yamamo2shun1/PICrouter/Eagle_Files/pdf/PICrouter_brd_all.pdf

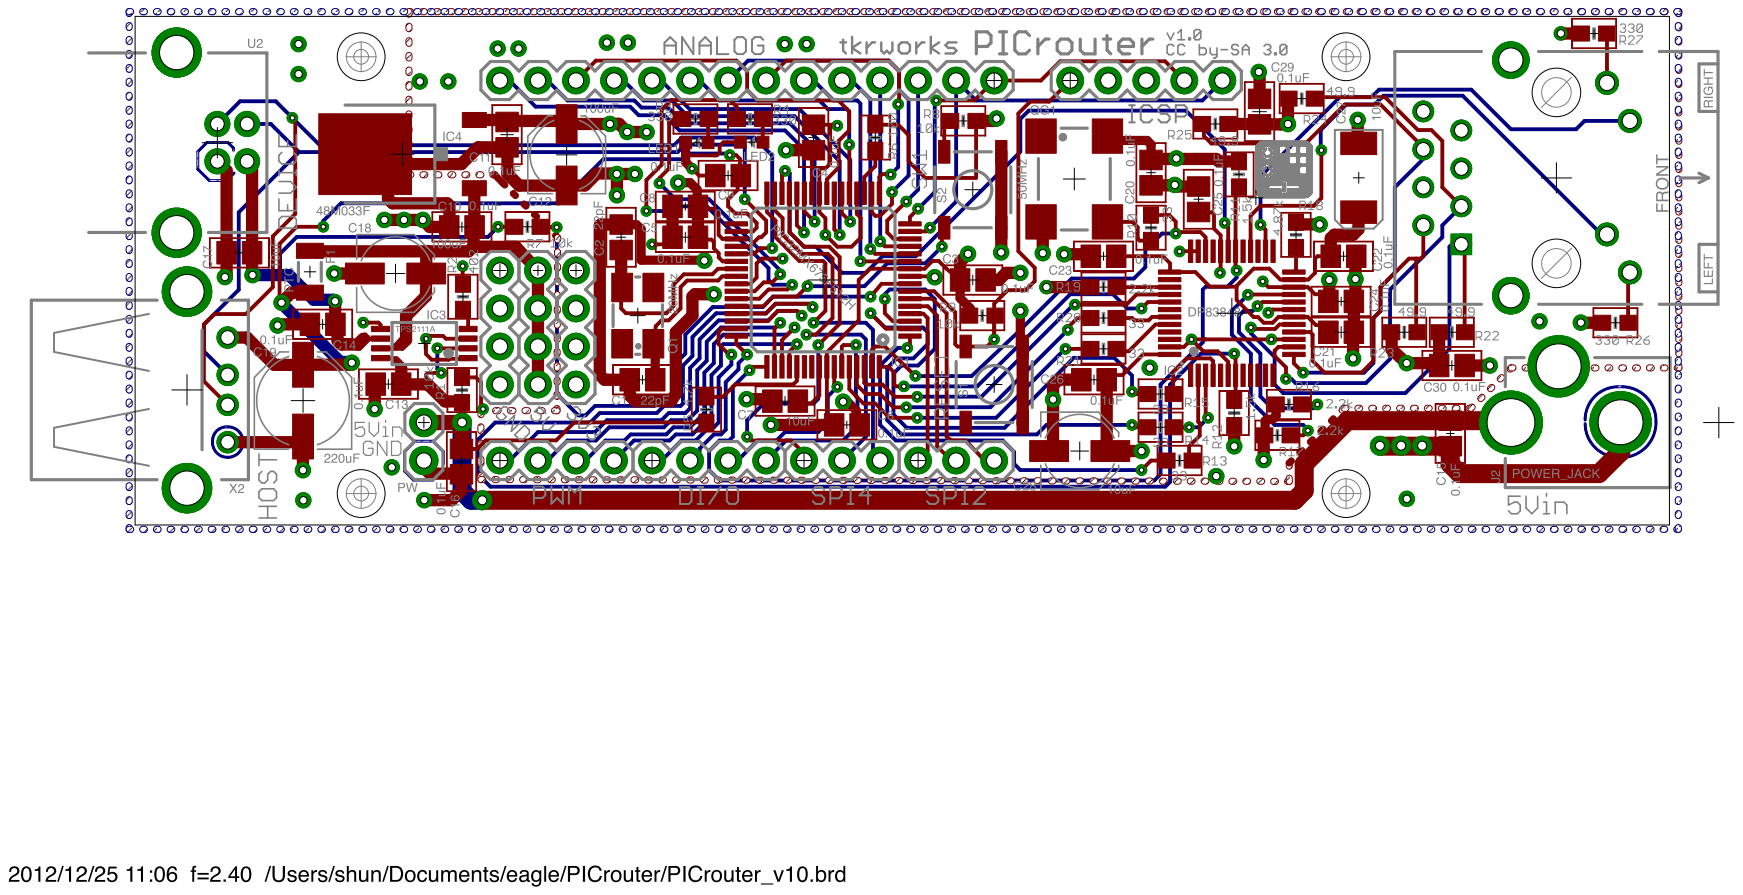
[picture p1: page 1]
