yamamo2shun1/PICrouter/Eagle_Files/pdf/PICrouter_brd_bottom.pdf

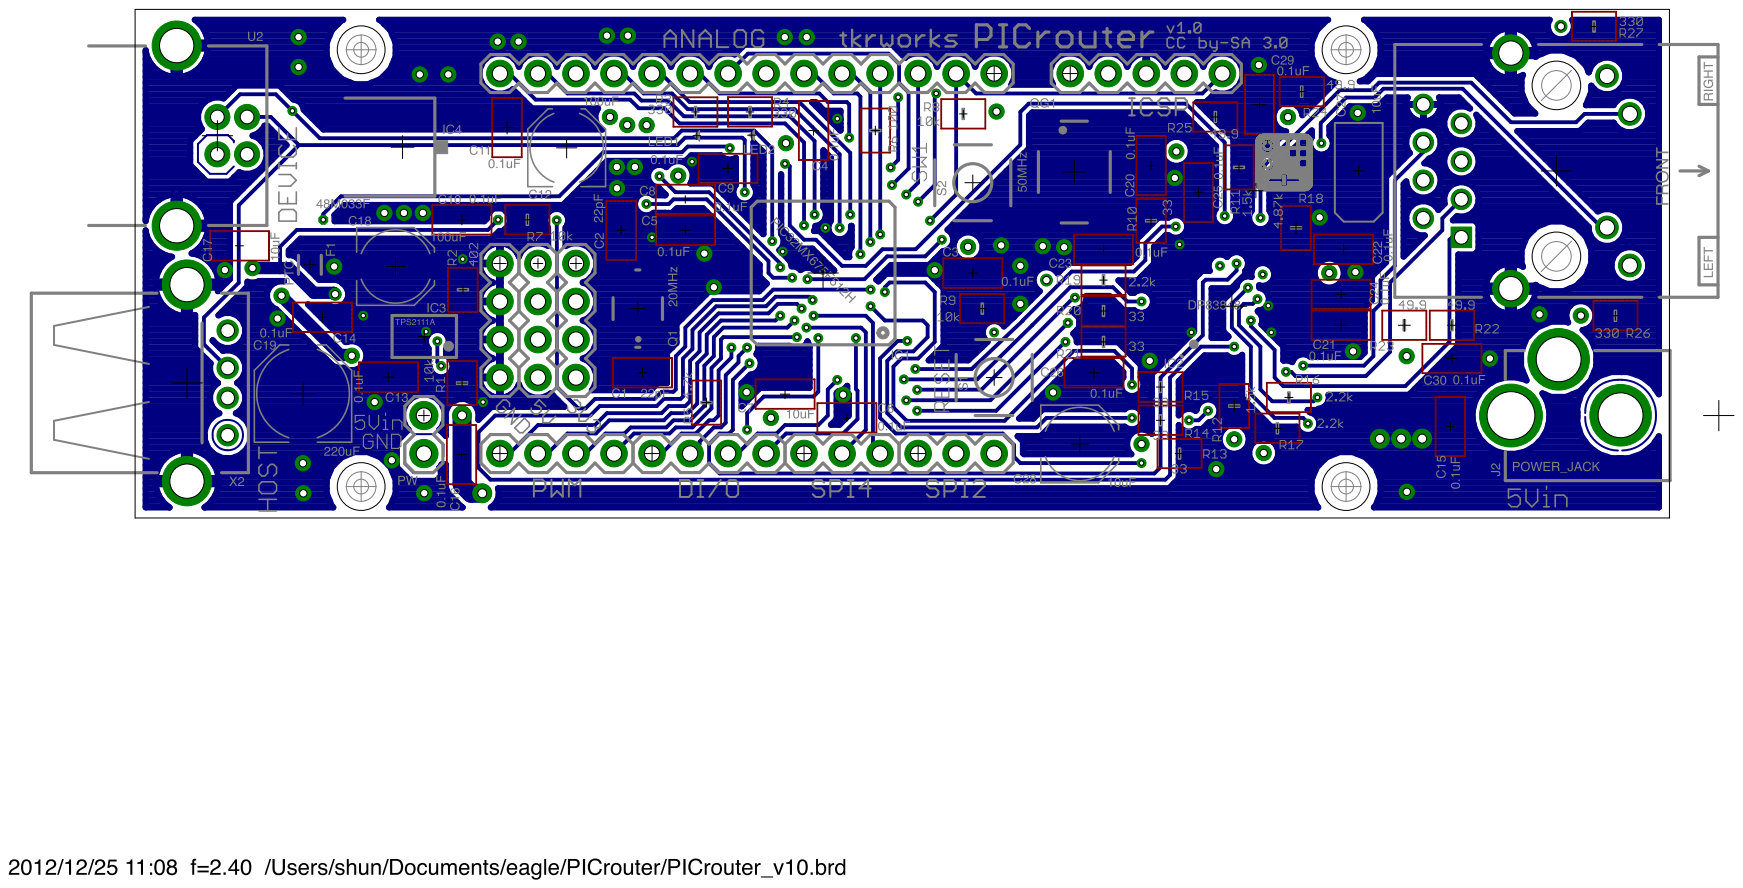
[picture p2: page 1]
