yamamo2shun1/PICrouter/Eagle_Files/pdf/PICrouter_brd_layer2.pdf

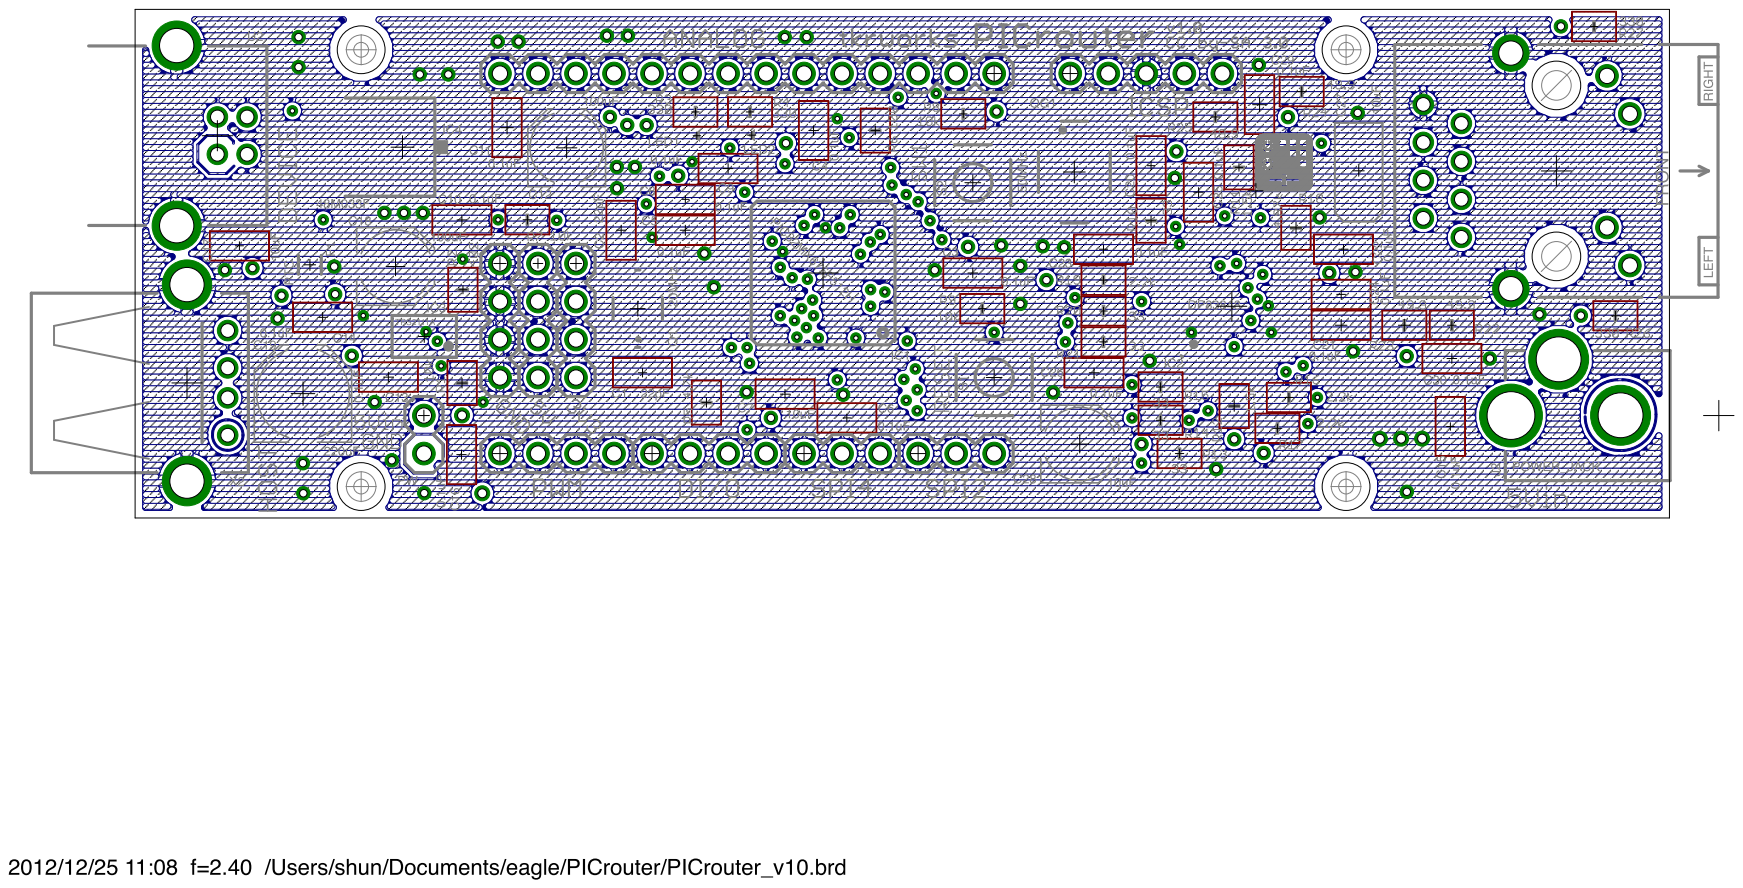
[picture p3: page 1]
