yamamo2shun1/PICrouter/Eagle_Files/pdf/PICrouter_brd_layer3.pdf

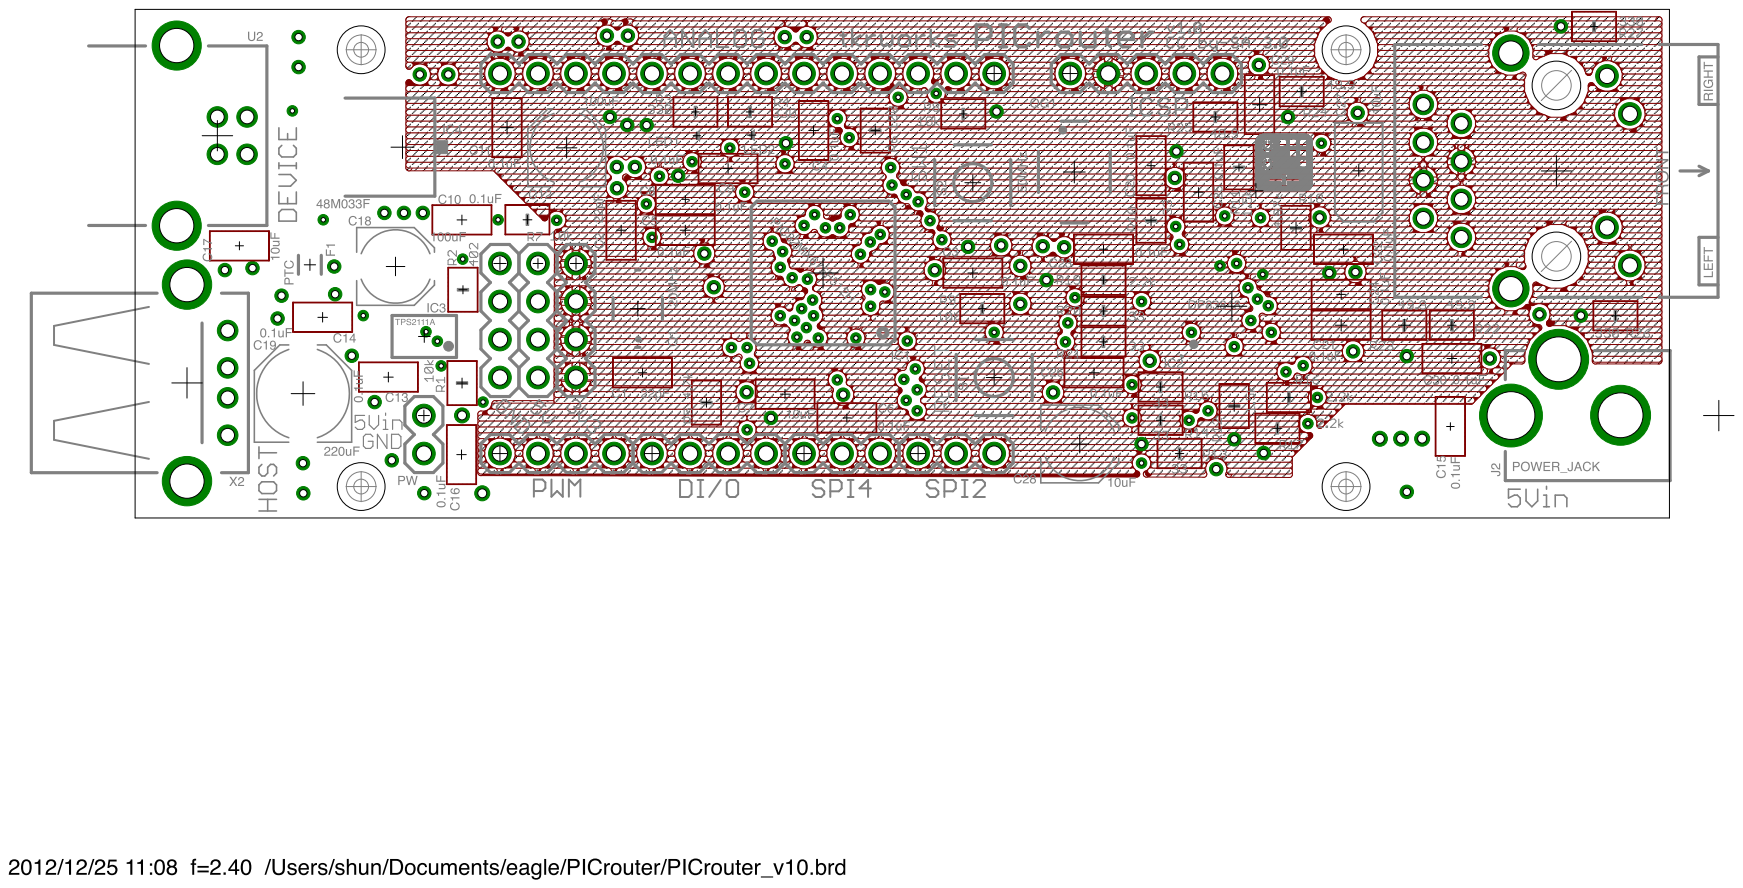
[picture p4: page 1]
