yamamo2shun1/PICrouter/Eagle_Files/pdf/PICrouter_brd_top.pdf

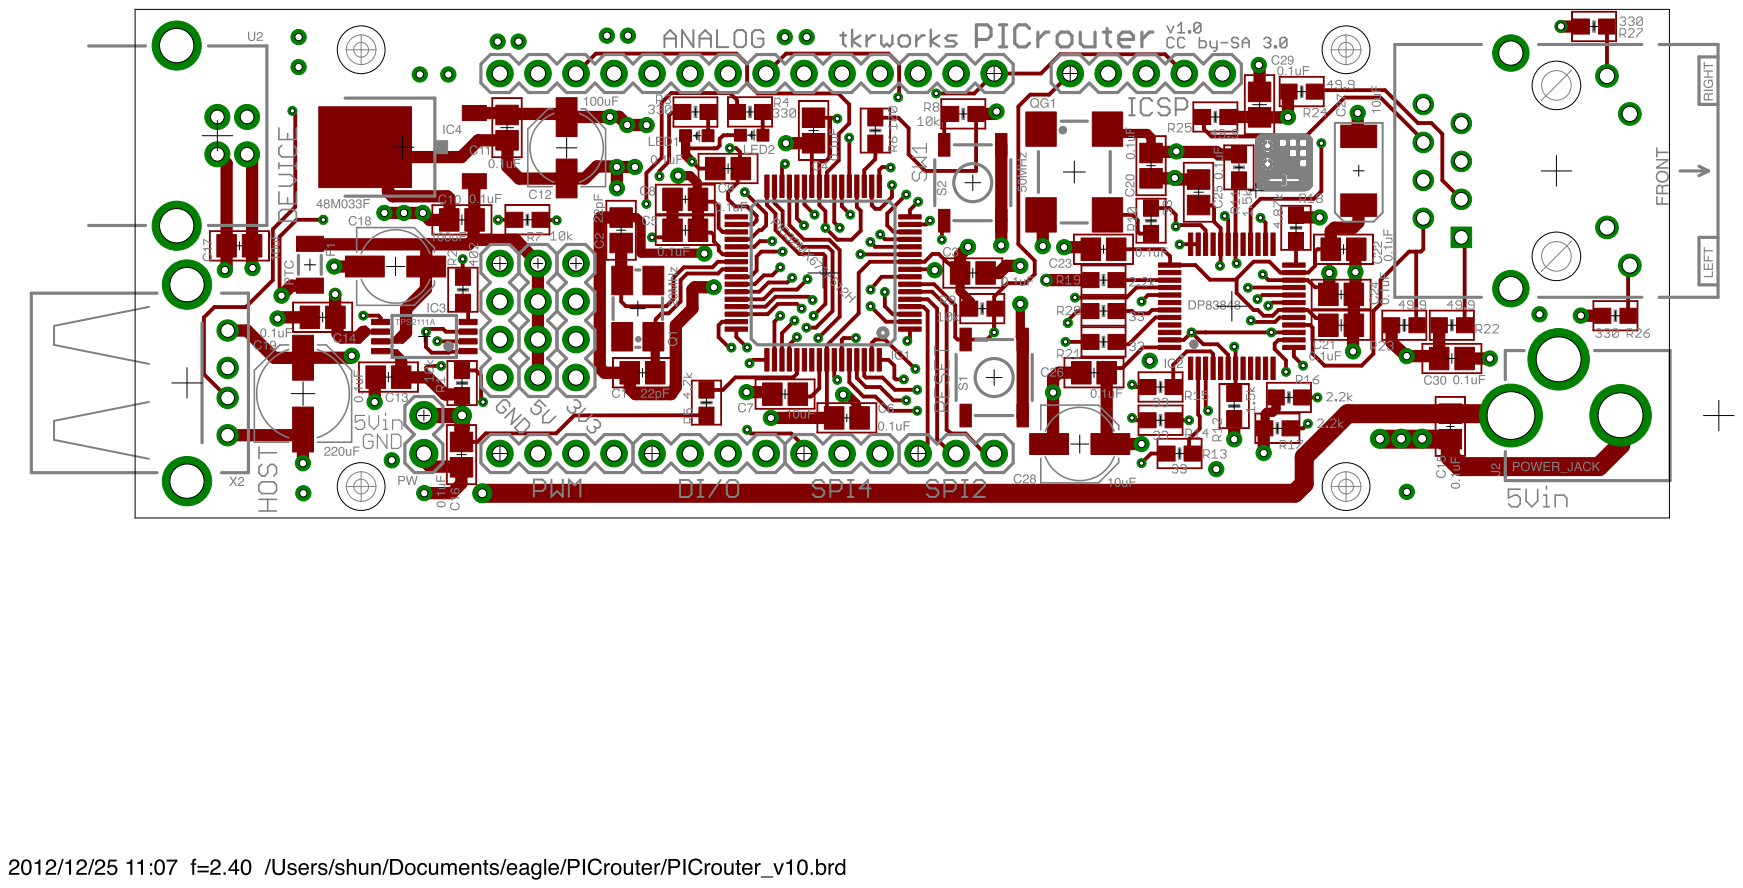
[picture p5: page 1]
