yamamo2shun1/PICrouter/Eagle_Files/pdf/PICrouter_sch_s0.pdf

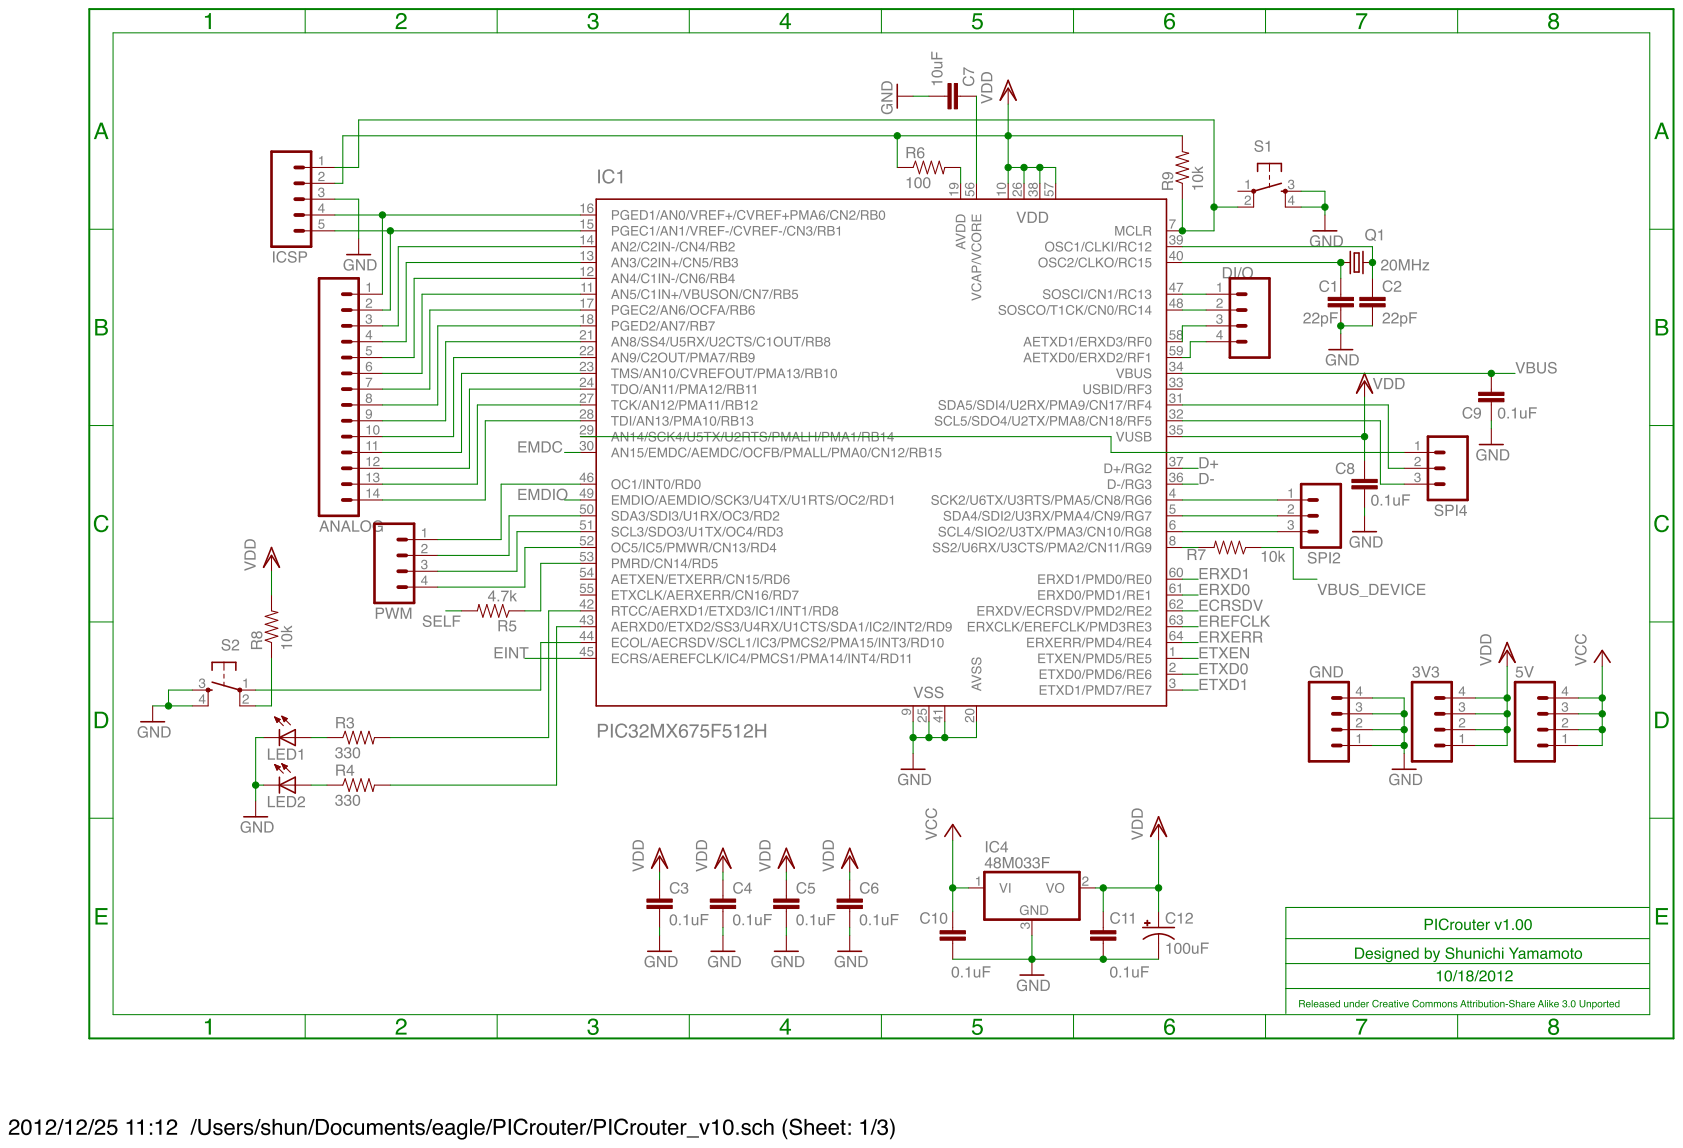
[picture p6: page 1]
