yamamo2shun1/PICrouter/Eagle_Files/pdf/PICrouter_sch_s1.pdf

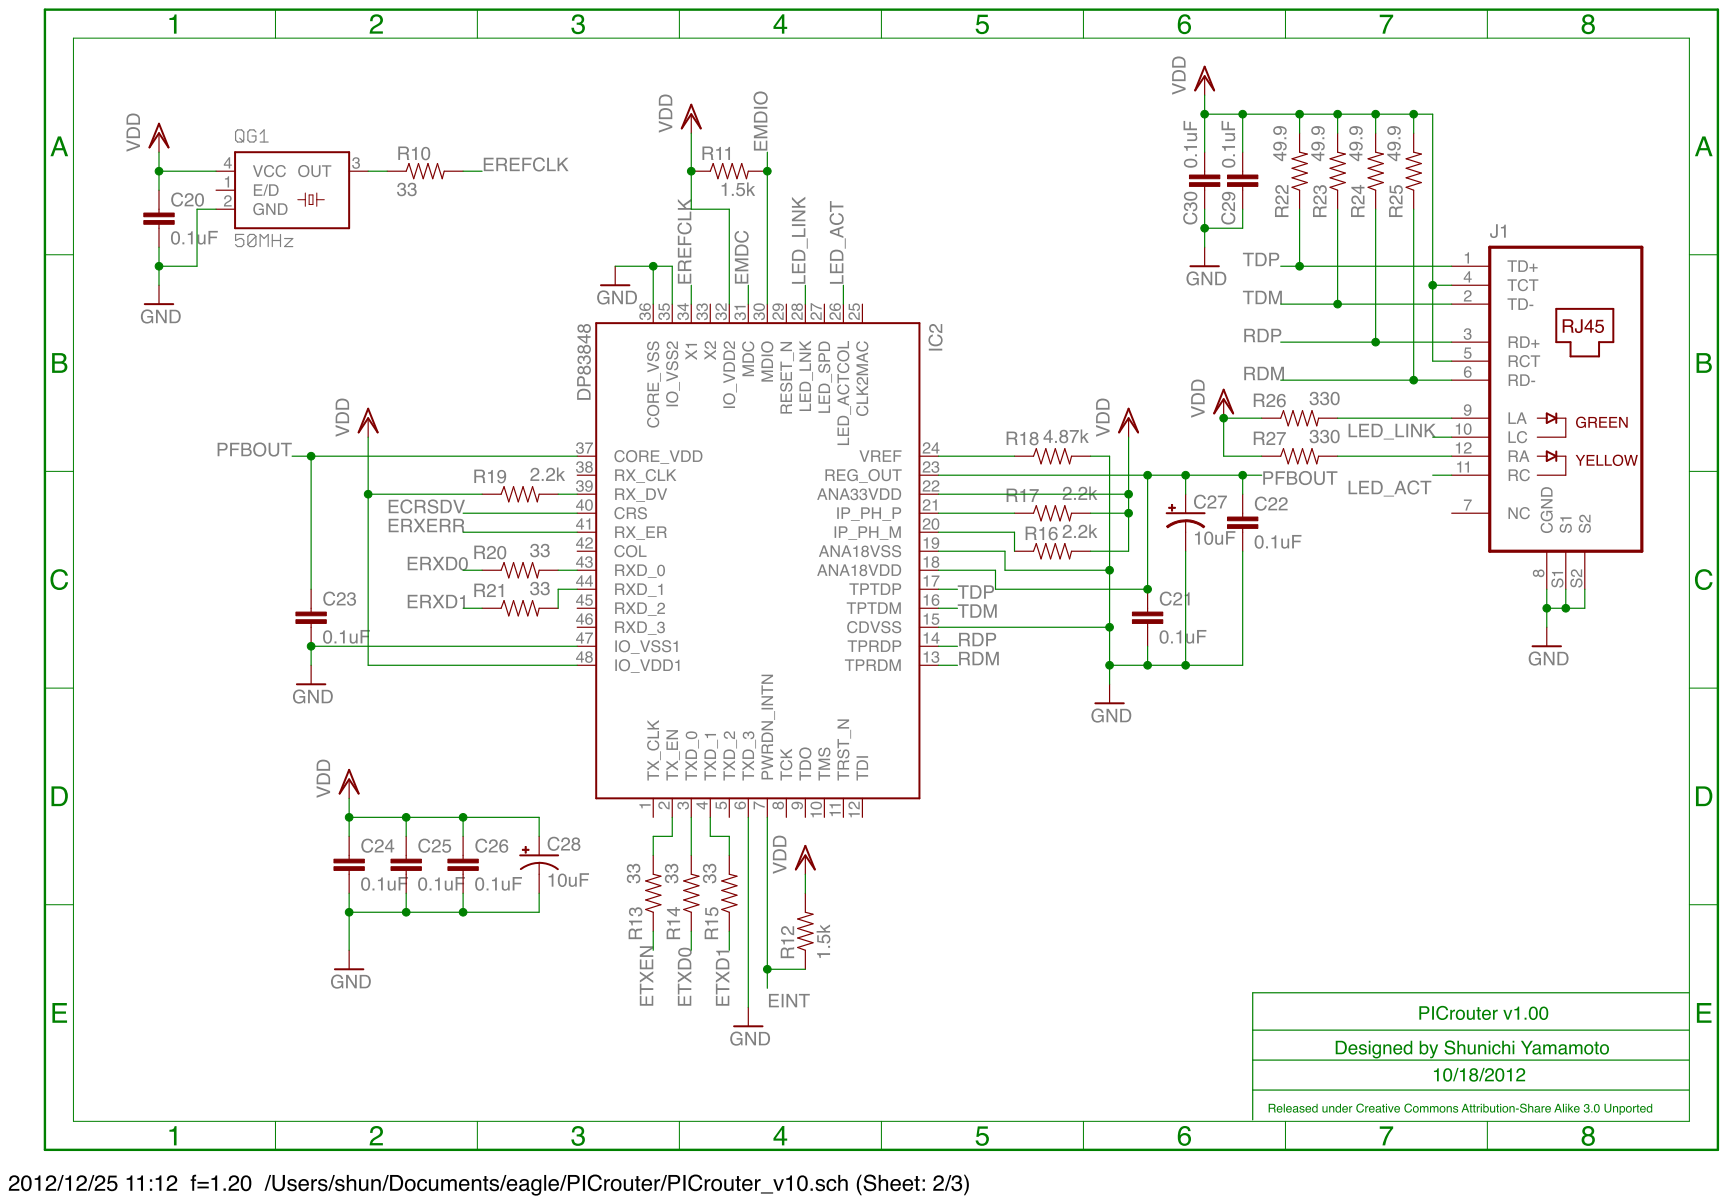
[picture p7: page 1]
