yamamo2shun1/PICrouter/Eagle_Files/pdf/PICrouter_sch_s2.pdf

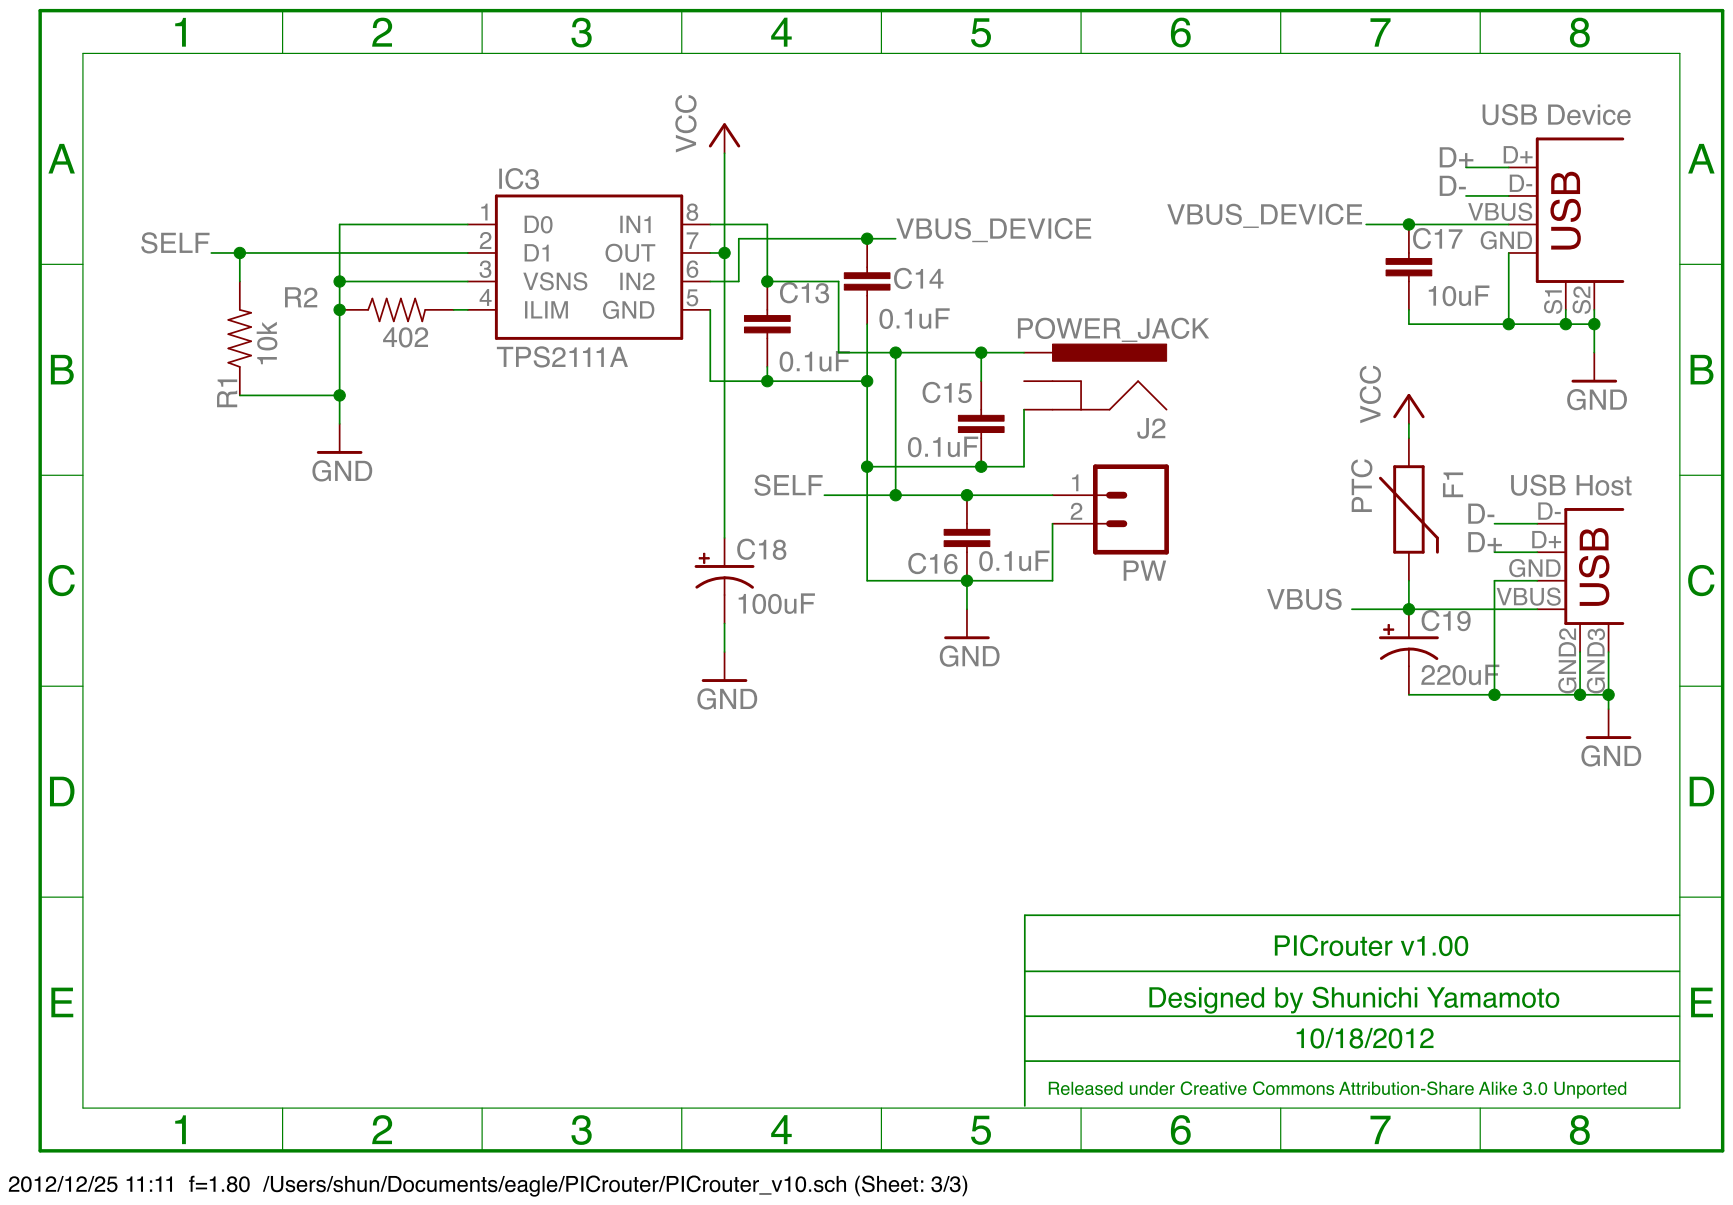
[picture p8: page 1]
