yamamo2shun1/PICrouter/Eagle_Files/PICrouter.brd

## EAGLE design Eagle_Files/PICrouter.brd (2012-12-25)

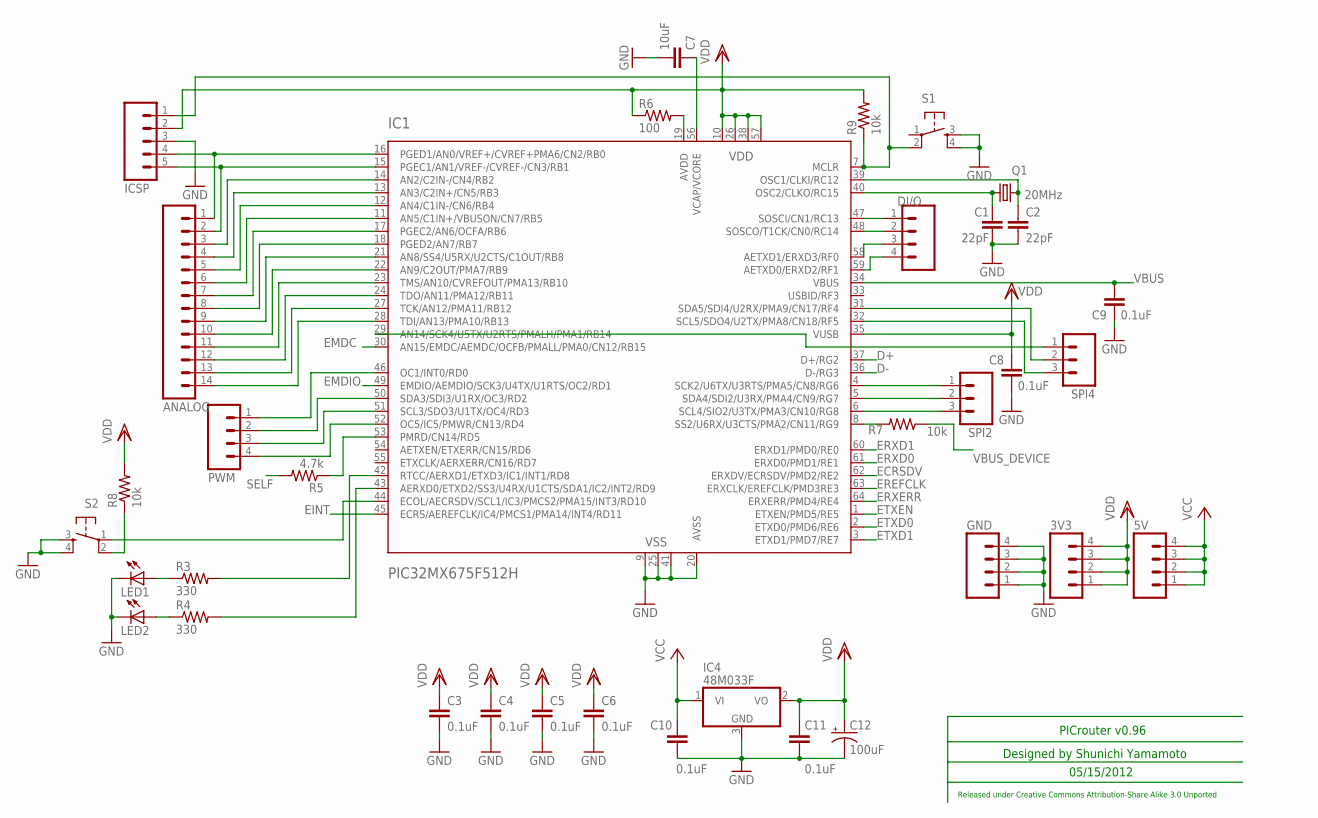
[picture p9: schematic PICrouter.sch, sheet 1]

Parts:
3V3, 5V: M04PTH; 1X04
ANALOG: M14; 1X14
C1, C2: 22pF; C2012
C3, C4, C5, C6, C8, C9, C10, C11: 0.1uF; C2012
C7: 10uF; C2012
C12: 100uF; PANASONIC_C
DI/O: M04PTH; 1X04
GND: M04PTH; 1X04
IC1: PIC32MX675F512H; TQFP64-10X10
IC4: 48M033F; TO252
ICSP: M05PTH; 1X05
LED1, LED2: LEDCHIP-LED0603; CHIP-LED0603
PWM: M04PTH; 1X04
Q1: 20MHz; CTS406
R3, R4: 330; 0603-RES
R5: 4.7k; 0603-RES
R6: 100; 0603-RES
R7, R8, R9: 10k; 0603-RES
S1, S2: TAC_SWITCHSMD; TACTILE_SWITCH_SMD
SPI2, SPI4: M03PTH; 1X03

Connections:
D+: IC1.37 (D+/RG2); also elsewhere on the board
D-: IC1.36 (D-/RG3); also elsewhere on the board
ECRSDV: IC1.62 (ERXDV/ECRSDV/PMD2/RE2); also elsewhere on the board
EINT: IC1.45 (ECRS/AEREFCLK/IC4/PMCS1/PMA14/INT4/RD11); also elsewhere on the board
EMDC: IC1.30 (AN15/EMDC/AEMDC/OCFB/PMALL/PMA0/CN12/RB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); also elsewhere on the board
EMDIO: IC1.49 (EMDIO/AEMDIO/SCK3/U4TX/U1RTS/OC2/RD1); also elsewhere on the board
EREFCLK: IC1.63 (ERXCLK/EREFCLK/PMD3RE3); also elsewhere on the board
ERXD0: IC1.61 (ERXD0/PMD1/RE1); also elsewhere on the board
ERXD1: IC1.60 (ERXD1/PMD0/RE0); also elsewhere on the board
ERXERR: IC1.64 (ERXERR/PMD4/RE4); also elsewhere on the board
ETXD0: IC1.2 (ETXD0/PMD6/RE6); also elsewhere on the board
ETXD1: IC1.3 (ETXD1/PMD7/RE7); also elsewhere on the board
ETXEN: IC1.1 (ETXEN/PMD5/RE5); also elsewhere on the board
GND: C1.2, C2.2, C3.2, C4.2, C5.2, C6.2, C7.2, C8.2, C9.1, C10.2, C11.2, C12.-, GND.1, GND.2, GND.3, GND.4, IC1.9 (GND), IC1.20 (AVSS), IC1.25 (GND), IC1.41 (GND), IC4.3 (GND), ICSP.3, LED1.C, LED2.C, S1.3, S1.4, S2.3, S2.4; also elsewhere on the board
unnamed: C2.1, IC1.39 (OSC1/CLKI/RC12), Q1.3 (2)
unnamed: C1.1, IC1.40 (OSC2/CLKO/RC15), Q1.1
unnamed: ANALOG.2, IC1.15 (PGEC1/AN1/VREF-/CVREF-/CN3/RB1), ICSP.5
unnamed: ANALOG.1, IC1.16 (PGED1/AN0/VREF+/CVREF+PMA6/CN2/RB0), ICSP.4
unnamed: IC1.7 (MCLR), ICSP.1, R9.1, S1.2
unnamed: C7.1, IC1.56 (VCAP/VCORE)
unnamed: R8.1, S2.2
unnamed: IC1.19 (AVDD), R6.2
unnamed: IC1.53 (PMRD/CN14/RD5), R5.1
unnamed: IC1.8 (SS2/U6RX/U3CTS/PMA2/CN11/RG9), R7.2
unnamed: IC1.42 (RTCC/AERXD1/ETXD3/IC1/INT1/RD8), R3.2
unnamed: IC1.43 (AERXD0/ETXD2/SS3/U4RX/U1CTS/SDA1/IC2/IN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), R4.2
unnamed: LED1.A, R3.1
unnamed: LED2.A, R4.1
unnamed: IC1.44 (ECOL/AECRSDV/SCL1/IC3/PMCS2/PMA15/INT3/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), S2.1
unnamed: ANALOG.3, IC1.14 (AN2/C2IN-/CN4/RB2)
unnamed: ANALOG.4, IC1.13 (AN3/C2IN+/CN5/RB3)
unnamed: ANALOG.5, IC1.12 (AN4/C1IN-/CN6/RB4)
unnamed: ANALOG.6, IC1.11 (AN5/C1IN+/VBUSON/CN7/RB5)
unnamed: ANALOG.7, IC1.17 (PGEC2/AN6/OCFA/RB6)
unnamed: ANALOG.8, IC1.18 (PGED2/AN7/RB7)
unnamed: ANALOG.9, IC1.21 (AN8/SS4/U5RX/U2CTS/C1OUT/RB8)
unnamed: ANALOG.10, IC1.22 (AN9/C2OUT/PMA7/RB9)
unnamed: ANALOG.11, IC1.23 (TMS/AN10/CVREFOUT/PMA13/RB10)
unnamed: ANALOG.12, IC1.24 (TDO/AN11/PMA12/RB11)
unnamed: ANALOG.13, IC1.27 (TCK/AN12/PMA11/RB12)
unnamed: ANALOG.14, IC1.28 (TDI/AN13/PMA10/RB13)
unnamed: IC1.4 (SCK2/U6TX/U3RTS/PMA5/CN8/RG6), SPI2.1
unnamed: IC1.5 (SDA4/SDI2/U3RX/PMA4/CN9/RG7), SPI2.2
unnamed: IC1.6 (SCL4/SIO2/U3TX/PMA3/CN10/RG8), SPI2.3
unnamed: IC1.31 (SDA5/SDI4/U2RX/PMA9/CN17/RF4), SPI4.2
unnamed: IC1.32 (SCL5/SDO4/U2TX/PMA8/CN18/RF5), SPI4.3
unnamed: IC1.29 (AN14/SCK4/U5TX/U2RTS/PMALH/PMA1/RB14), SPI4.1
unnamed: IC1.46 (OC1/INT0/RD0), PWM.1
unnamed: DI/O.1, IC1.47 (SOSCI/CN1/RC13)
unnamed: IC1.50 (SDA3/SDI3/U1RX/OC3/RD2), PWM.2
unnamed: IC1.51 (SCL3/SDO3/U1TX/OC4/RD3), PWM.3
unnamed: IC1.52 (OC5/IC5/PMWR/CN13/RD4), PWM.4
unnamed: DI/O.2, IC1.48 (SOSCO/T1CK/CN0/RC14)
unnamed: DI/O.3, IC1.58 (AETXD1/ERXD3/RF0)
unnamed: DI/O.4, IC1.59 (AETXD0/ERXD2/RF1)
SELF: R5.2; also elsewhere on the board
VBUS: C9.2, IC1.34 (VBUS); also elsewhere on the board
VBUS_DEVICE: R7.1; also elsewhere on the board
VCC: 5V.1, 5V.2, 5V.3, 5V.4, C10.1, IC4.1 (VI); also elsewhere on the board
VDD: 3V3.1, 3V3.2, 3V3.3, 3V3.4, C3.1, C4.1, C5.1, C6.1, C8.1, C11.1, C12.+, IC1.10 (VDD), IC1.26 (VDD), IC1.35 (VUSB), IC1.38 (VDD), IC1.57 (VDD), IC4.2 (VO), ICSP.2, R6.1, R8.2, R9.2; also elsewhere on the board

Notes on the sheet:
PICrouter v0.96
Designed by Shunichi Yamamoto
05/15/2012
Released under Creative Commons Attribution-Share Alike 3.0 Unported

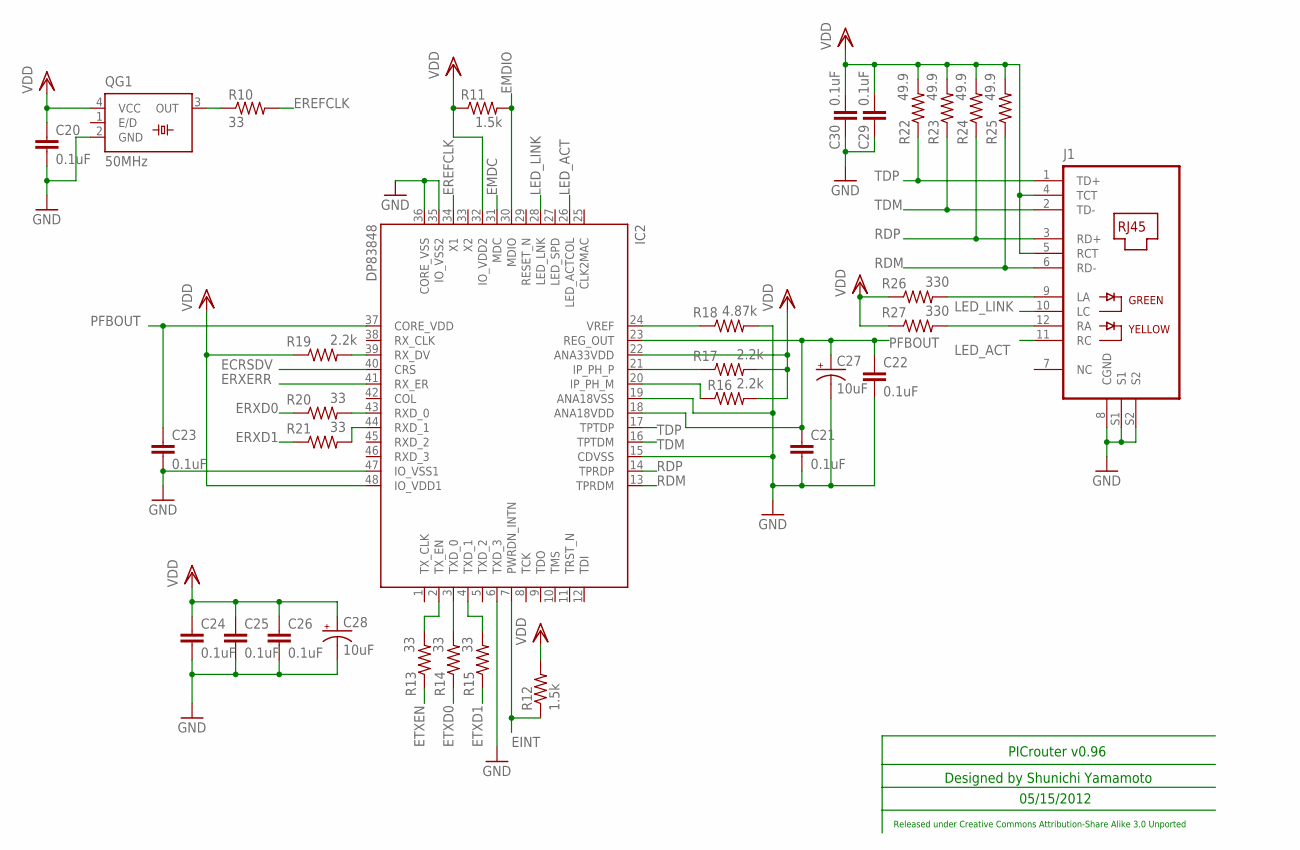
[picture p10: schematic PICrouter.sch, sheet 2]

Parts:
C20, C21, C22, C23, C24, C25, C26, C29, C30: 0.1uF; C2012
C27: 10uF; EIA6032
C28: 10uF; PANASONIC_C
IC2: DP83848; LQFP48
J1: J0011; PJ-J0
QG1: 50MHz; SM77H
R10, R13, R14, R15, R20, R21: 33; 0603-RES
R11, R12: 1.5k; 0603-RES
R16, R17, R19: 2.2k; 0603-RES
R18: 4.87k; 0603-RES
R22, R23, R24, R25: 49.9; 0603-RES
R26, R27: 330; 0603-RES

Connections:
ECRSDV: IC2.40 (CRS); also elsewhere on the board
EINT: IC2.7 (PWRDN_INTN), R12.1; also elsewhere on the board
EMDC: IC2.31 (MDC); also elsewhere on the board
EMDIO: IC2.30 (MDIO), R11.2; also elsewhere on the board
EREFCLK: IC2.34 (X1), R10.2; also elsewhere on the board
ERXD0: R20.1; also elsewhere on the board
ERXD1: R21.1; also elsewhere on the board
ERXERR: IC2.41 (RX_ER); also elsewhere on the board
ETXD0: R14.1; also elsewhere on the board
ETXD1: R15.1; also elsewhere on the board
ETXEN: R13.1; also elsewhere on the board
GND: C20.2, C21.2, C22.2, C23.2, C24.2, C25.2, C26.2, C27.P$2 (-), C28.-, C29.2, C30.2, IC2.6 (TXD_3), IC2.15 (CDVSS), IC2.19 (ANA18VSS), IC2.35 (IO_VSS2), IC2.36 (CORE_VSS), IC2.47 (IO_VSS1), J1.8 (CGND), J1.S1, J1.S2, QG1.2 (GND), R18.2; also elsewhere on the board
LED_ACT: IC2.26 (LED_ACTCOL), J1.11 (RC)
LED_LINK: IC2.28 (LED_LNK), J1.10 (LC)
unnamed: IC2.24 (VREF), R18.1
unnamed: IC2.21 (IP_PH_P), R17.1
unnamed: IC2.20 (IP_PH_M), R16.1
unnamed: IC2.39 (RX_DV), R19.2
unnamed: IC2.4 (TXD_1), R15.2
unnamed: IC2.3 (TXD_0), R14.2
unnamed: IC2.2 (TX_EN), R13.2
unnamed: J1.9 (LA), R26.2
unnamed: IC2.43 (RXD_0), R20.2
unnamed: IC2.44 (RXD_1), R21.2
unnamed: QG1.3 (OUT), R10.1
unnamed: J1.12 (RA), R27.2
PFBOUT: C21.1, C22.1, C23.1, C27.P$1 (+), IC2.18 (ANA18VDD), IC2.23 (REG_OUT), IC2.37 (CORE_VDD)
RDM: IC2.13 (TPRDM), J1.6 (RD-), R25.1
RDP: IC2.14 (TPRDP), J1.3 (RD+), R24.1
TDM: IC2.16 (TPTDM), J1.2 (TD-), R23.1
TDP: IC2.17 (TPTDP), J1.1 (TD+), R22.1
VDD: C20.1, C24.1, C25.1, C26.1, C28.+, C29.1, C30.1, IC2.22 (ANA33VDD), IC2.32 (IO_VDD2), IC2.48 (IO_VDD1), J1.4 (TCT), J1.5 (RCT), QG1.4 (VCC), R11.1, R12.2, R16.2, R17.2, R19.1, R22.2, R23.2, R24.2, R25.2, R26.1, R27.1; also elsewhere on the board

Notes on the sheet:
PICrouter v0.96
Designed by Shunichi Yamamoto
05/15/2012
Released under Creative Commons Attribution-Share Alike 3.0 Unported

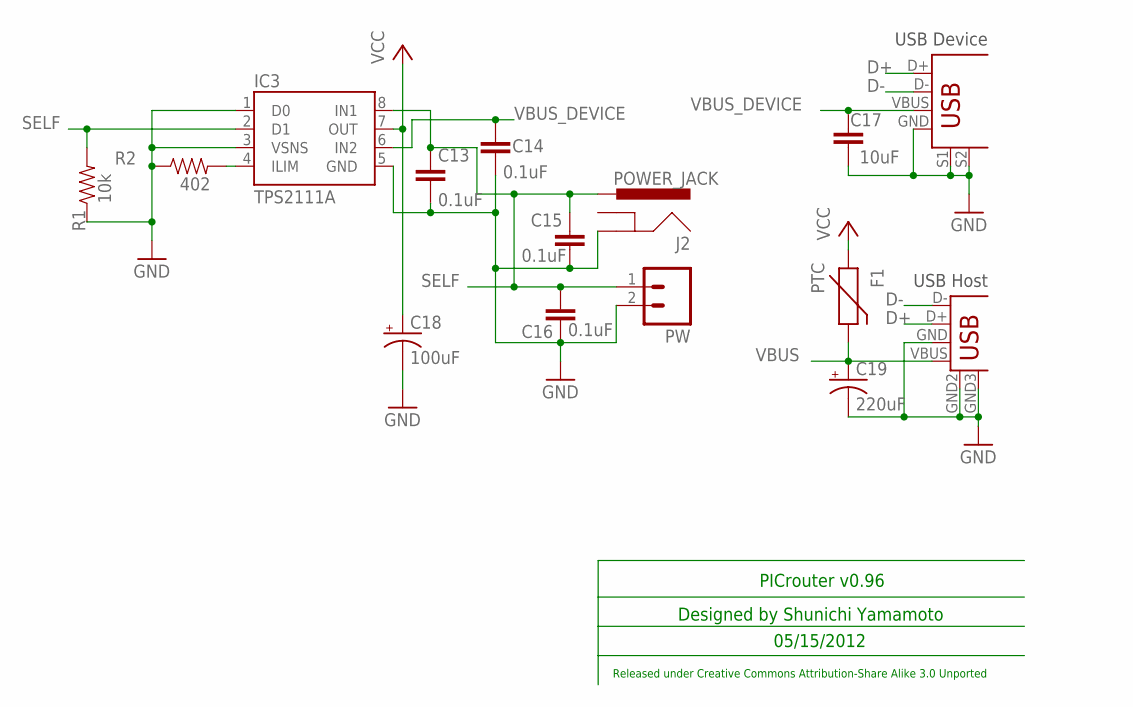
[picture p11: schematic PICrouter.sch, sheet 3]

Parts:
C13, C14, C15, C16: 0.1uF; C2012
C17: 10uF; C2012
C18: 100uF; PANASONIC_C
C19: 220uF; PANASONIC_D
F1: PTC; PTC-1206
IC3: TPS2111A; TSSOP8
J2: POWER_JACK; POWER_JACK_PTH_LOCK
PW: M02PTH; 1X02
R1: 10k; 0603-RES
R2: 402; 0603-RES
U2: DEVICE; USB-B-PTH
X2: USB-A-H

Connections:
D+: U2.D+, X2.D+; also elsewhere on the board
D-: U2.D-, X2.D-; also elsewhere on the board
GND: C13.2, C14.2, C15.2, C16.2, C17.2, C18.-, C19.-, IC3.1 (D0), IC3.3 (VSNS), IC3.5 (GND), J2.GND, PW.2, R1.1, R2.1, U2.GND, U2.S1, U2.S2, X2.GND, X2.GND2 (S1), X2.GND3 (S2); also elsewhere on the board
unnamed: IC3.4 (ILIM), R2.2
SELF: C13.1, C15.1, C16.1, IC3.2 (D1), IC3.8 (IN1), J2.PWR, PW.1, R1.2; also elsewhere on the board
VBUS: C19.+, F1.2, X2.VBUS; also elsewhere on the board
VBUS_DEVICE: C14.1, C17.1, IC3.6 (IN2), U2.VBUS; also elsewhere on the board
VCC: C18.+, F1.1, IC3.7 (OUT); also elsewhere on the board

Notes on the sheet:
USB Device
USB Host
PICrouter v0.96
Designed by Shunichi Yamamoto
05/15/2012
Released under Creative Commons Attribution-Share Alike 3.0 Unported

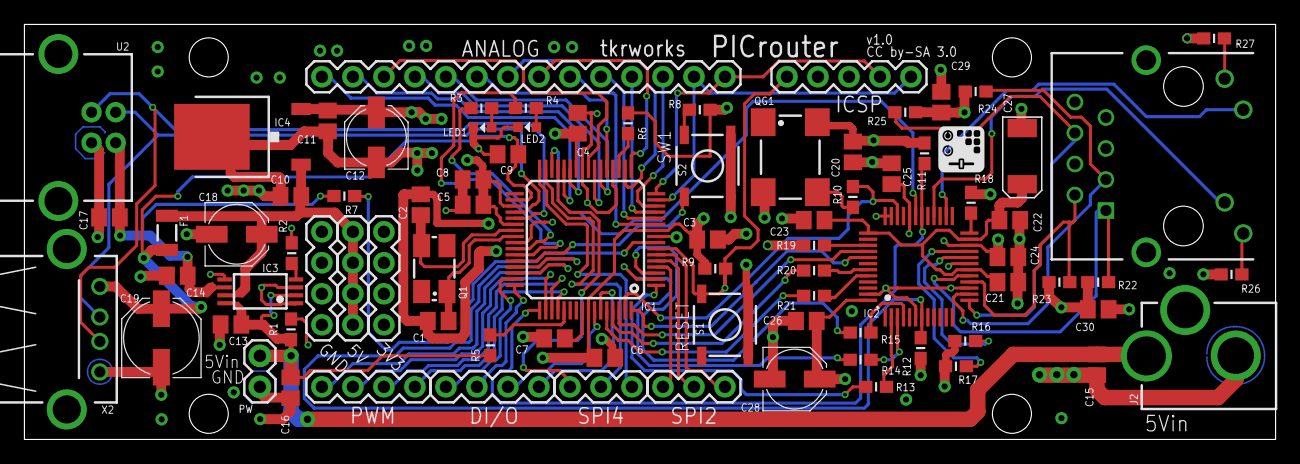
[picture p12: board PICrouter.brd from above]

Board: 4 copper layers, 102.5 x 34.0 mm, 83 parts (0 on the bottom side), 80 nets.

Other parts of the board:
U$1: LOGO
