yamamo2shun1/PICrouter/PICrouter.X/picrouter.c

/*
 * Copylight (C) 2012, Shunichi Yamamoto, tkrworks.net
 *
 * This file is part of PICrouter.
 *
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
 * picrouter.c,v.1.15.0 2014/06/17
 */

#include "picrouter.h"

static BYTE sendOSCTaskIndex = 0;
static BYTE swState0 = 0;
static BYTE swState1 = 0;

void _general_exception_handler(unsigned cause, unsigned status)
{
    Nop();
    Nop();
}

int main(int argc, char** argv) {
    int i;
    BYTE eth_state = 0;
    
    // Enable optimal performance
    SYSTEMConfigPerformance(GetSystemClock());
    mOSCSetPBDIV(OSC_PB_DIV_1); // Use 1:1 CPU Core:Peripheral clocks
    
    // Enable the cache for the best performance
    CheKseg0CacheOn();

    DelayMs(100);
    mJTAGPortEnable(DEBUG_JTAGPORT_OFF);

    // Port Initialization
    initIOPorts();
    initAnalogVariables();
    initEncoderVariables();

#ifdef USE_SPI_SRAM
    initSPI2ForSRAM();
#endif

    initSW();
    initLEDs();
    buttonInit();

    stateFlag = FALSE;
    prevState = 1;
    currentState = 1;

    turnOnLED1();
    turnOnLED2();
    DelayMs(200);

    // PWM
    freq = 10000; // 10kHz
    width = GetSystemClock() / freq;
#if 0//c99
    for(int i0 = 0; i0 < PWM_NUM; i0++)
        duty[i0] = 50;
#else
    for(i = 0; i < PWM_NUM; i++)
        duty[i] = 50;
#endif

#if defined(USE_RN131)
    turnOnLED1();
    turnOnLED2();
    DelayMs(3000);
    turnOffLED1();
    turnOffLED2();

    // the C13 pin is connected to RESET pin of the WiFly RN-131C.
    outputPort("c13", LOW);
    DelayMs(100);
    outputPort("c13", HIGH);
    DelayMs(500);

    // if the SW1 is pushed, the following configuration commands are sent.
    if(!getSW1State())
    {
        U2MODE = 0x8208;
        U2STA = 0x0400;
        //U2BRG = baud115200;
        U2BRG = baud230400;
        //U2BRG = baud9600;

        DelayMs(500);
        sendCommandToRN134("$$$");
        sendCommandToRN134("factory RESET\r");
        //sendCommandToRN134("set uart baud 460800\r\n");
        sendCommandToRN134("set uart baud 230400\r\n");
        //sendCommandToRN134("set uart baud 115200\r\n");
        //sendCommandToRN134("set uart baud 57600\r\n");
        //sendCommandToRN134("set uart baud 38400\r");
        //sendCommandToRN134("set uart baud 19200\r");
        //sendCommandToRN134("set uart baud 9600\r");
        //sendCommandToRN134("set uart baud 4800\r\n");
        sendCommandToRN134("set uart flow 0x01");
        sendCommandToRN134("set wlan join 1\r");
        sendCommandToRN134("set wlan auth 3\r");
#if 0
        sendCommandToRN134("set wlan ssid tkrworks$HOME$Network\r");
        sendCommandToRN134("set wlan pass t@ke32z@6r@i\r");
        sendCommandToRN134("set ip host 192.168.1.2\r");
#else
        sendCommandToRN134("set wlan ssid PINGPONG\r");
        sendCommandToRN134("set wlan pass m@tsumotot@iyo\r");
        sendCommandToRN134("set ip host 172.16.1.11\r");
#endif
#if 0
        sendCommandToRN134("set wlan ssid YOUR_SSID\r");
        sendCommandToRN134("set wlan pass YOUR_PASSWORD\r");
        sendCommandToRN134("set ip host YOUR_IP\r");
#endif
        sendCommandToRN134("set ip protocol 1\r");
        sendCommandToRN134("set ip remote 10001\r");
        sendCommandToRN134("set ip localport 10100\r");
        sendCommandToRN134("set broadcast interval 0\r");
        sendCommandToRN134("set comm remote 0\r");
        sendCommandToRN134("set comm open 0\r");
        sendCommandToRN134("save\r");
        sendCommandToRN134("reboot\r");
    }

    U2MODE = 0x8208;
    U2STA = 0x1400;
    U2BRG = baud230400;
    //U2BRG = baud115200;
    ConfigIntUART2(configint);
#endif

#if defined(USE_LSD_BLE112)
    U2MODE = 0x8208;
    U2STA = 0x1400;
    U2BRG = baud115200;
    ConfigIntUART2(configint);
#endif

#if defined(USE_CC3000)
    init0("d0", "d2", "d3");
#endif

    setOSCPrefix("/std");
    setOSCHostName("picrouter");

    // USB Initialization
#if defined(USE_USB_BUS_SENSE_IO)
    tris_usb_bus_sense = 1;
#endif

#if defined(USE_SELF_POWER_SENSE_IO)
    tris_self_power = 1;
#endif

#if defined(USE_PITCH)
    AD1PCFG = 0x0000FFFC;// 0000 0000 0000 0000 1111 1111 1111 1100
    AD1CON2 = 0x0000041C;// 0000 0000 0000 0000 0000 0100 0001 1100
    AD1CSSL = 0x00000003;// 0000 0000 0000 0000 0000 0000 0000 0011

    AD1CON1 = 0x000010E6;// 0000 0000 0000 0000 1000 0000 0110 0110
    AD1CHS  = 0x00000000;// 0000 0000 0000 0000 0000 0000 0000 0000
    AD1CON3 = 0x00001F08;// 0000 0000 0000 0000 0000 1111 0000 1000
    AD1CON1bits.ON = 1;

    setAnalogEnable(0, TRUE);
    setAnalogEnable(1, TRUE);
#endif

#if defined(USE_RGB_PAD_8L)
    // Set Connected Board Number
    setNumConnectedLatticeRgb(2);
    // LED Driver Initialization
    setLatticePadPortLoadName("d4");
    setPortIOType(getLatticePadPortLoadName(), IO_OUT);
    outputPort(getLatticePadPortLoadName(), LOW);
    setLatticeRgbDriverSpiNumber(2);
    //SpiChnOpen(SPI_CHANNEL2, SPICON_MSTEN | SPICON_SMP | SPICON_MODE16 | SPICON_CKE | SPICON_ON, 4);
    SpiChnOpen(SPI_CHANNEL2, SPICON_MSTEN | SPICON_SMP | SPICON_MODE16 | SPICON_CKE | SPICON_ON, 5);
    setInitLatticeRgbDrvFlag(TRUE);

    // Button Pad Initialization
    setLatticePadPortClkName(0, "f0");
    setPortIOType(getLatticePadPortClkName(0), IO_OUT);
    setLatticePadPortShLdName(0, "c14");
    setPortIOType(getLatticePadPortShLdName(0), IO_OUT);
    setLatticePadPortQhName(0, "c13");
    setPortIOType(getLatticePadPortQhName(0), IO_IN);
    setInitPadFlag(TRUE);
#endif

setPortIOType("b10", IO_OUT);
setPortIOType("b11", IO_OUT);
setPortIOType("b12", IO_OUT);
setPortIOType("b13", IO_OUT);
outputPort("b10", LOW);
outputPort("b11", LOW);
outputPort("b12", LOW);
outputPort("b13", LOW);

#if defined(USE_DAC_PLUS_ADC)
    // for AD5328
    outputPort("d0", HIGH);// SYNC1
    outputPort("d2", HIGH);// SYNC2
    outputPort("d3", HIGH);// SYNC3
    outputPort("d4", LOW);// LDAC

    // for AD7490
    setPortIOType("g7", IO_IN);
    outputPort("c13", HIGH);// CS

    // for ADG1414
    outputPort("c14", HIGH);// SYNC
    outputPort("f0", HIGH);// RESET
    Nop();
    outputPort("f0", LOW);// RESET
    Nop();
    outputPort("f0", HIGH);// RESET

    //SpiChnOpen(SPI_CHANNEL2, SPICON_MSTEN | SPICON_SMP | SPICON_MODE16 | SPICON_CKP | SPICON_CKE | SPICON_ON, 7);
    SpiChnOpen(SPI_CHANNEL2, SPICON_MSTEN | SPICON_MODE16 | SPICON_ON, 39); // SPI Clock = 1MHz
    //SpiChnOpen(SPI_CHANNEL2, SPICON_MSTEN | SPICON_SMP | SPICON_MODE16 | SPICON_CKP | SPICON_ON, 23);
    //SpiChnOpen(SPI_CHANNEL2, SPICON_MSTEN | SPICON_SMP | SPICON_CKP | SPICON_CKE | SPICON_ON, 23);

#if defined(USE_AD7490)
    DelayMs(1);
    receiveDataFromAD7490(0xFFFF);
    receiveDataFromAD7490(0xFFFF);
    receiveDataFromAD7490(0x8310);
#endif

#if defined(USE_AD5328)
    sendDataToAD5328(0, 0x800F);// 1 00 0000000 00 00 11 -> 1000 0000 0000 1111
    sendDataToAD5328(0, 0xA000);// 1 01 00000000000 00   -> 1010 0000 0000 0000
    sendDataToAD5328(0, 0xC000);// 1 10 00000 00000000   -> 1100 0000 0000 0000

    sendDataToAD5328(1, 0x800F);// 1 00 0000000 00 00 11 -> 1000 0000 0000 1111
    sendDataToAD5328(1, 0xA000);// 1 01 00000000000 00   -> 1010 0000 0000 0000
    sendDataToAD5328(1, 0xC000);// 1 10 00000 00000000   -> 1100 0000 0000 0000
    
    sendDataToAD5328(2, 0x800F);// 1 00 0000000 00 00 11 -> 1000 0000 0000 1111
    sendDataToAD5328(2, 0xA000);// 1 01 00000000000 00   -> 1010 0000 0000 0000
    sendDataToAD5328(2, 0xC000);// 1 10 00000 00000000   -> 1100 0000 0000 0000
#endif

#endif

#if defined(USE_ADG1414)
    sendDataToADG1414(0x0000);
#endif

    TickInit();
    InitAppConfig();
    StackInit();
    //syama ZeroconfLLInitialize();
    mDNSInitialize(getOSCHostName());
    mDNSServiceRegister((const char *)getOSCHostName(), // base name of the service
                        "_oscit._udp.local",       // type of the service
                        8080,                      // TCP or UDP port, at which this service is available
                        ((const BYTE *)""),        // TXT info
                        1,                         // auto rename the service when if needed
                        NULL,                      // no callback function
                        NULL                       // no application context
                        );
    mDNSMulticastFilterRegister();

    OpenTimer4(T4_ON | T4_SOURCE_INT | T4_PS_1_8, TIMER4_COUNT);
    ConfigIntTimer4(T4_INT_ON | T4_INT_PRIOR_5);

    OpenTimer5(T5_ON | T5_SOURCE_INT | T5_PS_1_8, TIMER5_COUNT);
    ConfigIntTimer5(T5_INT_ON | T5_INT_PRIOR_4);

    // Enable multi-vectored interrupts
    INTEnableSystemMultiVectoredInt();

#if defined(USE_CC3000)
    if(!init())
    {
        while(TRUE)
        {
            toggleLED2();
            DelayMs(100);
        }
    }
    if(!connectCC3000("PINGPONG", WLAN_SEC_WPA2, "m@tsumotot@iyo", 30000))
    {
        while(TRUE)
        {
            toggleLED1();
            DelayMs(100);
        }
    }

#endif

#if defined(USE_RGB_PAD_8L)
    // Initial LED Sequence

    // step 0
    // RED
    setLatticeRgbOn(0, 0, TRUE);
    setLatticeRgb(0, 0, ((1 <<  0) << (0 * 4)));
    setLatticeRgbIntensity(0, 0, 0 + (0 * 4), 1);
    DelayMs(10);

    // step 1
    // RED
    setLatticeRgbIntensity(0, 0, 0 + (0 * 4), 5);
    DelayMs(10);
    // GREEN
    setLatticeRgbOn(0, 1, TRUE);
    setLatticeRgb(0, 1, ((1 <<  0) << (0 * 4)));
    setLatticeRgbIntensity(0, 1, 0 + (0 * 4), 1);
    DelayMs(10);

    // step 2
    // RED
    setLatticeRgbIntensity(0, 0, 0 + (0 * 4), 10);
    setLatticeRgb(0, 0, getLatticeRgb(0, 0) | ((1 <<  1) << (0 * 4)));
    setLatticeRgb(0, 0, getLatticeRgb(0, 0) | ((1 <<  0) << (1 * 4)));
    setLatticeRgbIntensity(0, 0, 1 + (0 * 4), 1);
    setLatticeRgbIntensity(0, 0, 0 + (1 * 4), 1);
    DelayMs(10);
    // GREEN
    setLatticeRgbIntensity(0, 1, 0 + (0 * 4), 5);
    DelayMs(10);
    // BLUE
    setLatticeRgbOn(0, 2, TRUE);
    setLatticeRgb(0, 2, ((1 <<  0) << (0 * 4)));
    setLatticeRgbIntensity(0, 2, 0 + (0 * 4), 1);
    DelayMs(10);

    // step 3
    // RED
    setLatticeRgbIntensity(0, 0, 0 + (0 * 4), 25);
    setLatticeRgbIntensity(0, 0, 1 + (0 * 4), 5);
    setLatticeRgbIntensity(0, 0, 0 + (1 * 4), 5);
    DelayMs(10);
    // GREEN
    setLatticeRgbIntensity(0, 1, 0 + (0 * 4), 10);
    setLatticeRgb(0, 1, getLatticeRgb(0, 1) | ((1 <<  1) << (0 * 4)));
    setLatticeRgb(0, 1, getLatticeRgb(0, 1) | ((1 <<  0) << (1 * 4)));
    setLatticeRgbIntensity(0, 1, 1 + (0 * 4), 1);
    setLatticeRgbIntensity(0, 1, 0 + (1 * 4), 1);
    DelayMs(10);
    // BLUE
    setLatticeRgbIntensity(0, 2, 0 + (0 * 4), 5);
    DelayMs(10);

    // step 4
    // RED
    setLatticeRgbIntensity(0, 0, 0 + (0 * 4), 50);
    setLatticeRgbIntensity(0, 0, 1 + (0 * 4), 10);
    setLatticeRgbIntensity(0, 0, 0 + (1 * 4), 10);
    setLatticeRgb(0, 0, getLatticeRgb(0, 0) | ((1 <<  2) << (0 * 4)));
    setLatticeRgb(0, 0, getLatticeRgb(0, 0) | ((1 <<  1) << (1 * 4)));
    setLatticeRgbIntensity(0, 0, 2 + (0 * 4), 1);
    setLatticeRgbIntensity(0, 0, 1 + (1 * 4), 1);
    DelayMs(10);
    // GREEN
    setLatticeRgbIntensity(0, 1, 0 + (0 * 4), 25);
    setLatticeRgbIntensity(0, 1, 1 + (0 * 4), 5);
    setLatticeRgbIntensity(0, 1, 0 + (1 * 4), 5);
    DelayMs(10);
    // BLUE
    setLatticeRgbIntensity(0, 2, 0 + (0 * 4), 10);
    setLatticeRgb(0, 2, getLatticeRgb(0, 2) | ((1 <<  1) << (0 * 4)));
    setLatticeRgb(0, 2, getLatticeRgb(0, 2) | ((1 <<  0) << (1 * 4)));
    setLatticeRgbIntensity(0, 2, 1 + (0 * 4), 1);
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
    setLatticeRgbOn(0, 2, FALSE);
#endif

    turnOffLED1();
    turnOffLED2();
    DelayMs(200);
    
    while(1)
    {
        currentState = getSW1State();

        if(prevState != currentState)
        {
            stateFlag = TRUE;
            stateFlag2 = TRUE;
        }

        switch(device_mode)
        {
        case MODE_DEVICE:
            for(i = 0; i < 3; i++)
            {
                turnOnLED1();
                DelayMs(200);
                turnOffLED1();
                DelayMs(200);
            }
            
            USBDeviceInit();
            
            while(device_mode == MODE_DEVICE)
            {
                // Ethernet Tasks
                StackTask();
                switch(eth_state)
                {
                case 0:
#if 0
                    NBNSTask();
                    eth_state = 1;
                    break;
                case 1:
                    ZeroconfLLProcess();
                    eth_state = 1;// 2;
                    break;
                case 1:// 2:
#endif
                    mDNSProcess();
                    eth_state = 1;// 3;
                    break;
                case 1:// 3:
                    DHCPServerTask();
                    eth_state = 0;
                    break;
                }
                if(dwLastIP != AppConfig.MyIPAddr.Val)
                {
                    dwLastIP = AppConfig.MyIPAddr.Val;
                    mDNSFillHostRecord();
                }
                
                receiveOSCTask();
                
                // USB Tasks
                USBDeviceTasks();
                USBControlTask();
                
                if(U1OTGSTATbits.SESVD == 0)
                {
                    USBSoftDetach();
                    //test device_mode = MODE_UNKNOWN;
                }
            }
            break;
        case MODE_HOST:
            for(i = 0; i < 3; i++)
            {
                turnOnLED2();
                DelayMs(200);
                turnOffLED2();
                DelayMs(200);
            }
            
            while(device_mode == MODE_HOST)
            {
                StackTask();
                switch(eth_state)
                {
                case 0:
#if 0
                    NBNSTask();
                    eth_state = 1;
                    break;
                case 1:
                    ZeroconfLLProcess();
                    eth_state = 1;// 2;
                    break;
                case 1:// 2:
#endif
                    mDNSProcess();
                    eth_state = 1;// 3;
                    break;
                case 1:// 3:
                    DHCPServerTask();
                    eth_state = 0;
                    break;
                }
                if(dwLastIP != AppConfig.MyIPAddr.Val)
                {
                    dwLastIP = AppConfig.MyIPAddr.Val;
                    mDNSFillHostRecord();
                }
                
                receiveOSCTask();
                
                if(bUsbHostInitialized)
                {
                    USBTasks();

#if defined(USB_USE_MIDI)
                    convertMidiToOsc();
#endif

#if defined(USB_USE_HID)
                    convertHidToOsc();
#elif defined(USB_USE_CDC)
                    USB_CDC_RxTxHandler();
                    
                    if(cdcReceiveInterval < 16384)
                        cdcReceiveInterval++;
                    else if(cdcReceiveInterval == 16384)
                    {
                        if(getApplCDCState() == READY_TO_TX_RX)
                            setApplCDCState(GET_IN_DATA);
                        cdcReceiveInterval = 0;
                    }
#endif
                }
                else
                {
                    bUsbHostInitialized = USBHostInit(0);
                }
            }
            break;
        default:
            break;
        }        
    }
    return (EXIT_SUCCESS);
}

/**********************************************
*  OSC Generic I/O Processing Part
**********************************************/
/*******************************************************************************
  Function:
    void initIOPorts(void)

  Precondition:


  Summary:


  Description:


  Parameters:
    None

  Return Values:
    None

  Remarks:
    None
*******************************************************************************/
void initIOPorts(void)
{
    int i = 0;

    for(i = 0; i < 14; i++)
        setAnPortDioType(i, IO_IN);

#if defined(USE_PITCH)
    //for pitch
    setAnPortDioType(0, IO_IN);
    setAnPortDioType(1, IO_IN);
    for(i = 2; i < 14; i++)
        setAnPortDioType(i, IO_OUT);

    outputPort("b2", LOW);
    outputPort("b3", LOW);
    outputPort("b4", LOW);
    outputPort("b5", LOW);
    outputPort("b6", LOW);
    outputPort("b7", LOW);
    outputPort("b8", LOW);
    outputPort("b9", LOW);
    outputPort("b10", LOW);
    outputPort("b11", LOW);
    outputPort("b12", LOW);
#endif

    for(i = 0; i < 4; i++)
    {
        setPwmPortDioType(i, IO_OUT);
        outputPwmPort(i, LOW);
    }

    for(i = 0; i < 4; i++)
    {
        setDigitalPortDioType(i, IO_OUT);
        outputDigitalPort(i, LOW);
    }

#if defined(USE_PITCH)
    setDigitalPortDioType(0, IO_OUT);
    outputDigitalPort(0, LOW);
    setDigitalPortDioType(0, IO_OUT);
    outputDigitalPort(0, LOW);

    setPortIOType("f0", IO_IN);
    setPortIOType("f1", IO_OUT);
    outputPort("f1", LOW);
    setPortIOType("b14", IO_IN);
    setPortIOType("f4", IO_OUT);
    outputPort("f4", LOW);
    setPortIOType("f5", IO_IN);
    setPortIOType("g6", IO_OUT);
    outputPort("g6", LOW);
    setPortIOType("g7", IO_IN);
    setPortIOType("g8", IO_OUT);
    outputPort("g8", LOW);
#endif

    setSpiPortDioType("sck2", IO_OUT);
    setSpiPortDioType("sdi2", IO_OUT);
    setSpiPortDioType("sdo2", IO_OUT);
    setSpiPortDioType("sck4", IO_OUT);
    setSpiPortDioType("sdi4", IO_OUT);
    setSpiPortDioType("sdo4", IO_OUT);
    outputSpiPort("sck2", LOW);
    outputSpiPort("sdi2", LOW);
    outputSpiPort("sdo2", LOW);
    outputSpiPort("sck4", LOW);
    outputSpiPort("sdi4", LOW);
    outputSpiPort("sdo4", LOW);
}

/*******************************************************************************
  Function:
    void receiveOSCTask(void)

  Precondition:


  Summary:


  Description:


  Parameters:
    None

  Return Values:
    None

  Remarks:
    None
*******************************************************************************/
void receiveOSCTask(void)
{
    BYTE index;
    int i, j, k;
    //debug static BYTE testNum = 0;

    //mT4IntEnable(0);
    //mT5IntEnable(0);

    getOSCPacket();

#if 0
    BYTE count = 0;
    BOOL flag = FALSE;
    while(U2STAbits.URXDA)
    {
        setOSCPacketFromRN134(count++, U2RXREG);
        flag = TRUE;
        Delay10us(50);
    }
    if(flag)
        incRingBufIndex();
    setUartInterruptFlag(FALSE);
#endif

    if(processOSCPacket())
    {
        //debug LED_2_On();

        if(compareOSCPrefix(getOSCPrefix()))
        {
            if(compareOSCAddress(msgOnboardLed))
            {
                if(!(compareTypeTagAtIndex(0, 'i') || compareTypeTagAtIndex(0, 'f')) || !compareTypeTagAtIndex(1, 's'))
                {
                    sendOSCMessage(sysPrefix, msgError, "ss", msgOnboardLed, ": wrong_argument_type");
                    return;
                }

                if(getIntArgumentAtIndex(0) == 0)
                {
                    if(!strcmp(getStringArgumentAtIndex(1), "on"))
                    {
                        turnOnLED1();
                    }
                    else if(!strcmp(getStringArgumentAtIndex(1), "off"))
                    {
                        turnOffLED1();
                    }
                    else
                        sendOSCMessage(sysPrefix, msgError, "ss", msgOnboardLed, ": wrong_argument_string");
                }
                else if(getIntArgumentAtIndex(0) == 1)
                {
                    if(!strcmp(getStringArgumentAtIndex(1), "on"))
                    {
                        turnOnLED2();
                    }
                    else if(!strcmp(getStringArgumentAtIndex(1), "off"))
                    {
                        turnOffLED2();
                    }
                    else
                        sendOSCMessage(sysPrefix, msgError, "ss", msgOnboardLed, ": wrong_argument_string");
                }
                else
                    sendOSCMessage(sysPrefix, msgError, "ss", msgOnboardLed, ": wrong_argument_value");
            }
            // Port
            else if(compareOSCAddress(msgSetPortIO))
            {
                char* port_name;
                char* type;
 
                if(compareTypeTagAtIndex(0, 's') && compareTypeTagAtIndex(1, 's'))
                {
                    port_name = getStringArgumentAtIndex(0);
                    if(!comparePortNameAtIndex(port_name))
                    {
                        sendOSCMessage(sysPrefix, msgError, "ss", msgSetPortIO, ": wrang_argument_string");
                        return;
                    }
                    type = getStringArgumentAtIndex(1);
                }
                else
                {
                    sendOSCMessage(sysPrefix, msgError, "ss", msgSetPortIO, ": wrong_argument_type");
                    return;
                }

                if(!strcmp(type, "in"))
                {
                    setPortIOType(port_name, IO_IN);
                }
                else if(!strcmp(type, "out"))
                {
                    setPortIOType(port_name, IO_OUT);
                    outputPort(port_name, LOW);
                }
            }
            else if(compareOSCAddress(msgGetPortIO))
            {
                char* port_name;

                if(compareTypeTagAtIndex(0, 's'))
                {
                    port_name = getStringArgumentAtIndex(0);
                    if(!comparePortNameAtIndex(port_name))
                    {
                        sendOSCMessage(sysPrefix, msgError, "ss", msgGetPortIO, ": wrang_argument_string");
                        return;
                    }
                }
                else
                {
                    sendOSCMessage(sysPrefix, msgError, "ss", msgGetPortIO, ": wrong_argument_type");
                    return;
                }

                if(getPortIOType(port_name))
                    sendOSCMessage(getOSCPrefix(), msgPortIO, "ss", port_name, "in");
                else
                    sendOSCMessage(getOSCPrefix(), msgPortIO, "ss", port_name, "out");
            }
            else if(compareOSCAddress(msgSetPortOut))
            {
                char* port_name;
                char* state;

                if(compareTypeTagAtIndex(0, 's') && compareTypeTagAtIndex(1, 's'))
                {
                    port_name = getStringArgumentAtIndex(0);
                    if(!comparePortNameAtIndex(port_name))
                    {
                        sendOSCMessage(sysPrefix, msgError, "ss", msgSetPortOut, ": wrang_argument_string");
                        return;
                    }
                    state = getStringArgumentAtIndex(1);
                    if(strcmp(state, "high") && strcmp(state, "low"))
                    {
                        sendOSCMessage(sysPrefix, msgError, "ss", msgSetPortOut, ": wrong_argument_string");
                        return;
                    }
                }
                else
                {
                    sendOSCMessage(sysPrefix, msgError, "ss", msgSetPortOut, ": wrong_argument_type");
                    return;
                }

                if(!strcmp(state, "high"))
                    outputPort(port_name, HIGH);
                else if(!strcmp(state, "low"))
                    outputPort(port_name, LOW);
            }
            else if(compareOSCAddress(msgGetPortIn))
            {
                char* port_name;

                if(compareTypeTagAtIndex(0, 's'))
                {
                    port_name = getStringArgumentAtIndex(0);
                    if(!comparePortNameAtIndex(port_name))
                    {
                        sendOSCMessage(sysPrefix, msgError, "ss", msgGetPortIn, ": wrang_argument_string");
                        return;
                    }
                }
                else
                {
                    sendOSCMessage(sysPrefix, msgError, "ss", msgGetPortIn, ": wrong_argument_type");
                    return;
                }

                BYTE state = inputPort(port_name);

                if(state)
                    sendOSCMessage(getOSCPrefix(), msgPortIn, "ss", port_name, "high");
                else
                    sendOSCMessage(getOSCPrefix(), msgPortIn, "ss", port_name, "low");
            }
            // A/D
            else if(compareOSCAddress(msgSetAdcEnable))
            {
                AD1CON1bits.ON = 0;

                BYTE id, anum;
                char* state;

                if((compareTypeTagAtIndex(0, 'i') || compareTypeTagAtIndex(0, 'f')) && compareTypeTagAtIndex(1, 's'))
                {
                    id = getIntArgumentAtIndex(0);
                    if(id > AN_NUM - 1)
                    {
                        sendOSCMessage(sysPrefix, msgError, "ss", msgSetAdcEnable, ": out_of_value_range");
                        return;
                    }
                    state = getStringArgumentAtIndex(1);
                }
                else
                {
                    sendOSCMessage(sysPrefix, msgError, "ss", msgSetAdcEnable, ": wrong_argument_type");
                    return;
                }

                if(!strcmp(state, "on"))
                {
                    setAnalogEnable(id, TRUE);
                    setAnPortDioType(id, IO_IN);

                    AD1PCFG &= ~(0x0001 << id);
                    AD1CSSL |= (0x0001 << id);
                }
                else if(!strcmp(state, "off"))
                {
                    setAnalogEnable(id, FALSE);
                    setAnPortDioType(id, IO_IN);

                    AD1PCFG |= (0x0001 << id);
                    AD1CSSL &= ~(0x0001 << id);
                }
                else
                {
                    sendOSCMessage(sysPrefix, msgError, "ss", msgSetAdcEnable, ": wrong_argument_string");
                    return;
                }

                anum = 0;
                for(i = 0; i < AN_NUM; i++)
                {
                    if(getAnalogEnable(i))
                        anum++;
                }

                if(anum > 0)
                {
                    AD1CON2 = 0x00000400;// 0000 0000 0000 0000 0000 0000 0100 0000
                    AD1CON2 |= ((anum - 1) << 2);
                    AD1CON3 = 0x00001F08;// 0000 0000 0000 0000 0001 1111 0000 1000
                    AD1CHS  = 0x00000000;// 0000 0000 0000 0000 0000 0000 0000 0000
                    AD1CON1 = 0x000080E6;// 0000 0000 0000 0000 1000 0000 1110 0110
                }
                else
                {
                    AD1PCFG = 0x0000FFFF;// 0000 0000 0000 0000 1111 1111 1111 1111
                    AD1CSSL = 0x00000000;// 0000 0000 0000 0000 0000 0000 0000 0000

                    AD1CON2 = 0x00000000;// 0000 0000 0000 0000 0000 0000 0000 0000
                    AD1CON3 = 0x00001F08;// 0000 0000 0000 0000 0001 1111 0000 1000
                    AD1CHS  = 0x00000000;// 0000 0000 0000 0000 0000 0000 0000 0000
                    AD1CON1 = 0x00000000;// 0000 0000 0000 0000 1000 0000 0000 0000
                }
            }
            else if(compareOSCAddress(msgGetAdcEnable))
            {
                BYTE id;

                if((compareTypeTagAtIndex(0, 'i') || compareTypeTagAtIndex(0, 'f')))
                {
                    id = getIntArgumentAtIndex(0);
                    if(id > AN_NUM - 1)
                    {
                        sendOSCMessage(sysPrefix, msgError, "ss", msgGetAdcEnable, ": out_of_value_range");
                        return;
                    }
                }
                else
                {
                    sendOSCMessage(sysPrefix, msgError, "ss", msgGetAdcEnable, ": wrong_argument_type");
                    return;
                }

                if(getAnalogEnable(id))
                    sendOSCMessage(getOSCPrefix(), msgAdcEnable, "is", id, "on");
                else
                    sendOSCMessage(getOSCPrefix(), msgAdcEnable, "is", id, "off");
            }
            else if(compareOSCAddress(msgSetAdcType))
            {
                BYTE id;
                char* type = NULL;

                if(getArgumentsLength() != 2)
                {
                    sendOSCMessage(sysPrefix, msgError, "ss", msgSetAdcType, ": must_be_2_arguments");
                    return;
                }

                if((compareTypeTagAtIndex(0, 'i') || compareTypeTagAtIndex(0, 'f')) && compareTypeTagAtIndex(1, 's'))
                {
                    id = getIntArgumentAtIndex(0);

                    if(id > AN_NUM - 1)
                    {
                        sendOSCMessage(sysPrefix, msgError, "ss", msgSetAdcType, ": out_of_value_range");
                        return;
                    }

                    type = getStringArgumentAtIndex(1);

                    if(!strcmp(type, "8bit"))
                    {
                        setAnalogType(id, BYTE_ORIGINAL);
                    }
                    else if(!strcmp(type, "10bit"))
                    {
                        setAnalogType(id, WORD_ORIGINAL);
                    }
                    else
                    {
                        sendOSCMessage(sysPrefix, msgError, "ss", msgSetAdcType, ": must_be_8bit_or_10bit");
                        return;
                    }
                }
                else
                {
                    sendOSCMessage(sysPrefix, msgError, "ss", msgSetAdcType, ": wrong_argument_type");
                    return;
                }
            }
            else if(compareOSCAddress(msgGetAdcType))
            {
                BYTE id;

                if(getArgumentsLength() != 1)
                {
                    sendOSCMessage(sysPrefix, msgError, "ss", msgGetAdcType, ": must_be_1_argument");
                    return;
                }

                if((compareTypeTagAtIndex(0, 'i') || compareTypeTagAtIndex(0, 'f')))
                {
                    id = getIntArgumentAtIndex(0);
                    if(id > AN_NUM - 1)
                    {
                        sendOSCMessage(sysPrefix, msgError, "ss", msgGetAdcType, ": out_of_value_range");
                        return;
                    }
                }
                else
                {
                    sendOSCMessage(sysPrefix, msgError, "ss", msgGetAdcType, ": wrong_argument_type");
                    return;
                }

                switch(getAnalogType(id))
                {
                    case BYTE_ORIGINAL:
                        sendOSCMessage(getOSCPrefix(), msgAdcType, "is", id, "8bit");
                        break;
                    case WORD_ORIGINAL:
                        sendOSCMessage(getOSCPrefix(), msgAdcType, "is", id, "10bit");
                        break;
                    default:
                        sendOSCMessage(sysPrefix, msgError, "ss", msgGetAdcType, ": may_be_other_setting");
                        break;
                }
            }
            else if(compareOSCAddress(msgSetAdcDio))
            {
                BYTE id;
                char* type;
 
                if((compareTypeTagAtIndex(0, 'i') || compareTypeTagAtIndex(0, 'f')) && compareTypeTagAtIndex(1, 's'))
                {
                    id = getIntArgumentAtIndex(0);
                    if(id > AN_NUM - 1)
                    {
                        sendOSCMessage(sysPrefix, msgError, "ss", msgSetAdcDio, ": out_of_value_range");
                        return;
                    }
                    type = getStringArgumentAtIndex(1);
                }
                else
                {
                    sendOSCMessage(sysPrefix, msgError, "ss", msgSetAdcDio, ": wrong_argument_type");
                    return;
                }

                if(!strcmp(type, "in"))
                {
                    setAnPortDioType(id, IO_IN);
                }
                else if(!strcmp(type, "out"))
                {
                    setAnPortDioType(id, IO_OUT);
                    outputAnPort(id, 0);
                }
            }
            else if(compareOSCAddress(msgGetAdcDio))
            {
                BYTE id;
                if((compareTypeTagAtIndex(0, 'i') || compareTypeTagAtIndex(0, 'f')))
                {
                    id = getIntArgumentAtIndex(0);
                    if(id > AN_NUM - 1)
                    {
                        sendOSCMessage(sysPrefix, msgError, "ss", msgGetAdcDio, ": out_of_value_range");
                        return;
                    }
                }
                else
                {
                    sendOSCMessage(sysPrefix, msgError, "ss", msgGetAdcDio, ": wrong_argument_type");
                    return;
                }

                if(getAnPortDioType(id))
                    sendOSCMessage(getOSCPrefix(), msgAdcDio, "is", id, "in");
                else
                    sendOSCMessage(getOSCPrefix(), msgAdcDio, "is", id, "out");
            }
            else if(compareOSCAddress(msgSetAdcDo))
            {
                BYTE id;
                char* state;

                if((compareTypeTagAtIndex(0, 'i') || compareTypeTagAtIndex(0, 'f')) && compareTypeTagAtIndex(1, 's'))
                {
                    id = getIntArgumentAtIndex(0);
                    if(id > AN_NUM - 1)
                    {
                        sendOSCMessage(sysPrefix, msgError, "ss", msgSetAdcDo, ": out_of_value_range");
                        return;
                    }
                    state = getStringArgumentAtIndex(1);
                    if(strcmp(state, "high") && strcmp(state, "low"))
                    {
                        sendOSCMessage(sysPrefix, msgError, "ss", msgSetAdcDo, ": wrong_argument_string");
                        return;
                    }
                }
                else
                {
                    sendOSCMessage(sysPrefix, msgError, "ss", msgSetAdcDo, ": wrong_argument_type");
                    return;
                }

                if(!strcmp(state, "high"))
                    outputAnPort(id, HIGH);
                else if(!strcmp(state, "low"))
                    outputAnPort(id, LOW);
            }
            else if(compareOSCAddress(msgGetAdcDi))
            {
                BYTE id;

                if((compareTypeTagAtIndex(0, 'i') || compareTypeTagAtIndex(0, 'f')))
                {
                    id = getIntArgumentAtIndex(0);
                    if(id > AN_NUM - 1)
                    {
                        sendOSCMessage(sysPrefix, msgError, "ss", msgGetAdcDi, ": out_of_value_range");
                        return;
                    }
                }
                else
                {
                    sendOSCMessage(sysPrefix, msgError, "ss", msgGetAdcDi, ": wrong_argument_type");
                    return;
                }

                BYTE state = inputAnPort(id);

                if(state)
                    sendOSCMessage(getOSCPrefix(), msgAdcDi, "is", id, "high");
                else
                    sendOSCMessage(getOSCPrefix(), msgAdcDi, "is", id, "low");
            }
            // PWM
            else if(compareOSCAddress(msgSetPwmEnable))
            {
                char* state;
                if((compareTypeTagAtIndex(0, 'i') || compareTypeTagAtIndex(0, 'f')) && compareTypeTagAtIndex(1, 's'))
                {
                    index = getIntArgumentAtIndex(0);
                    if(index > 3)
                    {
                        sendOSCMessage(sysPrefix, msgError, "ss", msgSetPwmEnable, ": out_of_value_range");
                        return;
                    }
                    state = getStringArgumentAtIndex(1);
                }
                else
                {
                    sendOSCMessage(sysPrefix, msgError, "ss", msgSetPwmEnable, ": wrong_argument_type");
                    return;
                }

                if(strcmp(state, "on") == 0)
                {
                    LONG w = (LONG)(((float)duty[index] / 100.0) * (float)width);
                    if(!onTimer2)
                    {
                        OpenTimer2(T2_ON | T2_SOURCE_INT | T2_PS_1_1, width);
                        onTimer2 = TRUE;
                    }
                    switch(index)
                    {
                        case 0:
                            OpenOC1(OC_ON | OC_TIMER_MODE16 | OC_TIMER2_SRC | OC_PWM_FAULT_PIN_DISABLE, width / 2, w);
                            break;
                        case 1:
                            OpenOC3(OC_ON | OC_TIMER_MODE16 | OC_TIMER2_SRC | OC_PWM_FAULT_PIN_DISABLE, width / 2, w);
                            break;
                        case 2:
                            OpenOC4(OC_ON | OC_TIMER_MODE16 | OC_TIMER2_SRC | OC_PWM_FAULT_PIN_DISABLE, width / 2, w);
                            break;
                        case 3:
                            OpenOC5(OC_ON | OC_TIMER_MODE16 | OC_TIMER2_SRC | OC_PWM_FAULT_PIN_DISABLE, width / 2, w);
                            break;
                    }
                    onSquare[index] = TRUE;
                }
                else if(strcmp(state, "off") == 0)
                {
                    onSquare[index] = FALSE;
                    if(onTimer2 && (!onSquare[0] && !onSquare[1] && !onSquare[2] && !onSquare[3]))
                    {
                        CloseTimer2();
                        onTimer2 = FALSE;
                    }
                    switch(index)
                    {
                        case 0:
                            CloseOC1();
                            break;
                        case 1:
                            CloseOC3();
                            break;
                        case 2:
                            CloseOC4();
                            break;
                        case 3:
                            CloseOC5();
                            break;
                    }
                }
                else
                    sendOSCMessage(sysPrefix, msgError, "ss", msgSetPwmEnable, ": wrong_argument_string");
            }
            else if(compareOSCAddress(msgGetPwmEnable))
            {
                if((compareTypeTagAtIndex(0, 'i') || compareTypeTagAtIndex(0, 'f')))
                {
                    index = getIntArgumentAtIndex(0);
                    if(index > PWM_NUM - 1)
                    {
                        sendOSCMessage(sysPrefix, msgError, "ss", msgGetPwmEnable, ": out_of_value_range");
                        return;
                    }
                }
                else
                {
                    sendOSCMessage(sysPrefix, msgError, "ss", msgGetPwmEnable, ": wrong_argument_type");
                    return;
                }

                sendOSCMessage(getOSCPrefix(), msgPwmEnable, "is", index, onSquare[index] ? "on" : "off");
            }
            else if(compareOSCAddress(msgSetPwmFreq))
            {
                WORD index;
                WORD period;//syama0

                if((compareTypeTagAtIndex(0, 'i') || compareTypeTagAtIndex(0, 'f')))
                    freq = getIntArgumentAtIndex(0);
                else
                {
                    sendOSCMessage(sysPrefix, msgError, "ss", msgGetPwmEnable, ": wrong_argument_type");
                    return;
                }

                if(freq < 20)
                {
                    freq = 20;
                }
                else if(freq > 20000)
                {
                    freq = 20000;
                }
                T2CONbits.TON = 0;
                TMR2 = 0;
                OC1CONbits.OCM = 0b000;
                OC3CONbits.OCM = 0b000;
                OC4CONbits.OCM = 0b000;
                OC5CONbits.OCM = 0b000;

                width = GetSystemClock() / freq;
                PR2 = width;
                OC1RS = width / 2;
                OC3RS = width / 2;
                OC4RS = width / 2;
                OC5RS = width / 2;

                OC1CONbits.OCM = 0b110;
                OC3CONbits.OCM = 0b110;
                OC4CONbits.OCM = 0b110;
                OC5CONbits.OCM = 0b110;
                T2CONbits.TON = 1;
            }
            else if(compareOSCAddress(msgGetPwmFreq))
            {
                sendOSCMessage(getOSCPrefix(), msgPwmFreq, "i", freq);
            }
            else if(compareOSCAddress(msgSetPwmDuty))
            {
                if((compareTypeTagAtIndex(0, 'i') || compareTypeTagAtIndex(0, 'f')) && (compareTypeTagAtIndex(1, 'i') || compareTypeTagAtIndex(1, 'f')))
                {
                    index = getIntArgumentAtIndex(0);
                    if(index > PWM_NUM - 1)
                    {
                        sendOSCMessage(sysPrefix, msgError, "ss", msgSetPwmDuty, ": out_of_value_range");
                        return;
                    }

                    duty[index] = getIntArgumentAtIndex(1);
                }
                else
                {
                    sendOSCMessage(sysPrefix, msgError, "ss", msgSetPwmDuty, ": wrong_argument_type");
                    return;
                }

                if(duty[index] < 0)
                {
                    duty[index] = 0;
                }
                else if(duty[index] > 100)
                {
                    duty[index] = 100;
                }
                T2CONbits.TON = 0;
                TMR2 = 0;
                switch(index)
                {
                    case 0:
                        OC1CONbits.OCM = 0b000;
                        OC1RS = (LONG)(((float)duty[index] / 100.0) * (float)width);
                        OC1CONbits.OCM = 0b110;
                        break;
                    case 1:
                        OC3CONbits.OCM = 0b000;
                        OC3RS = (LONG)(((float)duty[index] / 100.0) * (float)width);
                        OC3CONbits.OCM = 0b110;
                        break;
                    case 2:
                        OC4CONbits.OCM = 0b000;
                        OC4RS = (LONG)(((float)duty[index] / 100.0) * (float)width);
                        OC4CONbits.OCM = 0b110;
                        break;
                    case 3:
                        OC5CONbits.OCM = 0b000;
                        OC5RS = (LONG)(((float)duty[index] / 100.0) * (float)width);
                        OC5CONbits.OCM = 0b110;
                        break;
                }
                T2CONbits.TON = 1;
            }
            else if(compareOSCAddress(msgGetPwmDuty))
            {
                if((compareTypeTagAtIndex(0, 'i') || compareTypeTagAtIndex(0, 'f')))
                {
                    index = getIntArgumentAtIndex(0);
                    if(index > PWM_NUM - 1)
                    {
                        sendOSCMessage(sysPrefix, msgError, "ss", msgGetPwmDuty, ": out_of_value_range");
                        return;
                    }
                }
                else
                {
                    sendOSCMessage(sysPrefix, msgError, "ss", msgGetPwmDuty, ": wrong_argument_type");
                    return;
                }

                sendOSCMessage(getOSCPrefix(), msgPwmDuty, "ii", index, duty[index]);
            }
            else if(compareOSCAddress(msgSetPwmDio))
            {
                BYTE id;
                char* type;

                if((compareTypeTagAtIndex(0, 'i') || compareTypeTagAtIndex(0, 'f')) && compareTypeTagAtIndex(1, 's'))
                {
                    id = getIntArgumentAtIndex(0);
                    if(id > PWM_NUM - 1)
                    {
                        sendOSCMessage(sysPrefix, msgError, "ss", msgSetPwmDio, ": out_of_value_range");
                        return;
                    }
                    type = getStringArgumentAtIndex(1);
                }
                else
                {
                    sendOSCMessage(sysPrefix, msgError, "ss", msgSetPwmDio, ": wrong_argument_type");
                    return;
                }

                if(!strcmp(type, "in"))
                    setPwmPortDioType(id, IO_IN);
                else if(!strcmp(type, "out"))
                {
                    setPwmPortDioType(id, IO_OUT);
                    outputPwmPort(id, LOW);
                }
                else
                    sendOSCMessage(sysPrefix, msgError, "ss", msgSetPwmDio, ": wrong_argument_string");
            }
            else if(compareOSCAddress(msgGetPwmDio))
            {
                BYTE id;
                if((compareTypeTagAtIndex(0, 'i') || compareTypeTagAtIndex(0, 'f')))
                {
                    id = getIntArgumentAtIndex(0);
                    if(id > PWM_NUM - 1)
                    {
                        sendOSCMessage(sysPrefix, msgError, "ss", msgGetPwmDio, ": out_of_value_range");
                        return;
                    }
                }
                else
                {
                    sendOSCMessage(sysPrefix, msgError, "ss", msgGetPwmDio, ": wrong_argument_type");
                    return;
                }

                if(getPwmPortDioType(id))
                    sendOSCMessage(getOSCPrefix(), msgPwmDio, "is", id, "in");
                else
                    sendOSCMessage(getOSCPrefix(), msgPwmDio, "is", id, "out");
            }
            else if(compareOSCAddress(msgSetPwmDo))
            {
                BYTE id;
                char* state;

                if((compareTypeTagAtIndex(0, 'i') || compareTypeTagAtIndex(0, 'f')) && compareTypeTagAtIndex(1, 's'))
                {
                    id = getIntArgumentAtIndex(0);
                    if(id > PWM_NUM - 1)
                    {
                        sendOSCMessage(sysPrefix, msgError, "ss", msgSetPwmDo, ": out_of_value_range");
                        return;
                    }
                    state = getStringArgumentAtIndex(1);
                }
                else
                {
                    sendOSCMessage(sysPrefix, msgError, "ss", msgSetPwmDo, ": wrong_argument_type");
                    return;
                }

                if(!strcmp(state, "high"))
                    outputPwmPort(id, HIGH);
                else if(!strcmp(state, "low"))
                    outputPwmPort(id, LOW);
                else
                    sendOSCMessage(sysPrefix, msgError, "ss", msgSetPwmDo, ": wrong_argument_string");
            }
            else if(compareOSCAddress(msgGetPwmDi))
            {
                BYTE id;
                BYTE state;

                if((compareTypeTagAtIndex(0, 'i') || compareTypeTagAtIndex(0, 'f')))
                {
                    id = getIntArgumentAtIndex(0);
                    if(id > PWM_NUM - 1)
                    {
                        sendOSCMessage(sysPrefix, msgError, "ss", msgGetPwmDi, ": out_of_value_range");
                        return;
                    }

                    state = inputPwmPort(id);
                }
                else
                {
                    sendOSCMessage(sysPrefix, msgError, "ss", msgGetPwmDi, ": wrong_argument_type");
                    return;
                }

                if(state)
                    sendOSCMessage(getOSCPrefix(), msgPwmDi, "is", id, "high");
                else
                    sendOSCMessage(getOSCPrefix(), msgPwmDi, "is", id, "low");
            }
            // D/IO
            else if(compareOSCAddress(msgSetDigitalDio))
            {
                BYTE id;
                char* type;

                if((compareTypeTagAtIndex(0, 'i') || compareTypeTagAtIndex(0, 'f')) && compareTypeTagAtIndex(1, 's'))
                {
                    id = getIntArgumentAtIndex(0);
                    if(id > D_NUM - 1)
                    {
                        sendOSCMessage(sysPrefix, msgError, "ss", msgSetDigitalDio, ": out_of_value_range");
                        return;
                    }

                    type = getStringArgumentAtIndex(1);
                }
                else
                {
                    sendOSCMessage(sysPrefix, msgError, "ss", msgSetDigitalDio, ": wrong_argument_type");
                    return;
                }

                if(!strcmp(type, "in"))
                    setDigitalPortDioType(id, IO_IN);
                else if(!strcmp(type, "out"))
                {
                    setDigitalPortDioType(id, IO_OUT);
                    outputDigitalPort(id, LOW);
                }
                else
                    sendOSCMessage(sysPrefix, msgError, "ss", msgSetDigitalDio, ": wrong_argument_string");
            }
            else if(compareOSCAddress(msgGetDigitalDio))
            {
                BYTE id;
                if((compareTypeTagAtIndex(0, 'i') || compareTypeTagAtIndex(0, 'f')))
                {
                    id = getIntArgumentAtIndex(0);
                    if(id > D_NUM - 1)
                    {
                        sendOSCMessage(sysPrefix, msgError, "ss", msgGetDigitalDio, ": out_of_value_range");
                        return;
                    }
                }
                else
                {
                    sendOSCMessage(sysPrefix, msgError, "ss", msgGetDigitalDio, ": wrong_argument_type");
                    return;
                }

                if(getDigitalPortDioType(id))
                    sendOSCMessage(getOSCPrefix(), msgDigitalDio, "is", id, "in");
                else
                    sendOSCMessage(getOSCPrefix(), msgDigitalDio, "is", id, "out");
            }
            else if(compareOSCAddress(msgSetDigitalDo))
            {
                BYTE id;
                char* state;

                if((compareTypeTagAtIndex(0, 'i') || compareTypeTagAtIndex(0, 'f')) && compareTypeTagAtIndex(1, 's'))
                {
                    id = getIntArgumentAtIndex(0);
                    if(id > D_NUM - 1)
                        sendOSCMessage(sysPrefix, msgError, "ss", msgSetDigitalDo, ": out_of_value_range");

                    state = getStringArgumentAtIndex(1);
                }
                else
                {
                    sendOSCMessage(sysPrefix, msgError, "ss", msgSetDigitalDo, ": wrong_argument_type");
                    return;
                }

                if(!strcmp(state, "high"))
                    outputDigitalPort(id, HIGH);
                else if(!strcmp(state, "low"))
                    outputDigitalPort(id, LOW);
                else
                    sendOSCMessage(sysPrefix, msgError, "ss", msgSetDigitalDo, ": wrong_argument_string");
            }
            else if(compareOSCAddress(msgGetDigitalDi))
            {
                BYTE id;
                BYTE state;

                if((compareTypeTagAtIndex(0, 'i') || compareTypeTagAtIndex(0, 'f')))
                {
                    id = getIntArgumentAtIndex(0);
                    if(id >= D_NUM)
                    {
                        sendOSCMessage(sysPrefix, msgError, "ss", msgGetDigitalDi, ": out_of_value_range");
                        return;
                    }

                    state = inputDigitalPort(id);
                }
                else
                {
                    sendOSCMessage(sysPrefix, msgError, "ss", msgGetDigitalDi, ": wrong_argument_type");
                    return;
                }

                if(state)
                    sendOSCMessage(getOSCPrefix(), msgDigitalDi, "is", id, "high");
                else
                    sendOSCMessage(getOSCPrefix(), msgDigitalDi, "is", id, "low");
            }
            // SPI
            else if(compareOSCAddress(msgSetSpiConfig))
            {
                BYTE id;
                DWORD bitrate0 = 0;
                WORD bitrate = 0;
                DWORD spiFlags = 0;

                if((compareTypeTagAtIndex(0, 'i') || compareTypeTagAtIndex(0, 'f')) && (compareTypeTagAtIndex(1, 'i') || compareTypeTagAtIndex(1, 'f')))
                {
                    id = getIntArgumentAtIndex(0);
                    bitrate0 = getIntArgumentAtIndex(1);
                    if(bitrate0 >= 2 && bitrate0 <= 1024)
                    {
                        if((bitrate0 % 2) == 0)
                            bitrate = (WORD)bitrate0;
                        else
                        {
                            sendOSCMessage(sysPrefix, msgError, "ss", msgSetSpiConfig, ": 1:not_even_number");
                            return;
                        }
                    }
                    else
                    {
                        sendOSCMessage(sysPrefix, msgError, "ss", msgSetSpiConfig, ": 1:out_of_value_range");
                        return;
                    }

                    if(getArgumentsLength() < 3)
                    {
                        sendOSCMessage(sysPrefix, msgError, "ss", msgSetSpiConfig, ": need_3_arguments_at_leaset");
                        return;
                    }

                    for(i = 2; i < getArgumentsLength(); i++)
                    {
                        char* flag;
                        if(compareTypeTagAtIndex(i, 's'))
                            flag = getStringArgumentAtIndex(i);

                        if(!strcmp(flag, "msten"))
                            spiFlags |= SPICON_MSTEN;
                        else if(!strcmp(flag, "ckp"))
                            spiFlags |= SPICON_CKP;
                        else if(!strcmp(flag, "ssen"))
                            spiFlags |= SPICON_SSEN;
                        else if(!strcmp(flag, "cke"))
                            spiFlags |= SPICON_CKE;
                        else if(!strcmp(flag, "smp"))
                            spiFlags |= SPICON_SMP;
                        else if(!strcmp(flag, "mode16"))
                            spiFlags |= SPICON_MODE16;
                        else if(!strcmp(flag, "mode32"))
                            spiFlags |= SPICON_MODE32;
                        else if(!strcmp(flag, "dissdo"))
                            spiFlags |= SPICON_DISSDO;
                        else if(!strcmp(flag, "sidl"))
                            spiFlags |= SPICON_SIDL;
                        else if(!strcmp(flag, "frz"))
                            spiFlags |= SPICON_FRZ;
                        else if(!strcmp(flag, "on"))
                            spiFlags |= SPICON_ON;
                        else if(!strcmp(flag, "spife"))
                            spiFlags |= SPICON_SPIFE;
                        else if(!strcmp(flag, "frmpol"))
                            spiFlags |= SPICON_FRMPOL;
                        else if(!strcmp(flag, "frmsync"))
                            spiFlags |= SPICON_FRMSYNC;
                        else if(!strcmp(flag, "frmen"))
                            spiFlags |= SPICON_FRMEN;
                    }

                    switch(id)
                    {
                    case 2:
                        SpiChnClose(2);
                        SpiChnOpen(SPI_CHANNEL2, spiFlags, bitrate);
                        break;
                    case 4:
                        SpiChnClose(4);
                        SpiChnOpen(SPI_CHANNEL4, spiFlags, bitrate);
                        break;
                    default:
                        sendOSCMessage(sysPrefix, msgError, "ss", msgSetSpiConfig, ": 0:out_of_value_range");
                        return;
                    }
                }
                else
                    sendOSCMessage(sysPrefix, msgError, "ss", msgSetSpiConfig, ": wrong_argument_type");
            }
            else if(compareOSCAddress(msgDisableSpi))
            {
                BYTE id;

                if(compareTypeTagAtIndex(0, 'i') || compareTypeTagAtIndex(0, 'f'))
                {
                    id = getIntArgumentAtIndex(0);
                    switch(id)
                    {
                        case 2:
                            SpiChnClose(2);
                            break;
                        case 4:
                            SpiChnClose(4);
                            break;
                        default:
                            sendOSCMessage(sysPrefix, msgError, "ss", msgDisableSpi, ": out_of_range_value");
                            break;
                    }
                }
                else
                    sendOSCMessage(sysPrefix, msgError, "ss", msgDisableSpi, ": wrong_argument_type");
            }
            else if(compareOSCAddress(msgSetSpiData))
            {
                BYTE id = 0;
                char* load_port;
                char* active_state;
                BYTE byte_num = 0;
                WORD data[4] = {0};
                //DWORD usec = 0;

                if(getArgumentsLength() < 5)
                {
                    sendOSCMessage(sysPrefix, msgError, "ss", msgSetSpiData, "need_4_arguments_at_leaset");
                    return;
                }

                if((compareTypeTagAtIndex(0, 'i') || compareTypeTagAtIndex(0, 'f')) && compareTypeTagAtIndex(1, 's') && compareTypeTagAtIndex(2, 's') && (compareTypeTagAtIndex(3, 'i') || compareTypeTagAtIndex(3, 'f')))
                {
                    id = getIntArgumentAtIndex(0);
                    if(id != 2 && id != 4)
                    {
                        sendOSCMessage(sysPrefix, msgError, "ss", msgSetSpiData, ": 0:wrong_argument_value");
                        return;
                    }

                    load_port = getStringArgumentAtIndex(1);
                    if(!comparePortNameAtIndex(load_port))
                    {
                        sendOSCMessage(sysPrefix, msgError, "ss", msgSetSpiData, ": 1:wrong_argument_string");
                        return;
                    }

                    active_state = getStringArgumentAtIndex(2);
                    if(strcmp(active_state, "HL") && strcmp(active_state, "LH"))
                    {
                        sendOSCMessage(sysPrefix, msgError, "ss", msgSetSpiData, ": 2:wrong_argument_string");
                        return;
                    }

                    byte_num = getIntArgumentAtIndex(3);
                    if(byte_num != 1 && byte_num != 2 && byte_num != 4)
                    {
                        sendOSCMessage(sysPrefix, msgError, "ss", msgSetSpiData, ": 3:wrong_argument_value");
                        return;
                    }

                    if(getArgumentsLength() < byte_num + 4)
                    {
                        sendOSCMessage(sysPrefix, msgError, "ss", msgSetSpiData, ": too_few_arguments");
                        return;
                    }

                    for(i = 0; i < byte_num; i++)
                    {
                        if(!(compareTypeTagAtIndex(i + 4, 'i') || compareTypeTagAtIndex(i + 4, 'f')))
                        {
                            sendOSCMessage(sysPrefix, msgError, "ss", msgSetSpiData, ": 4:wrong_argument_type");
                            return;
                        }

                        data[i] = getIntArgumentAtIndex(i + 4);
                    }

                    if(getPortIOType(load_port) == IO_IN)
                        setPortIOType(load_port, IO_OUT);

                    if(!strcmp(active_state, "HL"))
                        outputPort(load_port, HIGH);
                    else if(!strcmp(active_state, "LH"))
                        outputPort(load_port, LOW);
                    switch(byte_num)
                    {
                    case 1:
                        sendSpiOneWord(id, data[0], 1);
                        break;
                    case 2:
                        sendSpiTwoWord(id, data[0], data[1], 1);
                        break;
                    case 4:
                        sendSpiFourWord(id, data[0], data[1], data[2], data[3], 1);
                        break;
                    }
                    if(!strcmp(active_state, "HL"))
                        outputPort(load_port, LOW);
                    else if(!strcmp(active_state, "LH"))
                        outputPort(load_port, HIGH);
                }
                else
                    sendOSCMessage(sysPrefix, msgError, "ss", msgSetSpiData, ": wrong_argument_type");
            }
            else if(compareOSCAddress(msgGetSpiData))
            {
                BYTE id = 0;
                char* load_port;
                char* active_state;
                BYTE byte_num = 0;
                WORD data[4] = {0};
                //DWORD usec = 0;

                if(getArgumentsLength() < 4)
                {
                    sendOSCMessage(sysPrefix, msgError, "ss", msgGetSpiData, "need_4_arguments_at_leaset");
                    return;
                }

                if((compareTypeTagAtIndex(0, 'i') || compareTypeTagAtIndex(0, 'f')) && compareTypeTagAtIndex(1, 's') && compareTypeTagAtIndex(2, 's') && (compareTypeTagAtIndex(3, 'i') || compareTypeTagAtIndex(3, 'f')))
                {
                    id = getIntArgumentAtIndex(0);
                    if(id != 2 && id != 4)
                    {
                        sendOSCMessage(sysPrefix, msgError, "ss", msgGetSpiData, ": 0:wrong_argument_value");
                        return;
                    }

                    load_port = getStringArgumentAtIndex(1);
                    if(!comparePortNameAtIndex(load_port))
                    {
                        sendOSCMessage(sysPrefix, msgError, "ss", msgGetSpiData, ": 1:wrong_argument_string");
                        return;
                    }

                    active_state = getStringArgumentAtIndex(2);
                    if(strcmp(active_state, "HL") && strcmp(active_state, "LH"))
                    {
                        sendOSCMessage(sysPrefix, msgError, "ss", msgGetSpiData, ": 2:wrong_argument_string");
                        return;
                    }

                    byte_num = getIntArgumentAtIndex(3);
                    if(byte_num != 1 && byte_num != 2 && byte_num != 4)
                    {
                        sendOSCMessage(sysPrefix, msgError, "ss", msgGetSpiData, ": 3:wrong_argument_value");
                        return;
                    }

                    if((compareTypeTagAtIndex(4, 'i') || compareTypeTagAtIndex(4, 'f')))
                    {
                        data[0] = getIntArgumentAtIndex(4);
                    }
                    else
                    {
                        sendOSCMessage(sysPrefix, msgError, "ss", msgGetSpiData, ": 4:wrong_argument_type");
                        return;
                    }

                    if(!strcmp(active_state, "HL"))
                        outputPort(load_port, HIGH);
                    else if(!strcmp(active_state, "LH"))
                        outputPort(load_port, LOW);
                    switch(byte_num)
                    {
                    case 1:
                        sendSpiOneWord(id, data[0], 1);
                        data[0] = receiveSpiOneWord(id, 1);
                        sendOSCMessage(getOSCPrefix(), msgSpiData, "ii", id, data[0]);
                        break;
                    case 2:
                        //data = receiveSpiTwoWord(id, 8);
                        break;
                    case 4:
                        //data = receiveSpiFourWord(id, 8);
                        break;
                    }
                    if(!strcmp(active_state, "HL"))
                        outputPort(load_port, LOW);
                    else if(!strcmp(active_state, "LH"))
                        outputPort(load_port, HIGH);
                }
                else
                    sendOSCMessage(sysPrefix, msgError, "ss", msgGetSpiData, ": wrong_argument_type");
            }
            else if(compareOSCAddress(msgSetSpiDio))
            {
                char* name;
                char* type;

                if(compareTypeTagAtIndex(0, 's') && compareTypeTagAtIndex(1, 's'))
                {
                    name = getStringArgumentAtIndex(0);
                    if(strcmp(name, "sck2") && strcmp(name, "sdi2") && strcmp(name, "sdo2") &&
                       strcmp(name, "sck4") && strcmp(name, "sdi4") && strcmp(name, "sdo4"))
                    {
                        sendOSCMessage(sysPrefix, msgError, "ss", msgSetSpiDio, ": wrong_argument_string");
                        return;
                    }
                    type = getStringArgumentAtIndex(1);
                }
                else
                {
                    sendOSCMessage(sysPrefix, msgError, "ss", msgSetSpiDio, ": wrong_argument_type");
                    return;
                }

                if(!strcmp(type, "in"))
                    setSpiPortDioType(name, IO_IN);
                else if(!strcmp(type, "out"))
                {
                    setSpiPortDioType(name, IO_OUT);
                    outputSpiPort(name, LOW);
                }
                else
                    sendOSCMessage(sysPrefix, msgError, "ss", msgSetSpiDio, ": wrong_argument_string");
            }
            else if(compareOSCAddress(msgGetSpiDio))
            {
                char* name;

                if(compareTypeTagAtIndex(0, 's'))
                {
                    name = getStringArgumentAtIndex(0);
                    if(strcmp(name, "sck2") && strcmp(name, "sdi2") && strcmp(name, "sdo2") &&
                       strcmp(name, "sck4") && strcmp(name, "sdi4") && strcmp(name, "sdo4"))
                    {
                        sendOSCMessage(sysPrefix, msgError, "ss", msgGetSpiDio, ": wrong_argument_string");
                        return;
                    }
                }
                else
                {
                    sendOSCMessage(sysPrefix, msgError, "ss", msgGetSpiDio, ": wrong_argument_type");
                    return;
                }

                if(getSpiPortDioType(name))
                    sendOSCMessage(getOSCPrefix(), msgSpiDio, "ss", name, "in");
                else
                    sendOSCMessage(getOSCPrefix(), msgSpiDio, "ss", name, "out");
            }
            else if(compareOSCAddress(msgSetSpiDo))
            {
                char* name;
                char* state;

                if(compareTypeTagAtIndex(0, 's') && compareTypeTagAtIndex(1, 's'))
                {
                    name = getStringArgumentAtIndex(0);
                    if(strcmp(name, "sck4") && strcmp(name, "sdi4") && strcmp(name, "sdo4") &&
                       strcmp(name, "sck2") && strcmp(name, "sdi2") && strcmp(name, "sdo2"))
                    {
                        sendOSCMessage(sysPrefix, msgError, "ss", msgSetSpiDo, ": wrong_argument_string");
                        return;
                    }

                    state = getStringArgumentAtIndex(1);
                }
                else
                {
                    sendOSCMessage(sysPrefix, msgError, "ss", msgSetSpiDo, ": wrong_argument_type");
                    return;
                }

                if(!strcmp(state, "high"))
                    outputSpiPort(name, HIGH);
                else if(!strcmp(state, "low"))
                    outputSpiPort(name, LOW);
                else
                    sendOSCMessage(sysPrefix, msgError, "ss", msgSetSpiDo, ": wrong_argument_string");
            }
            else if(compareOSCAddress(msgGetSpiDi))
            {
                char* name;
                BYTE state;

                if(compareTypeTagAtIndex(0, 's'))
                {
                    name = getStringArgumentAtIndex(0);
                    if(strcmp(name, "sck4") && strcmp(name, "sdi4") && strcmp(name, "sdo4") &&
                       strcmp(name, "sck2") && strcmp(name, "sdi2") && strcmp(name, "sdo2"))
                    {
                        sendOSCMessage(sysPrefix, msgError, "ss", msgGetSpiDi, ": wrong_argument_string");
                        return;
                    }

                    state = inputSpiPort(name);
                }
                else
                {
                    sendOSCMessage(sysPrefix, msgError, "ss", msgGetSpiDi, ": wrong_argument_type");
                    return;
                }

                if(state)
                    sendOSCMessage(getOSCPrefix(), msgSpiDi, "ss", name, "high");
                else
                    sendOSCMessage(getOSCPrefix(), msgSpiDi, "ss", name, "low");
            }
            // I2C
            else if(compareOSCAddress(msgEnableI2c))
            {
                BYTE id;
                char* cFlag = NULL;
                BOOL flag = FALSE;

                if(compareTypeTagAtIndex(0, 'i') || compareTypeTagAtIndex(0, 'f') && compareTypeTagAtIndex(1, 's'))
                {
                    id = getIntArgumentAtIndex(0);
                    cFlag = getStringArgumentAtIndex(1);
                    if(!strcmp(cFlag, "true"))
                        flag = TRUE;
                    else if(!strcmp(cFlag, "false"))
                        flag = FALSE;
                    else
                    {
                        sendOSCMessage(sysPrefix, msgError, "ss", msgEnableI2c, ": wrong_argument_string");
                        return;
                    }

                    switch(id)
                    {
                        case 3:
                            setPortIOType("b2", IO_IN);
                            setPortIOType("b3", IO_IN);
                            I2CEnable(I2C3, flag);
                            break;
                        case 4:
                            setPortIOType("g7", IO_IN);
                            setPortIOType("g8", IO_IN);
                            I2CEnable(I2C4, flag);
                            break;
                        case 5:
                            setPortIOType("f4", IO_IN);
                            setPortIOType("f5", IO_IN);
                            I2CEnable(I2C5, flag);
                            break;
                        default:
                            sendOSCMessage(sysPrefix, msgError, "ss", msgEnableI2c, ": out_of_range_value");
                            break;
                    }
                }
                else
                    sendOSCMessage(sysPrefix, msgError, "ss", msgEnableI2c, ": wrong_argument_type");
            }
            else if(compareOSCAddress(msgSetI2cConfig))
            {
                BYTE id;
                DWORD i2cFlags = 0;

                if((compareTypeTagAtIndex(0, 'i') || compareTypeTagAtIndex(0, 'f')))
                {
                    id = getIntArgumentAtIndex(0);

                    if(getArgumentsLength() < 1)
                    {
                        sendOSCMessage(sysPrefix, msgError, "ss", msgSetI2cConfig, ": need_1_arguments_at_leaset");
                        return;
                    }

                    for(i = 1; i < getArgumentsLength(); i++)
                    {
                        char* flag;
                        if(compareTypeTagAtIndex(i, 's'))
                            flag = getStringArgumentAtIndex(i);
                        else
                        {
                            sendOSCMessage(sysPrefix, msgError, "ss", msgSetI2cConfig, ": wrong_argument_type");
                            return;
                        }

                        if(!strcmp(flag, "enable_slave_clock_stretching"))
                            i2cFlags |= I2C_ENABLE_SLAVE_CLOCK_STRETCHING;
                        else if(!strcmp(flag, "enable_smb_support"))
                            i2cFlags |= I2C_ENABLE_SMB_SUPPORT;
                        else if(!strcmp(flag, "enable_high_speed"))
                            i2cFlags |= I2C_ENABLE_HIGH_SPEED;
                        else if(!strcmp(flag, "stop_in_idle"))
                            i2cFlags |= I2C_STOP_IN_IDLE;
                    }

                    switch(id)
                    {
                        case 3:
                            I2CConfigure(I2C3, i2cFlags);
                            break;
                        case 4:
                            I2CConfigure(I2C4, i2cFlags);
                            break;
                        case 5:
                            I2CConfigure(I2C5, i2cFlags);
                            break;
                        default:
                            sendOSCMessage(sysPrefix, msgError, "ss", msgSetI2cConfig, ": 0:out_of_value_range");
                            return;
                    }
                }
                else
                    sendOSCMessage(sysPrefix, msgError, "ss", msgSetI2cConfig, ": wrong_argument_type");
            }
            else if(compareOSCAddress(msgSetI2cFreq))
            {
                BYTE id;
                DWORD i2cFreq = 0;
                DWORD actualFreq = 0;

                if((compareTypeTagAtIndex(0, 'i') || compareTypeTagAtIndex(0, 'f')) && (compareTypeTagAtIndex(1, 'i') || compareTypeTagAtIndex(1, 'f')))
                {
                    id = getIntArgumentAtIndex(0);
                    i2cFreq = getIntArgumentAtIndex(1);

                    if(getArgumentsLength() < 2)
                    {
                        sendOSCMessage(sysPrefix, msgError, "ss", msgSetI2cConfig, ": need_2_arguments_at_leaset");
                        return;
                    }

                    switch(id)
                    {
                        case 3:
                            actualFreq = I2CSetFrequency(I2C3, GetPeripheralClock(), i2cFreq);
                            break;
                        case 4:
                            actualFreq = I2CSetFrequency(I2C4, GetPeripheralClock(), i2cFreq);
                            break;
                        case 5:
                            actualFreq = I2CSetFrequency(I2C5, GetPeripheralClock(), i2cFreq);
                            break;
                        default:
                            sendOSCMessage(sysPrefix, msgError, "ss", msgSetI2cConfig, ": 0:out_of_value_range");
                            return;
                    }
                    if((actualFreq - i2cFreq) > i2cFreq / 10)
                    {
                        sendOSCMessage(sysPrefix, msgError, "ss", msgSetI2cConfig, ": bad_frequency");
                        return;
                    }
                }
                else
                    sendOSCMessage(sysPrefix, msgError, "ss", msgSetI2cConfig, ": wrong_argument_type");
            }
            else if(compareOSCAddress(msgSetI2cSlaveAddress))
            {
                BYTE id;
                WORD address;
                WORD mask;
                DWORD slvAdrsFlags = 0;

                if((compareTypeTagAtIndex(0, 'i') || compareTypeTagAtIndex(0, 'f')) && (compareTypeTagAtIndex(1, 'i') || compareTypeTagAtIndex(1, 'f')) && (compareTypeTagAtIndex(2, 'i') || compareTypeTagAtIndex(2, 'f')))
                {
                    id = getIntArgumentAtIndex(0);
                    address = getIntArgumentAtIndex(1);
                    mask = getIntArgumentAtIndex(2);

                    if(getArgumentsLength() < 4)
                    {
                        sendOSCMessage(sysPrefix, msgError, "ss", msgSetI2cSlaveAddress, ": need_4_arguments_at_leaset");
                        return;
                    }

                    for(i = 3; i < getArgumentsLength(); i++)
                    {
                        char* flag;
                        if(compareTypeTagAtIndex(i, 's'))
                            flag = getStringArgumentAtIndex(i);
                        else
                        {
                            sendOSCMessage(sysPrefix, msgError, "ss", msgSetI2cSlaveAddress, ": wrong_argument_type");
                            return;
                        }

                        if(!strcmp(flag, "use_7bit_address"))
                            slvAdrsFlags |= I2C_USE_7BIT_ADDRESS;
                        else if(!strcmp(flag, "use_10bit_address"))
                            slvAdrsFlags |= I2C_USE_10BIT_ADDRESS;
                        else if(!strcmp(flag, "enable_general_call_address"))
                            slvAdrsFlags |= I2C_ENABLE_GENERAL_CALL_ADDRESS;
                        else if(!strcmp(flag, "use_reserved_addresses"))
                            slvAdrsFlags |= I2C_USE_RESERVED_ADDRESSES;
                    }

                    switch(id)
                    {
                        case 3:
                            I2CSetSlaveAddress(I2C3, address, mask, slvAdrsFlags);
                            break;
                        case 4:
                            I2CSetSlaveAddress(I2C4, address, mask, slvAdrsFlags);
                            break;
                        case 5:
                            I2CSetSlaveAddress(I2C5, address, mask, slvAdrsFlags);
                            break;
                        default:
                            sendOSCMessage(sysPrefix, msgError, "ss", msgSetI2cSlaveAddress, ": 0:out_of_value_range");
                            return;
                    }
                }
                else
                    sendOSCMessage(sysPrefix, msgError, "ss", msgSetI2cSlaveAddress, ": wrong_argument_type");
            }
            else if(compareOSCAddress(msgSetI2cData))
            {
                BYTE id;
                BYTE slave_address;
                BYTE chip_address;
                WORD address = 0;
                DWORD data = 0;

                if((compareTypeTagAtIndex(0, 'i') || compareTypeTagAtIndex(0, 'f')) && (compareTypeTagAtIndex(1, 'i') || compareTypeTagAtIndex(1, 'f')) &&
                   (compareTypeTagAtIndex(2, 'i') || compareTypeTagAtIndex(2, 'f')) && (compareTypeTagAtIndex(3, 'i') || compareTypeTagAtIndex(3, 'f')) &&
                   (compareTypeTagAtIndex(4, 'i') || compareTypeTagAtIndex(4, 'f')))
                {
                    id = getIntArgumentAtIndex(0);
                    slave_address = getIntArgumentAtIndex(1);
                    chip_address = getIntArgumentAtIndex(2);
                    address = getIntArgumentAtIndex(3);
                    data = getIntArgumentAtIndex(4);

                    switch(id)
                    {
                        case 3:
                            if(!startI2C(I2C_3))
                                sendOSCMessage(sysPrefix, msgError, "s", "I2C Error 0:");
                            idleI2C(I2C_3);

                            setAddressToI2C(I2C_3, slave_address | (chip_address << 1), 'w');
                            idleI2C(I2C_3);

                            if(!checkAckI2C(I2C_3))
                                sendOSCMessage(sysPrefix, msgError, "s", "I2C Error 1:");

                            idleI2C(I2C_3);
                            setDataToI2C(I2C_3, address >> 8);
                            idleI2C(I2C_3);

                            if(!checkAckI2C(I2C_3))
                                sendOSCMessage(sysPrefix, msgError, "s", "I2C Error 2:");

                            idleI2C(I2C_3);
                            setDataToI2C(I2C_3, address & 0x00FF);
                            idleI2C(I2C_3);

                            if(!checkAckI2C(I2C_3))
                                sendOSCMessage(sysPrefix, msgError, "s", "I2C Error 3:");

                            idleI2C(I2C_3);
                            setDataToI2C(I2C_3, data);
                            idleI2C(I2C_3);

                            if(!checkAckI2C(I2C_3))
                                sendOSCMessage(sysPrefix, msgError, "s", "I2C Error 4:");

                            stopI2C(I2C_3);
                            idleI2C(I2C_3);
                            DelayMs(5);
                            break;
                        case 4:
                            if(!startI2C(I2C_4))
                                sendOSCMessage(sysPrefix, msgError, "s", "I2C Error 0:");
                            idleI2C(I2C_4);

                            setAddressToI2C(I2C_4, slave_address | (chip_address << 1), 'w');
                            idleI2C(I2C_4);

                            if(!checkAckI2C(I2C_4))
                                sendOSCMessage(sysPrefix, msgError, "s", "I2C Error 1:");

                            idleI2C(I2C_4);
                            setDataToI2C(I2C_4, address >> 8);
                            idleI2C(I2C_4);

                            if(!checkAckI2C(I2C_4))
                                sendOSCMessage(sysPrefix, msgError, "s", "I2C Error 2:");

                            idleI2C(I2C_4);
                            setDataToI2C(I2C_4, address & 0x00FF);
                            idleI2C(I2C_4);

                            if(!checkAckI2C(I2C_4))
                                sendOSCMessage(sysPrefix, msgError, "s", "I2C Error 3:");

                            idleI2C(I2C_4);
                            setDataToI2C(I2C_4, data);
                            idleI2C(I2C_4);

                            if(!checkAckI2C(I2C_4))
                                sendOSCMessage(sysPrefix, msgError, "s", "I2C Error 4:");

                            stopI2C(I2C_4);
                            idleI2C(I2C_4);
                            DelayMs(5);
                            break;
                        case 5:
                            if(!startI2C(I2C_5))
                                sendOSCMessage(sysPrefix, msgError, "s", "I2C Error 0:");
                            idleI2C(I2C_5);

                            setAddressToI2C(I2C_5, slave_address | (chip_address << 1), 'w');
                            idleI2C(I2C_5);

                            if(!checkAckI2C(I2C_5))
                                sendOSCMessage(sysPrefix, msgError, "s", "I2C Error 1:");

                            idleI2C(I2C_5);
                            setDataToI2C(I2C_5, address >> 8);
                            idleI2C(I2C_5);

                            if(!checkAckI2C(I2C_5))
                                sendOSCMessage(sysPrefix, msgError, "s", "I2C Error 2:");

                            idleI2C(I2C_5);
                            setDataToI2C(I2C_5, address & 0x00FF);
                            idleI2C(I2C_5);

                            if(!checkAckI2C(I2C_5))
                                sendOSCMessage(sysPrefix, msgError, "s", "I2C Error 3:");

                            idleI2C(I2C_5);
                            setDataToI2C(I2C_5, data);
                            idleI2C(I2C_5);

                            if(!checkAckI2C(I2C_5))
                                sendOSCMessage(sysPrefix, msgError, "s", "I2C Error 4:");

                            stopI2C(I2C_5);
                            idleI2C(I2C_5);
                            DelayMs(5);
                            break;
                    }
                }
                else
                    sendOSCMessage(sysPrefix, msgError, "ss", msgSetI2cData, ": wrong_argument_type");
            }
            else if(compareOSCAddress(msgGetI2cData))
            {
                BYTE id;
                BYTE slave_address = 0;
                BYTE chip_address = 0;
                WORD address = 0;
                BYTE data;

                if((compareTypeTagAtIndex(0, 'i') || compareTypeTagAtIndex(0, 'f')) && (compareTypeTagAtIndex(1, 'i') || compareTypeTagAtIndex(1, 'f')) && (compareTypeTagAtIndex(2, 'i') || compareTypeTagAtIndex(2, 'f')) && (compareTypeTagAtIndex(3, 'i') || compareTypeTagAtIndex(3, 'f')))
                {
                    id = getIntArgumentAtIndex(0);
                    slave_address = getIntArgumentAtIndex(1);
                    chip_address = getIntArgumentAtIndex(2);
                    address = getIntArgumentAtIndex(3);

                    switch(id)
                    {
                        case 3:
                            if(!startI2C(I2C_3))
                                sendOSCMessage(sysPrefix, msgError, "s", "I2C Error 0:");
                            idleI2C(I2C_3);

                            setAddressToI2C(I2C_3, slave_address | (chip_address << 1), 'w');
                            idleI2C(I2C_3);

                            if(!checkAckI2C(I2C_3))
                                sendOSCMessage(sysPrefix, msgError, "s", "I2C Error 1:");

                            idleI2C(I2C_3);
                            setDataToI2C(I2C_3, address >> 8);
                            idleI2C(I2C_3);

                            if(!checkAckI2C(I2C_3))
                                sendOSCMessage(sysPrefix, msgError, "s", "I2C Error 2:");

                            idleI2C(I2C_3);
                            setDataToI2C(I2C_3, address & 0x00FF);
                            idleI2C(I2C_3);

                            if(!checkAckI2C(I2C_3))
                                sendOSCMessage(sysPrefix, msgError, "s", "I2C Error 3:");

                            restartI2C(I2C_3);

                            setAddressToI2C(I2C_3, slave_address | (chip_address << 1), 'r');
                            idleI2C(I2C_3);

                            if(!checkAckI2C(I2C_3))
                                sendOSCMessage(sysPrefix, msgError, "s", "I2C Error 4:");

                            data = getDataFromI2C(I2C_3);

                            //I2C3CONbits.ACKDT = 1;
                            //I2C3CONbits.ACKEN = 1;
                            //while(I2C3CONbits.ACKEN == 1);

                            stopI2C(I2C_3);
                            idleI2C(I2C_3);

                            sendOSCMessage(getOSCPrefix(), msgI2cData, "iii", id, address, data);
                            break;
                        case 4:
                            if(!startI2C(I2C_4))
                                sendOSCMessage(sysPrefix, msgError, "s", "I2C Error 0:");
                            idleI2C(I2C_4);

                            setAddressToI2C(I2C_4, slave_address | (chip_address << 1), 'w');
                            idleI2C(I2C_4);

                            if(!checkAckI2C(I2C_4))
                                sendOSCMessage(sysPrefix, msgError, "s", "I2C Error 1:");

                            idleI2C(I2C_4);
                            setDataToI2C(I2C_4, address >> 8);
                            idleI2C(I2C_4);

                            if(!checkAckI2C(I2C_4))
                                sendOSCMessage(sysPrefix, msgError, "s", "I2C Error 2:");

                            idleI2C(I2C_4);
                            setDataToI2C(I2C_4, address & 0x00FF);
                            idleI2C(I2C_4);

                            if(!checkAckI2C(I2C_4))
                                sendOSCMessage(sysPrefix, msgError, "s", "I2C Error 3:");

                            restartI2C(I2C_4);

                            setAddressToI2C(I2C_4, slave_address | (chip_address << 1), 'r');
                            idleI2C(I2C_4);

                            if(!checkAckI2C(I2C_4))
                                sendOSCMessage(sysPrefix, msgError, "s", "I2C Error 4:");

                            data = getDataFromI2C(I2C_4);

                            //I2C4CONbits.ACKDT = 1;
                            //I2C4CONbits.ACKEN = 1;
                            //while(I2C4CONbits.ACKEN == 1);
                            
                            stopI2C(I2C_4);
                            idleI2C(I2C_4);

                            sendOSCMessage(getOSCPrefix(), msgI2cData, "iii", id, address, data);
                            break;
                        case 5:
                            if(!startI2C(I2C_5))
                                sendOSCMessage(sysPrefix, msgError, "s", "I2C Error 0:");
                            idleI2C(I2C_5);

                            setAddressToI2C(I2C_5, slave_address | (chip_address << 1), 'w');
                            idleI2C(I2C_5);

                            if(!checkAckI2C(I2C_5))
                                sendOSCMessage(sysPrefix, msgError, "s", "I2C Error 1:");

                            idleI2C(I2C_5);
                            setDataToI2C(I2C_5, address >> 8);
                            idleI2C(I2C_5);

                            if(!checkAckI2C(I2C_5))
                                sendOSCMessage(sysPrefix, msgError, "s", "I2C Error 2:");

                            idleI2C(I2C_5);
                            setDataToI2C(I2C_5, address & 0x00FF);
                            idleI2C(I2C_5);

                            if(!checkAckI2C(I2C_5))
                                sendOSCMessage(sysPrefix, msgError, "s", "I2C Error 3:");

                            restartI2C(I2C_5);

                            setAddressToI2C(I2C_5, slave_address | (chip_address << 1), 'r');
                            idleI2C(I2C_5);

                            if(!checkAckI2C(I2C_5))
                                sendOSCMessage(sysPrefix, msgError, "s", "I2C Error 4:");

                            data = getDataFromI2C(I2C_5);

                            //I2C5CONbits.ACKDT = 1;
                            //I2C5CONbits.ACKEN = 1;
                            //while(I2C5CONbits.ACKEN == 1);

                            stopI2C(I2C_5);
                            idleI2C(I2C_5);

                            sendOSCMessage(getOSCPrefix(), msgI2cData, "iii", id, address, data);
                            break;
                    }
                }
                else
                    sendOSCMessage(sysPrefix, msgError, "ss", msgGetI2cData, ": wrong_argument_type");
            }
#if defined(USE_PITCH)
            else if(compareOSCAddress("/volume/led/len/set"))
            {
                BYTE val = getIntArgumentAtIndex(0);
                //if(type == 1)
                {
                    switch(val)
                    {
                    case 0:
                        outputPort("b2", LOW);
                        outputPort("b3", LOW);
                        outputPort("b4", LOW);
                        outputPort("b5", LOW);
                        outputPort("b6", LOW);
                        outputPort("b7", LOW);
                        outputPort("b8", LOW);
                        outputPort("b9", LOW);
                        outputPort("b10", LOW);
                        outputPort("b11", LOW);
                        outputPort("b12", LOW);
                        break;
                    case 1:
                        outputPort("b2", HIGH);
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
                    outputPort("f1", (state > 0)?1:0);
                else if(x == 0 && y == 1)
                    outputPort("g8", (state > 0)?1:0);
                else if(x == 1 && y == 1)
                    outputPort("f4", (state > 0)?1:0);
            }
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
