yamamo2shun1/PICrouter/PICrouter_795_mrb.X/picrouter.c

/*
 * Copylight (C) 2013, Shunichi Yamamoto, tkrworks.net
 *
 * This file is part of PICrouter.
 *
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
 * picrouter.c,v.0.2.5 2014/08/05
 */

#include "picrouter.h"

extern const BYTE bytecode[];

//#define CHECK_MRB_MEM_SIZE
#ifdef CHECK_MRB_MEM_SIZE
void* heap_bottom;
size_t total_size = 0;
size_t max_usage_size = 0;
void* max_reached = 0;
int malloc_count = 0;

void* myallocf(struct mrb_state* mrb, void* p, size_t size, void* ud)
{
    if(size == 0)
    {
        free(p);
        return NULL;
    }
    else
    {
        malloc_count++;
        total_size += size;
        void* ret = realloc(p, size);

        if(ret > max_reached)
        {
            max_reached = ret;
        }
        return ret;
    }
}
#endif

static BYTE sendOSCTaskIndex = 0;
static BYTE swState0 = 0;
static BYTE swState1 = 0;

void _general_exception_handler(unsigned cause, unsigned status)
{
    Nop();
    Nop();
}

int main(int argc, char** argv) {
    BYTE i;

    // Enable optimal performance
    SYSTEMConfigPerformance(GetSystemClock());
    mOSCSetPBDIV(OSC_PB_DIV_1); // Use 1:1 CPU Core:Peripheral clocks

    // Enable the cache for the best performance
    CheKseg0CacheOn();

    DelayMs(100);
    mJTAGPortEnable(DEBUG_JTAGPORT_OFF);

#ifdef USE_SPI_SRAM
    initSPI2ForSRAM();
#endif

    initAnalogVariables();
#if defined(USE_LED_ENC)
    initEncoderVariables();
#endif

    // Onboard Switches and LEDs Initialization
    initSW();
    initLEDs();

#if defined(USE_LED_PAD)
    buttonInit();
#endif

    // PWM Initialization
    freq = 10000; // 10kHz
    width = GetSystemClock() / freq;
    for(i = 0; i < PWM_NUM; i++)
        duty[i] = 50;

    // USB I/O Setting
    #if defined(USE_USB_BUS_SENSE_IO)
        tris_usb_bus_sense = 1;
    #endif

    #if defined(USE_SELF_POWER_SENSE_IO)
        tris_self_power = 1;
    #endif

    #ifdef CHECK_MRB_MEM_SIZE
        heap_bottom = realloc(NULL, 1);

        mrb = mrb_open_allocf(myallocf, NULL);
        mrb_close(mrb);
        max_usage_size = (unsigned long)max_reached - (unsigned long)heap_bottom;
        
        turnOnLED1();
    #else
        mrb = mrb_open();
        mrb_init_define_methods();
        mrb_load_irep(mrb, bytecode);

#if 0
        mrb_funcall(mrb, mrb_top_self(mrb), "send_osc_task", 0);
        DelayMs(500);

        mrb_funcall(mrb, mrb_top_self(mrb), "send_osc_task", 0);
        DelayMs(500);
        
        mrb_funcall(mrb, mrb_top_self(mrb), "send_osc_task", 0);
        DelayMs(500);
        
        mrb_funcall(mrb, mrb_top_self(mrb), "send_osc_task", 0);
        DelayMs(500);
#endif

        mrb_close(mrb);
    #endif

    return (EXIT_SUCCESS);
}

void mrb_init_define_methods(void)
{
    int ai = mrb_gc_arena_save(mrb);

    // Basic
    mrb_define_method(mrb, mrb->object_class, "delay_10us", mrb_delay_10us, ARGS_REQ(1));
    mrb_define_method(mrb, mrb->object_class, "delay_1ms", mrb_delay_1ms, ARGS_REQ(1));
    mrb_define_method(mrb, mrb->object_class, "config_timer5", mrb_config_timer5, ARGS_REQ(1));

    // I/O Port
    mrb_define_method(mrb, mrb->object_class, "onboard_led", mrb_onboard_led, ARGS_REQ(2));
    mrb_define_method(mrb, mrb->object_class, "init_io_ports", mrb_init_io_ports, ARGS_NONE());
    mrb_define_method(mrb, mrb->object_class, "set_port_io_type", mrb_set_port_io_type, ARGS_REQ(2));
    mrb_define_method(mrb, mrb->object_class, "get_port_io_type", mrb_get_port_io_type, ARGS_REQ(1));
    mrb_define_method(mrb, mrb->object_class, "output_port", mrb_output_port, ARGS_REQ(2));
    mrb_define_method(mrb, mrb->object_class, "input_port", mrb_input_port, ARGS_REQ(1));

    // OSC
    mrb_define_method(mrb, mrb->object_class, "init_osc_config", mrb_init_osc_config, ARGS_REQ(4));
    mrb_define_method(mrb, mrb->object_class, "network_tasks", mrb_network_tasks, ARGS_REQ(1));
    mrb_define_method(mrb, mrb->object_class, "receive_osc_task", mrb_receive_osc_task, ARGS_NONE());
    mrb_define_method(mrb, mrb->object_class, "process_standard_messages", mrb_process_standard_messages, ARGS_NONE());
    mrb_define_method(mrb, mrb->object_class, "process_midi_messages", mrb_process_midi_messages, ARGS_NONE());
    mrb_define_method(mrb, mrb->object_class, "process_cdc_messages", mrb_process_cdc_messages, ARGS_NONE());
    mrb_define_method(mrb, mrb->object_class, "process_system_messages", mrb_process_system_messages, ARGS_NONE());
    mrb_define_method(mrb, mrb->object_class, "send_osc_task", mrb_send_osc_task, ARGS_NONE());
    mrb_define_method(mrb, mrb->object_class, "set_osc_address", mrb_set_osc_address, ARGS_REQ(2));
    mrb_define_method(mrb, mrb->object_class, "set_osc_typetag", mrb_set_osc_typetag, ARGS_REQ(1));
    mrb_define_method(mrb, mrb->object_class, "add_osc_int_arg", mrb_add_osc_int_arg, ARGS_REQ(1));
    mrb_define_method(mrb, mrb->object_class, "add_osc_float_arg", mrb_add_osc_float_arg, ARGS_REQ(1));
    mrb_define_method(mrb, mrb->object_class, "add_osc_string_arg", mrb_add_osc_string_arg, ARGS_REQ(1));
    mrb_define_method(mrb, mrb->object_class, "clear_osc_message", mrb_clear_osc_message, ARGS_NONE());
    mrb_define_method(mrb, mrb->object_class, "flush_osc_message", mrb_flush_osc_message, ARGS_NONE());
    mrb_define_method(mrb, mrb->object_class, "get_osc_packet", mrb_get_osc_packet, ARGS_NONE());
    mrb_define_method(mrb, mrb->object_class, "process_osc_packet", mrb_process_osc_packet, ARGS_NONE());
    mrb_define_method(mrb, mrb->object_class, "compare_osc_prefix", mrb_compare_osc_prefix, ARGS_REQ(1));
    mrb_define_method(mrb, mrb->object_class, "compare_osc_address", mrb_compare_osc_address, ARGS_REQ(1));
    mrb_define_method(mrb, mrb->object_class, "compare_typetag_at_index", mrb_compare_typetag_at_index, ARGS_REQ(2));
    mrb_define_method(mrb, mrb->object_class, "get_int_arg_at_index", mrb_get_int_arg_at_index, ARGS_REQ(1));
    mrb_define_method(mrb, mrb->object_class, "get_float_arg_at_index", mrb_get_float_arg_at_index, ARGS_REQ(1));
    mrb_define_method(mrb, mrb->object_class, "get_string_arg_at_index", mrb_get_string_arg_at_index, ARGS_REQ(1));

    // USB Device
    mrb_define_method(mrb, mrb->object_class, "usb_device_init", mrb_usb_device_init, ARGS_NONE());
    mrb_define_method(mrb, mrb->object_class, "usb_device_tasks", mrb_usb_device_tasks, ARGS_NONE());

    // USB Device HID
    mrb_define_method(mrb, mrb->object_class, "hid_ctrl_task", mrb_hid_ctrl_task, ARGS_NONE());

    // USB Device MIDI
    mrb_define_method(mrb, mrb->object_class, "send_note", mrb_send_note, ARGS_REQ(3));
    mrb_define_method(mrb, mrb->object_class, "send_cc", mrb_send_cc, ARGS_REQ(3));
    mrb_define_method(mrb, mrb->object_class, "receive_midi_datas", mrb_receive_midi_datas, ARGS_NONE());

    // USB Host
    mrb_define_method(mrb, mrb->object_class, "usb_host_init", mrb_usb_host_init, ARGS_NONE());
    mrb_define_method(mrb, mrb->object_class, "usb_host_tasks", mrb_usb_host_tasks, ARGS_NONE());

    // USB Host MIDI
    mrb_define_method(mrb, mrb->object_class, "convert_midi_to_osc", mrb_convert_midi_to_osc, ARGS_NONE());

    // USB Host CDC
#if defined(USB_USE_CDC)
    mrb_define_method(mrb, mrb->object_class, "usb_cdc_rxtx_handler", mrb_usb_cdc_rxtx_handler, ARGS_NONE());
#endif

    mrb_gc_arena_restore(mrb, ai);
}

mrb_value mrb_delay_10us(mrb_state* mrb, mrb_value self)
{
    mrb_int t;
    mrb_get_args(mrb, "i", &t);

    Delay10us((WORD)t);

    return mrb_nil_value();
}

mrb_value mrb_delay_1ms(mrb_state* mrb, mrb_value self)
{
    mrb_int t;
    mrb_get_args(mrb, "i", &t);

    DelayMs((WORD)t);

    return mrb_nil_value();
}

mrb_value mrb_config_timer5(mrb_state* mrb, mrb_value self)
{
    mrb_int timer_interval;
    mrb_get_args(mrb, "i", &timer_interval);

    OpenTimer5(T5_ON | T5_SOURCE_INT | T5_PS_1_8, (WORD)timer_interval);
    ConfigIntTimer5(T5_INT_ON | T5_INT_PRIOR_5);

    return mrb_nil_value();
}

mrb_value mrb_onboard_led(mrb_state* mrb, mrb_value self)
{
    mrb_int id;
    mrb_value state;

    mrb_get_args(mrb, "iS", &id, &state);

    switch(id)
    {
    case 1:
        if(!strcmp(RSTRING_PTR(state), "on"))
        {
            turnOnLED1();
        }
        else if(!strcmp(RSTRING_PTR(state), "off"))
        {
            turnOffLED1();
        }
        else if(!strcmp(RSTRING_PTR(state), "toggle"))
        {
            toggleLED1();
        }
        break;
    case 2:
        if(!strcmp(RSTRING_PTR(state), "on"))
        {
            turnOnLED2();
        }
        else if(!strcmp(RSTRING_PTR(state), "off"))
        {
            turnOffLED2();
        }
        else if(!strcmp(RSTRING_PTR(state), "toggle"))
        {
            toggleLED2();
        }
        break;
    }

    return mrb_nil_value();
}

mrb_value mrb_init_io_ports(mrb_state* mrb, mrb_value self)
{
    BYTE i = 0;

    for(i = 0; i < 14; i++)
        setAnPortDioType(i, IO_IN);

    for(i = 0; i < 4; i++)
    {
        setPwmPortDioType(i, IO_OUT);
        outputPwmPort(i, LOW);
    }

    for(i = 0; i < 4; i++)
    {
        setDigitalPortDioType(i, IO_OUT);
        outputDigitalPort(i, LOW);
    }

    setSpiPortDioType("sck2", IO_OUT);
    setSpiPortDioType("sdi2", IO_OUT);
    setSpiPortDioType("sdo2", IO_OUT);
    setSpiPortDioType("sck4", IO_OUT);
    setSpiPortDioType("sdi4", IO_OUT);
    setSpiPortDioType("sdo4", IO_OUT);
    outputSpiPort("sck2", LOW);
    outputSpiPort("sdi2", LOW);
    outputSpiPort("sdo2", LOW);
    outputSpiPort("sck4", LOW);
    outputSpiPort("sdi4", LOW);
    outputSpiPort("sdo4", LOW);

    return mrb_nil_value();
}

mrb_value mrb_set_port_io_type(mrb_state* mrb, mrb_value self)
{
    mrb_value name;
    mrb_value type;

    mrb_get_args(mrb, "SS", &name, &type);

    if(!strcmp(RSTRING_PTR(type), "in"))
       setPortIOType(RSTRING_PTR(name), IO_IN);
    else if(!strcmp(RSTRING_PTR(type), "out"))
       setPortIOType(RSTRING_PTR(name), IO_OUT);

    return mrb_nil_value();
}

mrb_value mrb_get_port_io_type(mrb_state* mrb, mrb_value self)
{
    mrb_value name;
    mrb_value str_type;
    BYTE type;

    mrb_get_args(mrb, "S", &name);

    type = getPortIOType(RSTRING_PTR(name));
    if(type == IO_IN)
        str_type = mrb_str_new_cstr(mrb, "in");
    else if(type == IO_OUT)
        str_type = mrb_str_new_cstr(mrb, "out");

    return str_type;
}

mrb_value mrb_output_port(mrb_state* mrb, mrb_value self)
{
    mrb_value name;
    mrb_value state;

    mrb_get_args(mrb, "SS", &name, &state);

    if(!strcmp(RSTRING_PTR(state), "high"))
        outputPort(RSTRING_PTR(name), HIGH);
    else if(!strcmp(RSTRING_PTR(state), "low"))
        outputPort(RSTRING_PTR(name), LOW);

    return mrb_nil_value();
}

mrb_value mrb_input_port(mrb_state* mrb, mrb_value self)
{
    mrb_value name;
    mrb_value str_state;
    BYTE state;

    mrb_get_args(mrb, "S", &name);

    state = inputPort(RSTRING_PTR(name));
    if(state == HIGH)
        str_state = mrb_str_new_cstr(mrb, "high");
    else if(state == LOW)
        str_state = mrb_str_new_cstr(mrb, "low");

    return str_state;
}

/**********************************************
*  OSC Generic I/O Processing Part
**********************************************/
mrb_value mrb_init_osc_config(mrb_state* mrb, mrb_value self)
{
    mrb_value osc_host_name;
    mrb_value osc_prefix;
    mrb_int local_port;
    mrb_int remote_port;

    mrb_get_args(mrb, "SSii", &osc_host_name, &osc_prefix, &local_port, &remote_port);
    
    setOSCPrefix(RSTRING_PTR(osc_prefix));
    setLocalPort(local_port);
    setRemotePort(remote_port);

    setOSCHostName(RSTRING_PTR(osc_host_name));

    TickInit();
    InitAppConfig();
    StackInit();
    ZeroconfLLInitialize();
    mDNSInitialize(getOSCHostName());
    mDNSServiceRegister((const char *)getOSCHostName(), // base name of the service
                        "_oscit._udp.local",            // type of the service
                        getLocalPort(),                 // TCP or UDP port, at which this service is available
                        ((const BYTE *)""),             // TXT info
                        1,                              // auto rename the service when if needed
                        NULL,                           // no callback function
                        NULL                            // no application context
                        );
    mDNSMulticastFilterRegister();

    //OpenTimer5(T5_ON | T5_SOURCE_INT | T5_PS_1_8, TIMER5_COUNT);
    //ConfigIntTimer5(T5_INT_ON | T5_INT_PRIOR_5);

    // Enable multi-vectored interrupts
    INTEnableSystemMultiVectoredInt();

    return mrb_nil_value();
}

mrb_value mrb_network_tasks(mrb_state* mrb, mrb_value self)
{
    mrb_int eth_state;

    mrb_get_args(mrb, "i", &eth_state);

    StackTask();

    switch(eth_state)
    {
        case 0:
#if 0
            NBNSTask();
            eth_state = 1;
            break;
        case 1:
            ZeroconfLLProcess();
            eth_state = 1;// 2;
            break;
        case 1:
#endif
            mDNSProcess();
            eth_state = 1;// 3;
            break;
        case 1:
            DHCPServerTask();
            eth_state = 0;
            break;
        default:
            //ZeroconfLLProcess();
            mDNSProcess();
            eth_state = 0;
            break;
    }

    if(dwLastIP != AppConfig.MyIPAddr.Val)
    {
        dwLastIP = AppConfig.MyIPAddr.Val;
        mDNSFillHostRecord();
    }

    return mrb_fixnum_value(eth_state);
}

mrb_value mrb_receive_osc_task(mrb_state* mrb, mrb_value self)
{
    BYTE index;
    int i, j, k;
    //debug static BYTE testNum = 0;

    getOSCPacket();

    if(processOSCPacket())
    {
        //debug LED_2_On();

        if(compareOSCPrefix(getOSCPrefix()))
        {
#if defined(USE_LCD)
            else if(compareOSCAddress(msgSetLcdConfig))
            {
                BYTE mode_num;
                char* rsname;
                char* rwname;
                char* ename;
                char* db0name;
                char* db1name;
                char* db2name;
                char* db3name;
                char* db4name;
                char* db5name;
                char* db6name;
                char* db7name;

                //if(getArgumentsLength() != 8 && getArgumentsLength() != 12)
                if(getArgumentsLength() != 8)
                {
                    //sendOSCMessage(sysPrefix, msgError, "ss", msgSetLcdConfig, "need_8_or_12_arguments_at_leaset");
                    sendOSCMessage(sysPrefix, msgError, "ss", msgSetLcdConfig, "need_8_arguments");
                    return mrb_nil_value();
                }

                if(compareTypeTagAtIndex(0, 'i') && compareTypeTagAtIndex(1, 's') && compareTypeTagAtIndex(2, 's') && compareTypeTagAtIndex(3, 's'))
                {
                    mode_num = getIntArgumentAtIndex(0);
                    rsname = getStringArgumentAtIndex(1);
                    rwname = getStringArgumentAtIndex(2);
                    ename = getStringArgumentAtIndex(3);
                    switch(mode_num)
                    {
                        case 4:
                            if(compareTypeTagAtIndex(4, 's') && compareTypeTagAtIndex(5, 's') && compareTypeTagAtIndex(6, 's') &&
                               compareTypeTagAtIndex(7, 's'))
                            {
                                db4name = getStringArgumentAtIndex(4);
                                db5name = getStringArgumentAtIndex(5);
                                db6name = getStringArgumentAtIndex(6);
                                db7name = getStringArgumentAtIndex(7);
                            }
                            else
                            {
                                sendOSCMessage(sysPrefix, msgError, "ss", msgSetLcdConfig, ": wrong_argument_type");
                                return mrb_nil_value();
                            }
                            initLcd(mode_num, rsname, rwname, ename, NULL, NULL, NULL, NULL, db4name, db5name, db6name, db7name);
                            break;
#if 0
                        case 8:
                            if(compareTypeTagAtIndex(4, 's') && compareTypeTagAtIndex(5, 's') && compareTypeTagAtIndex(6, 's') &&
                               compareTypeTagAtIndex(7, 's') && compareTypeTagAtIndex(8, 's') && compareTypeTagAtIndex(9, 's') &&
                               compareTypeTagAtIndex(10, 's') && compareTypeTagAtIndex(11, 's'))
                            {
                                db0name = getStringArgumentAtIndex(4);
                                db1name = getStringArgumentAtIndex(5);
                                db2name = getStringArgumentAtIndex(6);
                                db3name = getStringArgumentAtIndex(7);
                                db4name = getStringArgumentAtIndex(8);
                                db5name = getStringArgumentAtIndex(9);
                                db6name = getStringArgumentAtIndex(10);
                                db7name = getStringArgumentAtIndex(11);
                            }
                            else
                            {
                                sendOSCMessage(sysPrefix, msgError, "ss", msgSetLcdConfig, ": wrong_argument_type");
                                return mrb_nil_value();
                            }
                            initLcd(mode_num, rsname, rwname, ename, db0name, db1name, db2name, db3name, db4name, db5name, db6name, db7name);
                            break;
#endif
                        default:
                            sendOSCMessage(sysPrefix, msgError, "ss", msgSetLcdConfig, ": support_only_4_bit_mode");
                            return mrb_nil_value();
                            break;
                    }
                }
                else
                {
                    sendOSCMessage(sysPrefix, msgError, "ss", msgSetLcdConfig, ": wrong_argument_type");
                    return mrb_nil_value();
                }
            }
            else if(compareOSCAddress(msgSetLcdText))
            {
                BYTE i = 0;
                BYTE line_num = 0;
                BYTE chars_num = 0;
                char line_text[20] = {0};
                BYTE len = getArgumentsLength();

                if(len < 2)
                {
                    sendOSCMessage(sysPrefix, msgError, "ss", msgSetLcdText, "need_2_arguments_at_least");
                    return mrb_nil_value();
                }

                if(compareTypeTagAtIndex(0, 'i') && compareTypeTagAtIndex(1, 's'))
                {
                    line_num = getIntArgumentAtIndex(0);
                    chars_num = strlen(getStringArgumentAtIndex(1));
                    if(chars_num <= 20)
                        strcpy(line_text, getStringArgumentAtIndex(1));
                    else
                    {
                        sendOSCMessage(sysPrefix, msgError, "ss", msgSetLcdText, "string_must_be_less_than_20_chars");
                        return mrb_nil_value();
                    }

                    for(i = 2; i < len; i++)
                    {
                        if(compareTypeTagAtIndex(i, 's'))
                        {
                            chars_num += strlen(getStringArgumentAtIndex(i));
                            chars_num++;
                            if(chars_num <= 20)
                            {
                                strcat(line_text, " ");
                                strcat(line_text, getStringArgumentAtIndex(i));
                            }
                            else
                                break;
                        }
                        else
                        {
                            sendOSCMessage(sysPrefix, msgError, "ss", msgSetLcdText, ": wrong_argument_type");
                            return mrb_nil_value();
                        }
                    }
                    writeLineLcd(line_num, line_text);
                }
                else
                {
                    sendOSCMessage(sysPrefix, msgError, "ss", msgSetLcdText, ": wrong_argument_type");
                    return mrb_nil_value();
                }
            }
            else if(compareOSCAddress(msgClearLcdText))
            {
                BYTE line_num;
                char* clear_all;
                char* clear_text = " ";

                if(getArgumentsLength() != 1)
                {
                    sendOSCMessage(sysPrefix, msgError, "ss", msgClearLcdText, "need_1_arguments");
                    return mrb_nil_value();
                }

                if(compareTypeTagAtIndex(0, 'i'))
                {
                    line_num = getIntArgumentAtIndex(0);
                    writeLineLcd(line_num, clear_text);
                }
                else if(compareTypeTagAtIndex(0, 's'))
                {
                    clear_all = getStringArgumentAtIndex(0);
                    if(!strcmp(clear_all, "all"))
                        eraseLcd();
                    else
                    {
                        sendOSCMessage(sysPrefix, msgError, "ss", msgClearLcdText, ": please_type_all");
                        return mrb_nil_value();
                    }
                }
                else
                {
                    sendOSCMessage(sysPrefix, msgError, "ss", msgClearLcdText, ": wrong_argument_type");
                    return mrb_nil_value();
                }
            }
#endif // #if defined(USE_LCD)
#if defined(USE_LED_PAD)
            else if(compareOSCAddress(msgLatticePadPinSelect))
            {
                if(getArgumentsLength() < 4)
                {
                    sendOSCMessage(sysPrefix, msgError, "ss", msgLatticePadPinSelect, ": too_few_arguments");
                    return mrb_nil_value();
                }
                if((compareTypeTagAtIndex(0, 'i') || compareTypeTagAtIndex(0, 'f')) && compareTypeTagAtIndex(1, 's') && compareTypeTagAtIndex(2, 's') && compareTypeTagAtIndex(3, 's'))
                {
                    BYTE index = getIntArgumentAtIndex(0);
                    char* name_clk = getStringArgumentAtIndex(1);
                    char* name_shld = getStringArgumentAtIndex(2);
                    char* name_qh = getStringArgumentAtIndex(3);

                    if(strlen(name_clk) > 3 || strlen(name_shld) > 3 || strlen(name_qh) > 3)
                    {
                        sendOSCMessage(sysPrefix, msgError, "ss", msgLatticePadPinSelect, ": too_long_string_length");
                        return mrb_nil_value();
                    }

                    setLatticePadPortClkName(index, name_clk);
                    setPortIOType(getLatticePadPortClkName(index), IO_OUT);
                    setLatticePadPortShLdName(index, name_shld);
                    setPortIOType(getLatticePadPortShLdName(index), IO_OUT);
                    setLatticePadPortQhName(index, name_qh);
                    setPortIOType(getLatticePadPortQhName(index), IO_IN);

                    setInitPadFlag(TRUE);
                }
                else
                {
                    sendOSCMessage(sysPrefix, msgError, "ss", msgLatticePadPinSelect, ": wrong_argument_type");
                    return mrb_nil_value();
                }
            }
            else if(compareOSCAddress(msgLatticeLedDrvPinSelect))
            {
                if(getArgumentsLength() < 2)
                {
                    sendOSCMessage(sysPrefix, msgError, "ss", msgLatticeLedDrvPinSelect, ": too_few_arguments");
                    return mrb_nil_value();
                }
                if((compareTypeTagAtIndex(0, 'i') || compareTypeTagAtIndex(0, 'f')) && compareTypeTagAtIndex(1, 's'))
                {
                    BYTE num = getIntArgumentAtIndex(0);
                    char* name_load = getStringArgumentAtIndex(1);

                    if(strlen(name_load) > 3)
                    {
                        sendOSCMessage(sysPrefix, msgError, "ss", msgLatticeLedDrvPinSelect, ": too_long_string_length");
                        return mrb_nil_value();
                    }

                    setLatticePadPortLoadName(name_load);
                    setPortIOType(name_load, IO_OUT);
                    outputPort(name_load, LOW);

                    switch(num)
                    {
                        case 2:
                            setLatticeLedDriverSpiNumber(2);
                            SpiChnClose(2);
                            SpiChnOpen(SPI_CHANNEL2, SPICON_MSTEN | SPICON_SMP | SPICON_MODE16 | SPICON_CKE | SPICON_ON, 4);
                            setInitLatticeLedDrvFlag(TRUE);
                            break;
                        case 4:
                            setLatticeLedDriverSpiNumber(4);
                            SpiChnClose(4);
                            SpiChnOpen(SPI_CHANNEL4, SPICON_MSTEN | SPICON_SMP | SPICON_MODE16 | SPICON_CKE | SPICON_ON, 4);
                            setInitLatticeLedDrvFlag(TRUE);
                            break;
                        default:
                            sendOSCMessage(sysPrefix, msgError, "ss", msgLatticeLedDrvPinSelect, ": out_of_range_value");
                            return mrb_nil_value();
                            break;
                    }
                }
                else
                {
                    sendOSCMessage(sysPrefix, msgError, "ss", msgLatticeLedDrvPinSelect, ": wrong_argument_type");
                    return mrb_nil_value();
                }
            }
            else if(compareOSCAddress(msgSetLatticePadConnectedNum))
            {
                if(compareTypeTagAtIndex(0, 'i') || compareTypeTagAtIndex(0, 'f'))
                {
                    int num = getIntArgumentAtIndex(0);
                    if(num < 1)
                    {
                        sendOSCMessage(sysPrefix, msgError, "ss", msgSetLatticePadConnectedNum, ": out_of_range_value");
                        return mrb_nil_value();
                    }
                    setNumConnectedLatticePad(num);
                }
                else
                {
                    sendOSCMessage(sysPrefix, msgError, "ss", msgSetLatticePadConnectedNum, ": wrong_argument_type");
                    return mrb_nil_value();
                }
            }
            else if(compareOSCAddress(msgGetLatticePadConnectedNum))
            {
                sendOSCMessage(getOSCPrefix(), msgLatticePadConnectedNum, "i", getNumConnectedLatticePad());
            }
            else if(compareOSCAddress(msgSetLatticeLed))
            {
                if(getArgumentsLength() < 4)
                {
                    sendOSCMessage(sysPrefix, msgError, "ss", msgSetLatticeLed, ": too_few_arguments");
                    return mrb_nil_value();
                }
                if((compareTypeTagAtIndex(0, 'i') || compareTypeTagAtIndex(0, 'f')) &&
                   (compareTypeTagAtIndex(1, 'i') || compareTypeTagAtIndex(1, 'f')) &&
                   (compareTypeTagAtIndex(2, 'i') || compareTypeTagAtIndex(2, 'f')) &&
                   (compareTypeTagAtIndex(3, 'i') || compareTypeTagAtIndex(3, 'f')))
                {
                    BYTE index = getIntArgumentAtIndex(0);
                    BYTE x = getIntArgumentAtIndex(1);
                    BYTE y = getIntArgumentAtIndex(2);
                    BYTE state = getIntArgumentAtIndex(3);
                    BYTE intensity;
                    WORD pos = (1 << y) << (x * 4);

                    if(x > 3 || y > 3 || state > 1)
                    {
                        sendOSCMessage(sysPrefix, msgError, "ss", msgSetLatticeLed, ": out_of_range_value");
                        return mrb_nil_value();
                    }

                    if(getArgumentsLength() == 4)
                        setLatticeIntensity(index, y + (x * 4), 100);
                    else if(getArgumentsLength() == 5)
                    {
                        if(compareTypeTagAtIndex(4, 'i') || compareTypeTagAtIndex(4, 'f'))
                        {
                            intensity = getIntArgumentAtIndex(4);
                            if(intensity > 100)
                                intensity = 100;
                            setLatticeIntensity(index, y + (x * 4), intensity);
                        }
                        else
                        {
                            sendOSCMessage(sysPrefix, msgError, "ss", msgSetLatticeLed, ": wrong_argument_type");
                            return mrb_nil_value();
                        }
                    }

                    if(state)
                        setLatticeLed(index, getLatticeLed(index) | pos);
                    else
                        setLatticeLed(index, getLatticeLed(index) & ~pos);

                    if(getLatticeLed(index) != 0)
                        setLatticeLedOn(index, TRUE);
                    else
                        setLatticeLedOn(index, FALSE);
                }
                else
                {
                    sendOSCMessage(sysPrefix, msgError, "ss", msgSetLatticeLed, ": wrong_argument_type");
                    return mrb_nil_value();
                }
            }
            else if(compareOSCAddress(msgSetLatticeLedColumn))
            {
                if(getArgumentsLength() < 3)
                {
                    sendOSCMessage(sysPrefix, msgError, "ss", msgSetLatticeLedColumn, ": too_few_arguments");
                    return mrb_nil_value();
                }
                if((compareTypeTagAtIndex(0, 'i') || compareTypeTagAtIndex(0, 'f')) &&
                   (compareTypeTagAtIndex(1, 'i') || compareTypeTagAtIndex(1, 'f')) &&
                   (compareTypeTagAtIndex(2, 'i') || compareTypeTagAtIndex(2, 'f')))
                {
                    BYTE index = getIntArgumentAtIndex(0);
                    BYTE column = getIntArgumentAtIndex(1);
                    BYTE data = getIntArgumentAtIndex(2);

                    if(column > 3 || data > 15)
                    {
                        sendOSCMessage(sysPrefix, msgError, "ss", msgSetLatticeLedColumn, ": out_of_range_value");
                        return mrb_nil_value();
                    }

                    setLatticeLed(index, getLatticeLed(index) & ~(0x000F << (column * 4)));
                    setLatticeLed(index, getLatticeLed(index) | (data << (column * 4)));

                    if(getArgumentsLength() == 3)
                    {
                        for(i = 0; i < 4; i++)
                            setLatticeIntensity(index, i + (column * 4), 100);
                    }
                    else if(getArgumentsLength() == 7)
                    {
                        for(i = 0; i < 4; i++)
                            setLatticeIntensity(index, i + (column * 4), getIntArgumentAtIndex(3 + i));
                    }
                    else
                    {
                        sendOSCMessage(sysPrefix, msgError, "ss", msgSetLatticeLedColumn, ": too_few_intensity_value");
                        return mrb_nil_value();
                    }

                    if(getLatticeLed(index) != 0)
                        setLatticeLedOn(index, TRUE);
                    else
                        setLatticeLedOn(index, FALSE);
                }
                else
                {
                    sendOSCMessage(sysPrefix, msgError, "ss", msgSetLatticeLedColumn, ": wrong_argument_type");
                    return mrb_nil_value();
                }
            }
            else if(compareOSCAddress(msgSetLatticeLedRow))
            {
                if(getArgumentsLength() < 3)
                {
                    sendOSCMessage(sysPrefix, msgError, "ss", msgSetLatticeLedColumn, ": too_few_arguments");
                    return mrb_nil_value();
                }
                if((compareTypeTagAtIndex(0, 'i') || compareTypeTagAtIndex(0, 'f')) &&
                   (compareTypeTagAtIndex(1, 'i') || compareTypeTagAtIndex(1, 'f')) &&
                   (compareTypeTagAtIndex(2, 'i') || compareTypeTagAtIndex(2, 'f')))
                {
                    BYTE index = getIntArgumentAtIndex(0);
                    BYTE row = getIntArgumentAtIndex(1);
                    BYTE data = getIntArgumentAtIndex(2);
                    WORD data1 = 0;

                    if(row > 3 || data > 15)
                    {
                        sendOSCMessage(sysPrefix, msgError, "ss", msgSetLatticeLedRow, ": out_of_range_value");
                        return mrb_nil_value();
                    }

                    for(i = 0; i < 4; i++)
                    {
                        if((data >> i) & 0x01)
                            data1 |= (1 << (i * 4));
                    }
                    setLatticeLed(index, getLatticeLed(index) & ~(0x1111 << row));
                    setLatticeLed(index, getLatticeLed(index) | (data1 << row));

                    if(getArgumentsLength() == 3)
                    {
                        for(i = 0; i < 4; i++)
                            setLatticeIntensity(index, row + (i * 4), 100);
                    }
                    else if(getArgumentsLength() == 7)
                    {
                        for(i = 0; i < 4; i++)
                            setLatticeIntensity(index, row + (i * 4), getIntArgumentAtIndex(3 + i));
                    }
                    else
                    {
                        sendOSCMessage(sysPrefix, msgError, "ss", msgSetLatticeLedRow, ": too_few_intensity_value");
                        return mrb_nil_value();
                    }

                    if(getLatticeLed(index) != 0)
                        setLatticeLedOn(index, TRUE);
                    else
                        setLatticeLedOn(index, FALSE);
                }
                else
                {
                    sendOSCMessage(sysPrefix, msgError, "ss", msgSetLatticeLedRow, ": wrong_argument_type");
                    return mrb_nil_value();
                }
            }
            else if(compareOSCAddress(msgSetLatticeLedAll))
            {
                if(getArgumentsLength() < 5)
                {
                    sendOSCMessage(sysPrefix, msgError, "ss", msgSetLatticeLedAll, ": too_few_arguments");
                    return mrb_nil_value();
                }
                if((compareTypeTagAtIndex(0, 'i') || compareTypeTagAtIndex(0, 'f')) &&
                   (compareTypeTagAtIndex(1, 'i') || compareTypeTagAtIndex(1, 'f')) &&
                   (compareTypeTagAtIndex(2, 'i') || compareTypeTagAtIndex(2, 'f')))
                {
                    BYTE index = getIntArgumentAtIndex(0);
                    BYTE data = 0;
                    WORD data1;

                    for(i = 0; i < 4; i++)
                    {
                        data = getIntArgumentAtIndex(i + 1);
                        if(data > 15)
                        {
                            sendOSCMessage(sysPrefix, msgError, "ss", msgSetLatticeLedAll, ": out_of_range_value");
                            return mrb_nil_value();
                        }

                        data1 = 0;
                        for(j = 0; j < 4; j++)
                        {
                            if((data >> j) & 0x01)
                                data1 |= (1 << (j * 4));
                        }
                        setLatticeLed(index, getLatticeLed(index) & ~(0x1111 << i));
                        setLatticeLed(index, getLatticeLed(index) | (data1 << i));
                    }

                    if(getArgumentsLength() == 5)
                    {
                        for(i = 0; i < 16; i++)
                            setLatticeIntensity(index, i, 100);
                    }
                    else if(getArgumentsLength() == 21)
                    {
                        for(i = 0; i < 16; i++)
                        {
                            //setLatticeIntensity(index, i, getIntArgumentAtIndex(5 + i));
                            BYTE ii = (i - (i / 4) * 4) * 4 + (i / 4);
                            setLatticeIntensity(index, ii, getIntArgumentAtIndex(5 + i));
                        }
                    }
                    else
                    {
                        sendOSCMessage(sysPrefix, msgError, "ss", msgSetLatticeLedAll, ": too_few_intensity_value");
                        return mrb_nil_value();
                    }

                    if(getLatticeLed(index) != 0)
                        setLatticeLedOn(index, TRUE);
                    else
                        setLatticeLedOn(index, FALSE);
                }
                else
                {
                    sendOSCMessage(sysPrefix, msgError, "ss", msgSetLatticeLedColumn, ": wrong_argument_type");
                    return mrb_nil_value();
                }
            }
            else if(compareOSCAddress(msgLatticeLedClear))
            {
                if(getArgumentsLength() < 1)
                {
                    sendOSCMessage(sysPrefix, msgError, "ss", msgLatticeLedClear, ": too_few_arguments");
                    return mrb_nil_value();
                }

                if(compareTypeTagAtIndex(0, 'i') || compareTypeTagAtIndex(0, 'f'))
                {
                    BYTE index = getIntArgumentAtIndex(0);
                    setLatticeLed(index, 0);
                    setLatticeLedOn(index, FALSE);
                }
                else
                {
                    sendOSCMessage(sysPrefix, msgError, "ss", msgLatticeLedClear, ": wrong_argument_type");
                    return mrb_nil_value();
                }
            }
            else if(compareOSCAddress(msgGetLatticeLedIntensity))
            {
                if(getArgumentsLength() < 3)
                {
                    sendOSCMessage(sysPrefix, msgError, "ss", msgGetLatticeLedIntensity, ": too_few_arguments");
                    return mrb_nil_value();
                }

                if((compareTypeTagAtIndex(0, 'i') || compareTypeTagAtIndex(0, 'f')) &&
                   (compareTypeTagAtIndex(1, 'i') || compareTypeTagAtIndex(1, 'f')) &&
                   (compareTypeTagAtIndex(2, 'i') || compareTypeTagAtIndex(2, 'f')))
                {
                    BYTE index = getIntArgumentAtIndex(0);
                    BYTE x = getIntArgumentAtIndex(1);
                    BYTE y = getIntArgumentAtIndex(2);

                    if(x > 3 || y > 3)
                    {
                        sendOSCMessage(sysPrefix, msgError, "ss", msgGetLatticeLedIntensity, ": out_of_range_value");
                        return mrb_nil_value();
                    }

                    sendOSCMessage(getOSCPrefix(), msgLatticeLedIntensity, "iiii", index, x, y, getLatticeIntensity(index, y + (x * 4)));
                }
                else
                {
                    sendOSCMessage(sysPrefix, msgError, "ss", msgGetLatticeLedIntensity, ": wrong_argument_type");
                    return mrb_nil_value();
                }
            }
            else if(compareOSCAddress(msgGetLatticeLedIntensityAll))
            {
                if(getArgumentsLength() < 1)
                {
                    sendOSCMessage(sysPrefix, msgError, "ss", msgGetLatticeLedIntensity, ": too_few_arguments");
                    return mrb_nil_value();
                }

                if(compareTypeTagAtIndex(0, 'i') || compareTypeTagAtIndex(0, 'f'))
                {
                    BYTE index = getIntArgumentAtIndex(0);

                    sendOSCMessage(getOSCPrefix(), msgLatticeLedIntensity, "iiiiiiiiiiiiiiiii", index,
                                   getLatticeIntensity(index, 0), getLatticeIntensity(index, 1),
                                   getLatticeIntensity(index, 2), getLatticeIntensity(index, 3),
                                   getLatticeIntensity(index, 4), getLatticeIntensity(index, 5),
                                   getLatticeIntensity(index, 6), getLatticeIntensity(index, 7),
                                   getLatticeIntensity(index, 8), getLatticeIntensity(index, 9),
                                   getLatticeIntensity(index, 10), getLatticeIntensity(index, 11),
                                   getLatticeIntensity(index, 12), getLatticeIntensity(index, 13),
                                   getLatticeIntensity(index, 14), getLatticeIntensity(index, 15));
                }
                else
                {
                    sendOSCMessage(sysPrefix, msgError, "ss", msgGetLatticeLedIntensity, ": wrong_argument_type");
                    return mrb_nil_value();
                }
            }
            else if(compareOSCAddress(msgLatticePadPinSelect))
            {
                if(getArgumentsLength() < 4)
                {
                    sendOSCMessage(sysPrefix, msgError, "ss", msgLatticePadPinSelect, ": too_few_arguments");
                    return mrb_nil_value();
                }
                if((compareTypeTagAtIndex(0, 'i') || compareTypeTagAtIndex(0, 'f')) && compareTypeTagAtIndex(1, 's') && compareTypeTagAtIndex(2, 's') && compareTypeTagAtIndex(3, 's'))
                {
                    BYTE index = getIntArgumentAtIndex(0);
                    char* name_clk = getStringArgumentAtIndex(1);
                    char* name_shld = getStringArgumentAtIndex(2);
                    char* name_qh = getStringArgumentAtIndex(3);

                    if(strlen(name_clk) > 3 || strlen(name_shld) > 3 || strlen(name_qh) > 3)
                    {
                        sendOSCMessage(sysPrefix, msgError, "ss", msgLatticePadPinSelect, ": too_long_string_length");
                        return mrb_nil_value();
                    }

                    setLatticePadPortClkName(index, name_clk);
                    setPortIOType(getLatticePadPortClkName(index), IO_OUT);
                    setLatticePadPortShLdName(index, name_shld);
                    setPortIOType(getLatticePadPortShLdName(index), IO_OUT);
                    setLatticePadPortQhName(index, name_qh);
                    setPortIOType(getLatticePadPortQhName(index), IO_IN);

                    setInitPadFlag(TRUE);
                }
                else
                {
                    sendOSCMessage(sysPrefix, msgError, "ss", msgLatticePadPinSelect, ": wrong_argument_type");
                    return mrb_nil_value();
                }
            }
            else if(compareOSCAddress(msgLatticeRgbDrvPinSelect))
            {
                if(getArgumentsLength() < 2)
                {
                    sendOSCMessage(sysPrefix, msgError, "ss", msgLatticeRgbDrvPinSelect, ": too_few_arguments");
                    return mrb_nil_value();
                }
                if((compareTypeTagAtIndex(0, 'i') || compareTypeTagAtIndex(0, 'f')) && compareTypeTagAtIndex(1, 's'))
                {
                    BYTE num = getIntArgumentAtIndex(0);
                    char* name_load = getStringArgumentAtIndex(1);

                    if(strlen(name_load) > 3)
                    {
                        sendOSCMessage(sysPrefix, msgError, "ss", msgLatticeRgbDrvPinSelect, ": too_long_string_length");
                        return mrb_nil_value();
                    }

                    setLatticePadPortLoadName(name_load);
                    setPortIOType(name_load, IO_OUT);
                    outputPort(name_load, LOW);
                    //setLatticeRgbLedNumber(num, lnum);

                    switch(num)
                    {
                        case 2:
                            setLatticeRgbDriverSpiNumber(2);
                            SpiChnClose(2);
                            SpiChnOpen(SPI_CHANNEL2, SPICON_MSTEN | SPICON_SMP | SPICON_MODE16 | SPICON_CKE | SPICON_ON, 4);
                            setInitLatticeRgbDrvFlag(TRUE);
                            break;
                        case 4:
                            setLatticeRgbDriverSpiNumber(4);
                            SpiChnClose(4);
                            SpiChnOpen(SPI_CHANNEL4, SPICON_MSTEN | SPICON_SMP | SPICON_MODE16 | SPICON_CKE | SPICON_ON, 4);
                            setInitLatticeRgbDrvFlag(TRUE);
                            break;
                        default:
                            sendOSCMessage(sysPrefix, msgError, "ss", msgLatticeRgbDrvPinSelect, ": out_of_range_value");
                            return mrb_nil_value();
                            break;
                    }
                }
                else
                {
                    sendOSCMessage(sysPrefix, msgError, "ss", msgLatticeRgbDrvPinSelect, ": wrong_argument_type");
                    return mrb_nil_value();
                }
            }
            else if(compareOSCAddress(msgSetLatticeRgbConnectedNum))
            {
                if(getArgumentsLength() < 1)
                {
                    sendOSCMessage(sysPrefix, msgError, "ss", msgSetLatticeRgbConnectedNum, ": too_few_arguments");
                    return mrb_nil_value();
                }
                if(compareTypeTagAtIndex(0, 'i') || compareTypeTagAtIndex(0, 'f'))
                {
                    int num = getIntArgumentAtIndex(0);
                    if(num < 1)
                    {
                        sendOSCMessage(sysPrefix, msgError, "ss", msgSetLatticeRgbConnectedNum, ": out_of_range_value");
                        return mrb_nil_value();
                    }
                    setNumConnectedLatticeRgb(num);
                }
                else
                {
                    sendOSCMessage(sysPrefix, msgError, "ss", msgSetLatticeRgbConnectedNum, ": wrong_argument_type");
                    return mrb_nil_value();
                }
            }
            else if(compareOSCAddress(msgGetLatticeRgbConnectedNum))
            {
                sendOSCMessage(getOSCPrefix(), msgLatticeRgbConnectedNum, "i", getNumConnectedLatticeRgb());
            }
            else if(compareOSCAddress(msgSetLatticeRgbSize))
            {
                if(getArgumentsLength() < 2)
                {
                    sendOSCMessage(sysPrefix, msgError, "ss", msgSetLatticeRgbSize, ": too_few_arguments");
                    return mrb_nil_value();
                }
                if((compareTypeTagAtIndex(0, 'i') || compareTypeTagAtIndex(0, 'f')) && (compareTypeTagAtIndex(1, 'i') || compareTypeTagAtIndex(1, 'f')))
                {
                    BYTE index = getIntArgumentAtIndex(0);
                    BYTE size = getIntArgumentAtIndex(1);

                    if(index > 3 || !(size == 8 || size == 16))
                    {
                        sendOSCMessage(sysPrefix, msgError, "ss", msgLatticeRgbDrvPinSelect, ": too_long_string_length");
                        return mrb_nil_value();
                    }

                    setLatticeRgbLedNumber(index, size);
                }
                else
                {
                    sendOSCMessage(sysPrefix, msgError, "ss", msgSetLatticeRgbSize, ": wrong_argument_type");
                    return mrb_nil_value();
                }
            }
            else if(compareOSCAddress(msgGetLatticeRgbSize))
            {
                if(getArgumentsLength() < 1)
                {
                    sendOSCMessage(sysPrefix, msgError, "ss", msgSetLatticeRgbSize, ": too_few_arguments");
                    return mrb_nil_value();
                }
                if(compareTypeTagAtIndex(0, 'i') || compareTypeTagAtIndex(0, 'f'))
                {
                    BYTE index = getIntArgumentAtIndex(0);

                    if(index > 4)
                    {
                        sendOSCMessage(sysPrefix, msgError, "ss", msgGetLatticeRgbSize, ": too_long_string_length");
                        return mrb_nil_value();
                    }

                    sendOSCMessage(getOSCPrefix(), msgLatticeRgbSize, "ii", index, getLatticeRgbLedNumber(index));
                }
                else
                {
                    sendOSCMessage(sysPrefix, msgError, "ss", msgSetLatticeRgbSize, ": wrong_argument_type");
                    return mrb_nil_value();
                }
            }
            else if(compareOSCAddress(msgSetLatticeRgb))
            {
                if(getArgumentsLength() < 5)
                {
                    sendOSCMessage(sysPrefix, msgError, "ss", msgSetLatticeRgb, ": too_few_arguments");
                    return mrb_nil_value();
                }
                if((compareTypeTagAtIndex(0, 'i') || compareTypeTagAtIndex(0, 'f')) &&
                   (compareTypeTagAtIndex(1, 'i') || compareTypeTagAtIndex(1, 'f')) &&
                   (compareTypeTagAtIndex(2, 'i') || compareTypeTagAtIndex(2, 'f')) &&
                   (compareTypeTagAtIndex(3, 'i') || compareTypeTagAtIndex(3, 'f')) &&
                   (compareTypeTagAtIndex(4, 'i') || compareTypeTagAtIndex(4, 'f')))
                {
                    BYTE index = getIntArgumentAtIndex(0);
                    BYTE layer = getIntArgumentAtIndex(1);
                    BYTE x = getIntArgumentAtIndex(2);
                    BYTE y = getIntArgumentAtIndex(3);
                    BYTE state = getIntArgumentAtIndex(4);
                    BYTE intensity;
                    WORD pos = (1 << y) << (x * 4);


                    if(x > 3 || y > 3 || state > 1)
                    {
                        sendOSCMessage(sysPrefix, msgError, "ss", msgSetLatticeRgb, ": out_of_range_value");
                        return mrb_nil_value();
                    }

                    if(getArgumentsLength() == 5)
                        setLatticeRgbIntensity(index, layer, y + (x * 4), 100);
                    else if(getArgumentsLength() == 6)
                    {
                        if(compareTypeTagAtIndex(5, 'i') || compareTypeTagAtIndex(5, 'f'))
                        {
                            intensity = getIntArgumentAtIndex(5);
                            if(intensity > 100)
                                intensity = 100;

                            setLatticeRgbIntensity(index, layer, y + (x * 4), intensity);
                        }
                        else
                        {
                            sendOSCMessage(sysPrefix, msgError, "ss", msgSetLatticeRgb, ": wrong_argument_type");
                            return mrb_nil_value();
                        }
                    }

                    if(state)
                        setLatticeRgb(index, layer, getLatticeRgb(index, layer) | pos);
                    else
                        setLatticeRgb(index, layer, getLatticeRgb(index, layer) & ~pos);

                    if(getLatticeRgb(index, layer) != 0)
                        setLatticeRgbOn(index, layer, TRUE);
                    else
                        setLatticeRgbOn(index, layer, FALSE);
                }
                else
                {
                    sendOSCMessage(sysPrefix, msgError, "ss", msgSetLatticeRgb, ": wrong_argument_type");
                    return mrb_nil_value();
                }
            }
            else if(compareOSCAddress(msgSetLatticeRgbColumn))
            {
                if(getArgumentsLength() < 4)
                {
                    sendOSCMessage(sysPrefix, msgError, "ss", msgSetLatticeRgbColumn, ": too_few_arguments");
                    return mrb_nil_value();
                }
                if((compareTypeTagAtIndex(0, 'i') || compareTypeTagAtIndex(0, 'f')) &&
                   (compareTypeTagAtIndex(1, 'i') || compareTypeTagAtIndex(1, 'f')) &&
                   (compareTypeTagAtIndex(2, 'i') || compareTypeTagAtIndex(2, 'f')) &&
                   (compareTypeTagAtIndex(3, 'i') || compareTypeTagAtIndex(3, 'f')))
                {
                    BYTE index = getIntArgumentAtIndex(0);
                    BYTE layer = getIntArgumentAtIndex(1);
                    BYTE column = getIntArgumentAtIndex(2);
                    BYTE data = getIntArgumentAtIndex(3);

                    if(column > 3 || data > 15)
                    {
                        sendOSCMessage(sysPrefix, msgError, "ss", msgSetLatticeRgbColumn, ": out_of_range_value");
                        return mrb_nil_value();
                    }

                    setLatticeRgb(index, layer, getLatticeRgb(index, layer) & ~(0x000F << (column * 4)));
                    setLatticeRgb(index, layer, getLatticeRgb(index, layer) | (data << (column * 4)));

                    if(getArgumentsLength() == 4)
                    {
                        for(i = 0; i < 4; i++)
                            setLatticeRgbIntensity(index, layer, i + (column * 4), 100);
                    }
                    else if(getArgumentsLength() == 8)
                    {
                        for(i = 0; i < 4; i++)
                            setLatticeRgbIntensity(index, layer, i + (column * 4), getIntArgumentAtIndex(4 + i));
                    }
                    else
                    {
                        sendOSCMessage(sysPrefix, msgError, "ss", msgSetLatticeRgbColumn, ": too_few_intensity_value");
                        return mrb_nil_value();
                    }

                    if(getLatticeRgb(index, layer) != 0)
                        setLatticeRgbOn(index, layer, TRUE);
                    else
                        setLatticeRgbOn(index, layer, FALSE);
                }
                else
                {
                    sendOSCMessage(sysPrefix, msgError, "ss", msgSetLatticeRgbColumn, ": wrong_argument_type");
                    return mrb_nil_value();
                }
            }
            else if(compareOSCAddress(msgSetLatticeRgbRow))
            {
                if(getArgumentsLength() < 4)
                {
                    sendOSCMessage(sysPrefix, msgError, "ss", msgSetLatticeRgbRow, ": too_few_arguments");
                    return mrb_nil_value();
                }
                if((compareTypeTagAtIndex(0, 'i') || compareTypeTagAtIndex(0, 'f')) &&
                   (compareTypeTagAtIndex(1, 'i') || compareTypeTagAtIndex(1, 'f')) &&
                   (compareTypeTagAtIndex(2, 'i') || compareTypeTagAtIndex(2, 'f')) &&
                   (compareTypeTagAtIndex(3, 'i') || compareTypeTagAtIndex(3, 'f')))
                {
                    BYTE index = getIntArgumentAtIndex(0);
                    BYTE layer = getIntArgumentAtIndex(1);
                    BYTE row = getIntArgumentAtIndex(2);
                    BYTE data = getIntArgumentAtIndex(3);
                    WORD data1 = 0;

                    if(row > 3 || data > 15)
                    {
                        sendOSCMessage(sysPrefix, msgError, "ss", msgSetLatticeRgbRow, ": out_of_range_value");
                        return mrb_nil_value();
                    }

                    for(i = 0; i < 4; i++)
                    {
                        if((data >> i) & 0x01)
                            data1 |= (1 << (i * 4));
                    }
                    setLatticeRgb(index, layer, getLatticeRgb(index, layer) & ~(0x1111 << row));
                    setLatticeRgb(index, layer, getLatticeRgb(index, layer) | (data1 << row));

                    if(getArgumentsLength() == 4)
                    {
                        for(i = 0; i < 4; i++)
                            setLatticeRgbIntensity(index, layer, row + (i * 4), 100);
                    }
                    else if(getArgumentsLength() == 8)
                    {
                        for(i = 0; i < 4; i++)
                            setLatticeRgbIntensity(index, layer, row + (i * 4), getIntArgumentAtIndex(4 + i));
                    }
                    else
                    {
                        sendOSCMessage(sysPrefix, msgError, "ss", msgSetLatticeRgbRow, ": too_few_intensity_value");
                        return mrb_nil_value();
                    }

                    if(getLatticeRgb(index, layer) != 0)
                        setLatticeRgbOn(index, layer, TRUE);
                    else
                        setLatticeRgbOn(index, layer, FALSE);
                }
                else
                {
                    sendOSCMessage(sysPrefix, msgError, "ss", msgSetLatticeRgbRow, ": wrong_argument_type");
                    return mrb_nil_value();
                }
            }
            else if(compareOSCAddress(msgSetLatticeRgbAll))
            {
                if(getArgumentsLength() < 6)
                {
                    sendOSCMessage(sysPrefix, msgError, "ss", msgSetLatticeRgbAll, ": too_few_arguments");
                    return mrb_nil_value();
                }
                if((compareTypeTagAtIndex(0, 'i') || compareTypeTagAtIndex(0, 'f')) &&
                   (compareTypeTagAtIndex(1, 'i') || compareTypeTagAtIndex(1, 'f')) &&
                   (compareTypeTagAtIndex(2, 'i') || compareTypeTagAtIndex(2, 'f')) &&
                   (compareTypeTagAtIndex(3, 'i') || compareTypeTagAtIndex(3, 'f')))
                {
                    BYTE index = getIntArgumentAtIndex(0);
                    BYTE layer = getIntArgumentAtIndex(1);
                    BYTE data = 0;
                    WORD data1;

                    for(i = 0; i < 4; i++)
                    {
                        data = getIntArgumentAtIndex(i + 2);
                        if(data > 15)
                        {
                            sendOSCMessage(sysPrefix, msgError, "ss", msgSetLatticeRgbAll, ": out_of_range_value");
                            return mrb_nil_value();
                        }

                        data1 = 0;
                        for(j = 0; j < 4; j++)
                        {
                            if((data >> j) & 0x01)
                                data1 |= (1 << (j * 4));
                        }
                        setLatticeRgb(index, layer, getLatticeRgb(index, layer) & ~(0x1111 << i));
                        setLatticeRgb(index, layer, getLatticeRgb(index, layer) | (data1 << i));
                    }

                    if(getArgumentsLength() == 6)
                    {
                        for(i = 0; i < 16; i++)
                            setLatticeRgbIntensity(index, layer, i, 100);
                    }
                    else if(getArgumentsLength() == 22)
                    {
                        for(i = 0; i < 16; i++)
                        {
                            //setLatticeIntensity(index, i, getIntArgumentAtIndex(5 + i));
                            BYTE ii = (i - (i / 4) * 4) * 4 + (i / 4);
                            setLatticeRgbIntensity(index, layer, ii, getIntArgumentAtIndex(6 + i));
                        }
                    }
                    else
                    {
                        sendOSCMessage(sysPrefix, msgError, "ss", msgSetLatticeRgbAll, ": too_few_intensity_value");
                        return mrb_nil_value();
                    }

                    if(getLatticeRgb(index, layer) != 0)
                        setLatticeRgbOn(index, layer, TRUE);
                    else
                        setLatticeRgbOn(index, layer, FALSE);
                }
                else
                {
                    sendOSCMessage(sysPrefix, msgError, "ss", msgSetLatticeRgbAll, ": wrong_argument_type");
                    return mrb_nil_value();
                }
            }
            else if(compareOSCAddress(msgLatticeRgbClear))
            {
                if(getArgumentsLength() < 2)
                {
                    sendOSCMessage(sysPrefix, msgError, "ss", msgLatticeRgbClear, ": too_few_arguments");
                    return mrb_nil_value();
                }

                if((compareTypeTagAtIndex(0, 'i') || compareTypeTagAtIndex(0, 'f')) &&
                   (compareTypeTagAtIndex(1, 'i') || compareTypeTagAtIndex(1, 'f')))
                {
                    BYTE index = getIntArgumentAtIndex(0);
                    BYTE layer = getIntArgumentAtIndex(1);
                    setLatticeRgb(index, layer, 0);
                    setLatticeRgbOn(index, layer, FALSE);
                }
                else
                {
                    sendOSCMessage(sysPrefix, msgError, "ss", msgLatticeRgbClear, ": wrong_argument_type");
                    return mrb_nil_value();
                }
            }
            else if(compareOSCAddress(msgGetLatticeRgbIntensity))
            {
                if(getArgumentsLength() < 4)
                {
                    sendOSCMessage(sysPrefix, msgError, "ss", msgGetLatticeRgbIntensity, ": too_few_arguments");
                    return mrb_nil_value();
                }

                if((compareTypeTagAtIndex(0, 'i') || compareTypeTagAtIndex(0, 'f')) &&
                   (compareTypeTagAtIndex(1, 'i') || compareTypeTagAtIndex(1, 'f')) &&
                   (compareTypeTagAtIndex(2, 'i') || compareTypeTagAtIndex(2, 'f')) &&
                   (compareTypeTagAtIndex(3, 'i') || compareTypeTagAtIndex(3, 'f')))
                {
                    BYTE index = getIntArgumentAtIndex(0);
                    BYTE layer = getIntArgumentAtIndex(1);
                    BYTE x = getIntArgumentAtIndex(2);
                    BYTE y = getIntArgumentAtIndex(3);

                    if(x > 3 || y > 3)
                    {
                        sendOSCMessage(sysPrefix, msgError, "ss", msgGetLatticeRgbIntensity, ": out_of_range_value");
                        return mrb_nil_value();
                    }

                    sendOSCMessage(getOSCPrefix(), msgLatticeRgbIntensity, "iiii", index, x, y, getLatticeRgbIntensity(index, layer, y + (x * 4)));
                }
                else
                {
                    sendOSCMessage(sysPrefix, msgError, "ss", msgGetLatticeRgbIntensity, ": wrong_argument_type");
                    return mrb_nil_value();
                }
            }
            else if(compareOSCAddress(msgGetLatticeRgbIntensityAll))
            {
                if(getArgumentsLength() < 2)
                {
                    sendOSCMessage(sysPrefix, msgError, "ss", msgGetLatticeRgbIntensity, ": too_few_arguments");
                    return mrb_nil_value();
                }

                if((compareTypeTagAtIndex(0, 'i') || compareTypeTagAtIndex(0, 'f')) &&
                   (compareTypeTagAtIndex(1, 'i') || compareTypeTagAtIndex(1, 'f')))
                {
                    BYTE index = getIntArgumentAtIndex(0);
                    BYTE layer = getIntArgumentAtIndex(1);

                    sendOSCMessage(getOSCPrefix(), msgLatticeRgbIntensity, "iiiiiiiiiiiiiiiii", index,
                                   getLatticeRgbIntensity(index, layer, 0), getLatticeRgbIntensity(index, layer, 1),
                                   getLatticeRgbIntensity(index, layer, 2), getLatticeRgbIntensity(index, layer, 3),
                                   getLatticeRgbIntensity(index, layer, 4), getLatticeRgbIntensity(index, layer, 5),
                                   getLatticeRgbIntensity(index, layer, 6), getLatticeRgbIntensity(index, layer, 7),
                                   getLatticeRgbIntensity(index, layer, 8), getLatticeRgbIntensity(index, layer, 9),
                                   getLatticeRgbIntensity(index, layer, 10), getLatticeRgbIntensity(index, layer, 11),
                                   getLatticeRgbIntensity(index, layer, 12), getLatticeRgbIntensity(index, layer, 13),
                                   getLatticeRgbIntensity(index, layer, 14), getLatticeRgbIntensity(index, layer, 15));
                }
                else
                {
                    sendOSCMessage(sysPrefix, msgError, "ss", msgGetLatticeRgbIntensity, ": wrong_argument_type");
                    return mrb_nil_value();
                }
            }
#endif // #if defined(USE_LED_PAD)
#if defined(USE_LED_ENC)
            else if(compareOSCAddress(msgRotaryIncEncPinSelect))
            {
                if(getArgumentsLength() < 4)
                {
                    sendOSCMessage(sysPrefix, msgError, "ss", msgRotaryIncEncPinSelect, ": too_few_arguments");
                    return mrb_nil_value();
                }
                if((compareTypeTagAtIndex(0, 'i') || compareTypeTagAtIndex(0, 'f')) && compareTypeTagAtIndex(1, 's') && compareTypeTagAtIndex(2, 's') && compareTypeTagAtIndex(3, 's'))
                {
                    BYTE index = getIntArgumentAtIndex(0);
                    char* name_a = getStringArgumentAtIndex(1);
                    char* name_b = getStringArgumentAtIndex(2);
                    char* name_sw = getStringArgumentAtIndex(3);
                    
                    if(strlen(name_a) > 3 || strlen(name_b) > 3 || strlen(name_sw) > 3)
                    {
                        sendOSCMessage(sysPrefix, msgError, "ss", msgRotaryIncEncPinSelect, ": too_long_string_length");
                        return mrb_nil_value();
                    }

                    setIncEncoderPortAName(index, name_a);
                    setPortIOType(getIncEncoderPortAName(index), IO_IN);
                    setIncEncoderPortBName(index, name_b);
                    setPortIOType(getIncEncoderPortBName(index), IO_IN);
                    setIncEncoderPortSwName(index, name_sw);
                    setPortIOType(getIncEncoderPortSwName(index), IO_IN);

                    setInitIncEncFlag(TRUE);
                }
                else
                {
                    sendOSCMessage(sysPrefix, msgError, "ss", msgRotaryIncEncPinSelect, ": wrong_argument_type");
                    return mrb_nil_value();
                }
            }
            else if(compareOSCAddress(msgRotaryAbsEncPinSelect))
            {
                if(getArgumentsLength() < 3)
                {
                    sendOSCMessage(sysPrefix, msgError, "ss", msgRotaryAbsEncPinSelect, ": too_few_arguments");
                    return mrb_nil_value();
                }
                if(compareTypeTagAtIndex(0, 's') && compareTypeTagAtIndex(1, 's') && compareTypeTagAtIndex(2, 's'))
                {
                    char* name_cs = getStringArgumentAtIndex(0);
                    char* name_clk = getStringArgumentAtIndex(1);
                    char* name_do = getStringArgumentAtIndex(2);

                    if(strlen(name_cs) > 3 || strlen(name_clk) > 3 || strlen(name_do) > 3)
                    {
                        sendOSCMessage(sysPrefix, msgError, "ss", msgRotaryAbsEncPinSelect, ": too_long_string_length");
                        return mrb_nil_value();
                    }

                    setAbsEncoderPortCsName(name_cs);
                    setPortIOType(name_cs, IO_OUT);
                    setAbsEncoderPortClkName(name_clk);
                    setPortIOType(name_clk, IO_OUT);
                    setAbsEncoderPortDoName(name_do);
                    setPortIOType(name_do, IO_IN);

                    setInitAbsEncFlag(TRUE);
                }
                else
                {
                    sendOSCMessage(sysPrefix, msgError, "ss", msgRotaryAbsEncPinSelect, ": wrong_argument_type");
                    return mrb_nil_value();
                }
            }
            else if(compareOSCAddress(msgRotaryLedDrvPinSelect))
            {
                if(getArgumentsLength() < 2)
                {
                    sendOSCMessage(sysPrefix, msgError, "ss", msgRotaryLedDrvPinSelect, ": too_few_arguments");
                    return mrb_nil_value();
                }
                if((compareTypeTagAtIndex(0, 'i') || compareTypeTagAtIndex(0, 'f')) && compareTypeTagAtIndex(1, 's'))
                {
                    BYTE num = getIntArgumentAtIndex(0);
                    char* name_ss = getStringArgumentAtIndex(1);

                    if(strlen(name_ss) > 3)
                    {
                        sendOSCMessage(sysPrefix, msgError, "ss", msgRotaryLedDrvPinSelect, ": too_long_string_length");
                        return mrb_nil_value();
                    }

                    setLedDriverPortSsName(name_ss);
                    setPortIOType(name_ss, IO_OUT);
                    outputPort(name_ss, LOW);

                    switch(num)
                    {
                        case 2:
                            setLedDriverSpiNumber(2);
                            SpiChnClose(2);
                            SpiChnOpen(SPI_CHANNEL2, SPICON_MSTEN | SPICON_SMP | SPICON_MODE16 | SPICON_ON, 4);
                            setInitLedDrvFlag(TRUE);
                            break;
                        case 4:
                            setLedDriverSpiNumber(4);
                            SpiChnClose(4);
                            SpiChnOpen(SPI_CHANNEL4, SPICON_MSTEN | SPICON_SMP | SPICON_MODE16 | SPICON_ON, 4);
                            setInitLedDrvFlag(TRUE);
                            break;
                        default:
                            sendOSCMessage(sysPrefix, msgError, "ss", msgRotaryLedDrvPinSelect, ": out_of_range_value");
                            return mrb_nil_value();
                            break;
                    }
                }
                else
                {
                    sendOSCMessage(sysPrefix, msgError, "ss", msgRotaryLedDrvPinSelect, ": wrong_argument_type");
                    return mrb_nil_value();
                }
            }
            else if(compareOSCAddress(msgSetRotaryAbsEncConnectedNum))
            {
                if(compareTypeTagAtIndex(0, 'i') || compareTypeTagAtIndex(0, 'f'))
                {
                    int num = getIntArgumentAtIndex(0);
                    if(num < 1)
                    {
                        sendOSCMessage(sysPrefix, msgError, "ss", msgSetRotaryAbsEncConnectedNum, ": out_of_range_value");
                        return mrb_nil_value();
                    }
                    setNumConnectedAbsEnc(num);
                }
                else
                {
                    sendOSCMessage(sysPrefix, msgError, "ss", msgSetRotaryAbsEncConnectedNum, ": wrong_argument_type");
                    return mrb_nil_value();
                }
            }
            else if(compareOSCAddress(msgGetRotaryAbsEncConnectedNum))
            {
                sendOSCMessage(getOSCPrefix(), msgRotaryAbsEncConnectedNum, "i", getNumConnectedAbsEnc());
            }
            else if(compareOSCAddress(msgSetRotaryLedStep))
            {
                BYTE index;
                INT16 pos0, pos;
                if(getArgumentsLength() < 4)
                {
                    sendOSCMessage(sysPrefix, msgError, "ss", msgSetRotaryLedStep, ": too_few_arguments");
                    return mrb_nil_value();
                }

                if((compareTypeTagAtIndex(0, 'i') || compareTypeTagAtIndex(0, 'f')) && (compareTypeTagAtIndex(1, 'i') || compareTypeTagAtIndex(1, 'f')) || (compareTypeTagAtIndex(2, 'i') || compareTypeTagAtIndex(2, 'f')) || (compareTypeTagAtIndex(3, 'i') || compareTypeTagAtIndex(3, 'f')))
                {
                    index = getIntArgumentAtIndex(0);
                    pos0 = getIntArgumentAtIndex(1);
                    if(pos0 + 16 > 31)
                        pos = pos0 - 16;
                    else
                        pos = pos0 + 16;

                    INT8 direction = getIntArgumentAtIndex(2);
                    INT8 len = getIntArgumentAtIndex(3);
                    setDwLedData(index, 0);

                    INT8 argLen = getArgumentsLength() - 4;

                    if(argLen >= len)
                        argLen = len;

                    for(i = 0; i < argLen; i++)
                    {
                        //debug sendOSCMessage(TxSocket, getOSCPrefix(), "/debug1", "iiii", argLen, len, pos, i);
                        if(!compareTypeTagAtIndex(i, 'i') && !compareTypeTagAtIndex(i, 'f'))
                        {
                            sendOSCMessage(sysPrefix, msgError, "ss", msgSetRotaryLedStep, ": wrong_argument_type");
                            return mrb_nil_value();
                        }
                            
                        if(direction > 0)
                        {
                            if(pos + i < 32)
                                setIntensity(index, pos + i, getIntArgumentAtIndex(i + 4));
                            else
                                setIntensity(index, pos + i - 32, getIntArgumentAtIndex(i + 4));
                        }
                        else if(direction < 0)
                        {
                            if(pos >= i)
                                setIntensity(index, pos - i, getIntArgumentAtIndex(i + 4));
                            else
                                setIntensity(index, 32 + pos - i, getIntArgumentAtIndex(i + 4));
                        }
                    }

                    for(i = 0; i < len; i++)
                    {
                        if(direction > 0)
                        {
                            if(pos + i < 32)
                                setDwLedData(index, getDwLedData(index) | (1 << (pos + i)));
                            else
                                setDwLedData(index, getDwLedData(index) | (1 << (pos + i - 32)));
                        }
                        else if(direction < 0)
                        {
                            if(pos >= i)
                                setDwLedData(index, getDwLedData(index) | (1 << (pos - i)));
                            else
                                setDwLedData(index, getDwLedData(index) | (1 << (32 + pos - i)));
                        }
                    }

#if 0
                    for(j = 0; j < 100; j++)
                    {
                        setDwLedSequence(index, j, getDwLedData(index));

                        for(k = 0; k < 32; k++)
                        {
                            if(j >= getIntensity(index, k))
                                setDwLedSequence(index, j, getDwLedSequence(index, j) & ~(1 << k));
                        }
                    }
#endif

                    if(getDwLedData(index) != 0)
                        setLedOn(index, TRUE);
                    else
                        setLedOn(index, FALSE);
                }
                else
                {
                    sendOSCMessage(sysPrefix, msgError, "ss", msgSetRotaryLedStep, ": wrong_argument_type");
                    return mrb_nil_value();
                }
            }
            else if(compareOSCAddress(msgSetRotaryLedBits))
            {
                BYTE index;
                BYTE argLen = getArgumentsLength() - 2;
                DWORD data0, data1;

                if(getArgumentsLength() < 2)
                {
                    sendOSCMessage(sysPrefix, msgError, "ss", msgSetRotaryLedBits, ": too_few_arguments");
                    return mrb_nil_value();
                }

                if((compareTypeTagAtIndex(0, 'i') || compareTypeTagAtIndex(0, 'f')) && (compareTypeTagAtIndex(1, 'i') || compareTypeTagAtIndex(1, 'f')))
                {
                    index = getIntArgumentAtIndex(0);
                    data0 = getIntArgumentAtIndex(1);
                    data1 = ((data0 & 0x0000FFFF) << 16) + ((data0 >> 16) & 0x0000FFFF);
                    setDwLedData(index, data1);

                    if(argLen >= 32)
                    {
                        for(i = 0; i < 32; i++)
                        {
                            if(!compareTypeTagAtIndex(i, 'i') && !compareTypeTagAtIndex(i, 'f'))
                            {
                                sendOSCMessage(sysPrefix, msgError, "ss", msgSetRotaryLedBits, ": wrong_argument_type");
                                return mrb_nil_value();
                            }
                            //debug sendOSCMessage(TxSocket, getOSCPrefix(), "/debug0", "iiii", argLen, len, pos, i);
                            setIntensity(index, i, getIntArgumentAtIndex(i + 2));
                        }
                    }
                    else if(argLen < 32)
                    {
                        for(i = 0; i < argLen; i++)
                        {
                            if(!compareTypeTagAtIndex(i, 'i') && !compareTypeTagAtIndex(i, 'f'))
                            {
                                sendOSCMessage(sysPrefix, msgError, "ss", msgSetRotaryLedBits, ": wrong_argument_type");
                                return mrb_nil_value();
                            }
                            //debug sendOSCMessage(TxSocket, getOSCPrefix(), "/debug1", "iiii", argLen, len, pos, i);
                            setIntensity(index, i, getIntArgumentAtIndex(i + 2));
                        }
                    }

#if 0
                    for(j = 0; j < 100; j++)
                    {
                        setDwLedSequence(index, j, getDwLedData(index));

                        for(k = 0; k < 32; k++)
                        {
                            if(j >= getIntensity(index, k))
                                setDwLedSequence(index, j, getDwLedSequence(index, j) & ~(1 << k));
                        }
                    }
#endif

                    if(getDwLedData(index) != 0)
                        setLedOn(index, TRUE);
                    else
                        setLedOn(index, FALSE);
                }
                else
                {
                    sendOSCMessage(sysPrefix, msgError, "ss", msgSetRotaryLedBits, ": wrong_argument_type");
                    return mrb_nil_value();
                }
            }
            else if(compareOSCAddress(msgSetRotaryLedIntensity))
            {
                BYTE index, position, intensity;

                if(getArgumentsLength() < 3)
                {
                    sendOSCMessage(sysPrefix, msgError, "ss", msgSetRotaryLedIntensity, ": too_few_arguments");
                    return mrb_nil_value();
                }

                if((compareTypeTagAtIndex(0, 'i') || compareTypeTagAtIndex(0, 'f')) && (compareTypeTagAtIndex(1, 'i') || compareTypeTagAtIndex(1, 'f')) && (compareTypeTagAtIndex(2, 'i') || compareTypeTagAtIndex(2, 'f')))
                {
                    index = getIntArgumentAtIndex(0);
                    if(getInitAbsEncFlag() && index >= getNumConnectedAbsEnc())
                    {
                        sendOSCMessage(sysPrefix, msgError, "ss", msgSetRotaryLedIntensity, ": out_of_range_value");
                        return mrb_nil_value();
                    }

                    position = getIntArgumentAtIndex(1) + 16;
                    if(position > 31)
                        position -= 32;
                    if(position > 31)
                    {
                        sendOSCMessage(sysPrefix, msgError, "ss", msgSetRotaryLedIntensity, ": out_of_range_value");
                        return mrb_nil_value();
                    }

                    intensity = getIntArgumentAtIndex(2);
                    setIntensity(index, position, intensity);
                    if(intensity > 100)
                    {
                        sendOSCMessage(sysPrefix, msgError, "ss", msgSetRotaryLedIntensity, ": out_of_range_value");
                        return mrb_nil_value();
                    }

#if 0
                    for(j = 0; j < 100; j++)
                    {
                        setDwLedSequence(index, j, getDwLedData(index));
                        for(k = 0; k < 32; k++)
                        {
                            if(k == position)
                                setIntensity(index, k, intensity);
                            if(j >= getIntensity(index, k))
                            //if(j >= getIntensity(index, position))
                                setDwLedSequence(index, j, getDwLedSequence(index, j) & ~(1 << k));
                                //setDwLedSequence(index, j, getDwLedSequence(index, j) & ~(1 << position));
                        }
                    }
#endif
                }
                else
                {
                    sendOSCMessage(sysPrefix, msgError, "ss", msgSetRotaryLedBits, ": wrong_argument_type");
                    return mrb_nil_value();
                }
            }
            else if(compareOSCAddress(msgGetRotaryLedIntensity))
            {
                BYTE index, position0, position1, intensity;

                if(getArgumentsLength() < 2)
                {
                    sendOSCMessage(sysPrefix, msgError, "ss", msgGetRotaryLedIntensity, ": too_few_arguments");
                    return mrb_nil_value();
                }

                if((compareTypeTagAtIndex(0, 'i') || compareTypeTagAtIndex(0, 'f')) && (compareTypeTagAtIndex(1, 'i') || compareTypeTagAtIndex(1, 'f')))
                {
                    index = getIntArgumentAtIndex(0);
                    if(getInitAbsEncFlag() && index >= getNumConnectedAbsEnc())
                    {
                        sendOSCMessage(sysPrefix, msgError, "ss", msgGetRotaryLedIntensity, ": out_of_range_value");
                        return mrb_nil_value();
                    }

                    position0 = getIntArgumentAtIndex(1);
                    position1 = position0 + 16;
                    if(position1 > 31)
                        position1 -= 32;
                    
                    if(position1 > 31)
                    {
                        sendOSCMessage(sysPrefix, msgError, "ss", msgSetRotaryLedIntensity, ": out_of_range_value");
                        return mrb_nil_value();
                    }

                    intensity = getIntensity(index, position1);

                    sendOSCMessage(getOSCPrefix(), msgRotaryLedIntensity, "iii", index, position0, intensity);
                }
                else
                {
                    sendOSCMessage(sysPrefix, msgError, "ss", msgGetRotaryLedIntensity, ": wrong_argument_type");
                    return mrb_nil_value();
                }
            }
            else if(compareOSCAddress(msgSetRotaryLedIntensityAll))
            {
                BYTE index;
                DWORD all_intensity;

                if(getArgumentsLength() < 2)
                {
                    sendOSCMessage(sysPrefix, msgError, "ss", msgSetRotaryLedIntensityAll, ": too_few_arguments");
                    return mrb_nil_value();
                }

                if((compareTypeTagAtIndex(0, 'i') || compareTypeTagAtIndex(0, 'f')) && (compareTypeTagAtIndex(1, 'i') || compareTypeTagAtIndex(1, 'f')))
                {
                    index = getIntArgumentAtIndex(0);
                    all_intensity = getIntArgumentAtIndex(1);

#if 0
                    for(j = 0; j < 100; j++)
                    {
                        setDwLedSequence(index, j, getDwLedData(index));
                        for(k = 0; k < 32; k++)
                        {
                            setIntensity(index, k, all_intensity);
                            if(j >= getIntensity(index, k))
                                setDwLedSequence(index, j, getDwLedSequence(index, j) & ~(1 << k));
                        }
                    }
#else
                    for(k = 0; k < 32; k++)
                        setIntensity(index, k, all_intensity);
#endif
                }
                else
                {
                    sendOSCMessage(sysPrefix, msgError, "ss", msgSetRotaryLedIntensityAll, ": wrong_argument_type");
                    return mrb_nil_value();
                }
            }
#endif // #if defined(USE_LED_ENC)
        }
        //debug LED_2_Off();
    }
    return mrb_nil_value();
}
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
