yamamo2shun1/PICrouter/tkrworks-libs/Common/iosetting.c

/*
 * Copylight (C) 2012, Shunichi Yamamoto, tkrworks.net
 *
 * This file is part of PICrouter.
 *
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
  * iosetting.c,v.1.0.0 2014/06/17
 */

#include "iosetting.h"

BYTE ioAnPort[14] = {0};
BYTE ioPwmPort[4] = {0};
BYTE ioDPort[4] = {0};
BYTE ioSpiPort[6] = {0};

/*******************************************************************************
  Function:
    void setPortIOType(char* port_name, BYTE io)

  Precondition:


  Summary:


  Description:


  Parameters:
    char* port_name
    BYTE io

  Return Values:
    None

  Remarks:
    None
*******************************************************************************/
void setPortIOType(char* port_name, BYTE io)
{
    if(!strcmp(port_name, "b0"))
        setAnPortDioType(0, io);
    else if(!strcmp(port_name, "b1"))
        setAnPortDioType(1, io);
    else if(!strcmp(port_name, "b2"))
        setAnPortDioType(2, io);
    else if(!strcmp(port_name, "b3"))
        setAnPortDioType(3, io);
    else if(!strcmp(port_name, "b4"))
        setAnPortDioType(4, io);
    else if(!strcmp(port_name, "b5"))
        setAnPortDioType(5, io);
    else if(!strcmp(port_name, "b6"))
        setAnPortDioType(6, io);
    else if(!strcmp(port_name, "b7"))
        setAnPortDioType(7, io);
    else if(!strcmp(port_name, "b8"))
        setAnPortDioType(8, io);
    else if(!strcmp(port_name, "b9"))
        setAnPortDioType(9, io);
    else if(!strcmp(port_name, "b10"))
        setAnPortDioType(10, io);
    else if(!strcmp(port_name, "b11"))
        setAnPortDioType(11, io);
    else if(!strcmp(port_name, "b12"))
        setAnPortDioType(12, io);
    else if(!strcmp(port_name, "b13"))
        setAnPortDioType(13, io);
    else if(!strcmp(port_name, "d0"))
        setPwmPortDioType(0, io);
    else if(!strcmp(port_name, "d2"))
        setPwmPortDioType(1, io);
    else if(!strcmp(port_name, "d3"))
        setPwmPortDioType(2, io);
    else if(!strcmp(port_name, "d4"))
        setPwmPortDioType(3, io);
    else if(!strcmp(port_name, "c13"))
        setDigitalPortDioType(0, io);
    else if(!strcmp(port_name, "c14"))
        setDigitalPortDioType(1, io);
    else if(!strcmp(port_name, "f0"))
        setDigitalPortDioType(2, io);
    else if(!strcmp(port_name, "f1"))
        setDigitalPortDioType(3, io);
    else if(!strcmp(port_name, "b14"))
        setSpiPortDioType("sck4", io);
    else if(!strcmp(port_name, "f4"))
        setSpiPortDioType("sdi4", io);
    else if(!strcmp(port_name, "f5"))
        setSpiPortDioType("sdo4", io);
    else if(!strcmp(port_name, "g6"))
        setSpiPortDioType("sck2", io);
    else if(!strcmp(port_name, "g7"))
        setSpiPortDioType("sdi2", io);
    else if(!strcmp(port_name, "g8"))
        setSpiPortDioType("sdo2", io);
}

/*******************************************************************************
  Function:
    BYTE getPortIOType(char* port_name)

  Precondition:


  Summary:


  Description:


  Parameters:
    char* port_name

  Return Values:


  Remarks:
    None
*******************************************************************************/
BYTE getPortIOType(char* port_name)
{
    if(!strcmp(port_name, "b0"))
        return getAnPortDioType(0);
    else if(!strcmp(port_name, "b1"))
        return getAnPortDioType(1);
    else if(!strcmp(port_name, "b2"))
        return getAnPortDioType(2);
    else if(!strcmp(port_name, "b3"))
        return getAnPortDioType(3);
    else if(!strcmp(port_name, "b4"))
        return getAnPortDioType(4);
    else if(!strcmp(port_name, "b5"))
        return getAnPortDioType(5);
    else if(!strcmp(port_name, "b6"))
        return getAnPortDioType(6);
    else if(!strcmp(port_name, "b7"))
        return getAnPortDioType(7);
    else if(!strcmp(port_name, "b8"))
        return getAnPortDioType(8);
    else if(!strcmp(port_name, "b9"))
        return getAnPortDioType(9);
    else if(!strcmp(port_name, "b10"))
        return getAnPortDioType(10);
    else if(!strcmp(port_name, "b11"))
        return getAnPortDioType(11);
    else if(!strcmp(port_name, "b12"))
        return getAnPortDioType(12);
    else if(!strcmp(port_name, "b13"))
        return getAnPortDioType(13);
    else if(!strcmp(port_name, "d0"))
        return getPwmPortDioType(0);
    else if(!strcmp(port_name, "d2"))
        return getPwmPortDioType(1);
    else if(!strcmp(port_name, "d3"))
        return getPwmPortDioType(2);
    else if(!strcmp(port_name, "d4"))
        return getPwmPortDioType(3);
    else if(!strcmp(port_name, "c13"))
        return getDigitalPortDioType(0);
    else if(!strcmp(port_name, "c14"))
        return getDigitalPortDioType(1);
    else if(!strcmp(port_name, "f0"))
        return getDigitalPortDioType(2);
    else if(!strcmp(port_name, "f1"))
        return getDigitalPortDioType(3);
    else if(!strcmp(port_name, "b14"))
        return getSpiPortDioType("sck4");
    else if(!strcmp(port_name, "f4"))
        return getSpiPortDioType("sdi4");
    else if(!strcmp(port_name, "f5"))
        return getSpiPortDioType("sdo4");
    else if(!strcmp(port_name, "g6"))
        return getSpiPortDioType("sck2");
    else if(!strcmp(port_name, "g7"))
        return getSpiPortDioType("sdi2");
    else if(!strcmp(port_name, "g8"))
        return getSpiPortDioType("sdo2");
}

/*******************************************************************************
  Function:
    void outputPort(char* port_name, BYTE state)

  Precondition:


  Summary:


  Description:


  Parameters:
    char* port_name
    BYTE state

  Return Values:
    None

  Remarks:
    None
*******************************************************************************/
void outputPort(char* port_name, BYTE state)
{
    if(!strcmp(port_name, "b0"))
        outputAnPort(0, state);
    else if(!strcmp(port_name, "b1"))
        outputAnPort(1, state);
    else if(!strcmp(port_name, "b2"))
        outputAnPort(2, state);
    else if(!strcmp(port_name, "b3"))
        outputAnPort(3, state);
    else if(!strcmp(port_name, "b4"))
        outputAnPort(4, state);
    else if(!strcmp(port_name, "b5"))
        outputAnPort(5, state);
    else if(!strcmp(port_name, "b6"))
        outputAnPort(6, state);
    else if(!strcmp(port_name, "b7"))
        outputAnPort(7, state);
    else if(!strcmp(port_name, "b8"))
        outputAnPort(8, state);
    else if(!strcmp(port_name, "b9"))
        outputAnPort(9, state);
    else if(!strcmp(port_name, "b10"))
        outputAnPort(10, state);
    else if(!strcmp(port_name, "b11"))
        outputAnPort(11, state);
    else if(!strcmp(port_name, "b12"))
        outputAnPort(12, state);
    else if(!strcmp(port_name, "b13"))
        outputAnPort(13, state);
    else if(!strcmp(port_name, "d0"))
        outputPwmPort(0, state);
    else if(!strcmp(port_name, "d2"))
        outputPwmPort(1, state);
    else if(!strcmp(port_name, "d3"))
        outputPwmPort(2, state);
    else if(!strcmp(port_name, "d4"))
        outputPwmPort(3, state);
    else if(!strcmp(port_name, "c13"))
        outputDigitalPort(0, state);
    else if(!strcmp(port_name, "c14"))
        outputDigitalPort(1, state);
    else if(!strcmp(port_name, "f0"))
        outputDigitalPort(2, state);
    else if(!strcmp(port_name, "f1"))
        outputDigitalPort(3, state);
    else if(!strcmp(port_name, "b14"))
        outputSpiPort("sck4", state);
    else if(!strcmp(port_name, "f4"))
        outputSpiPort("sdi4", state);
    else if(!strcmp(port_name, "f5"))
        outputSpiPort("sdo4", state);
    else if(!strcmp(port_name, "g6"))
        outputSpiPort("sck2", state);
    else if(!strcmp(port_name, "g7"))
        outputSpiPort("sdi2", state);
    else if(!strcmp(port_name, "g8"))
        outputSpiPort("sdo2", state);
}

/*******************************************************************************
  Function:
    BYTE inputPort(char* port_name)

  Precondition:


  Summary:


  Description:


  Parameters:
    char* port_name

  Return Values:


  Remarks:
    None
*******************************************************************************/
BYTE inputPort(char* port_name)
{
    if(!strcmp(port_name, "b0"))
        return inputAnPort(0);
    else if(!strcmp(port_name, "b1"))
        return inputAnPort(1);
    else if(!strcmp(port_name, "b2"))
        return inputAnPort(2);
    else if(!strcmp(port_name, "b3"))
        return inputAnPort(3);
    else if(!strcmp(port_name, "b4"))
        return inputAnPort(4);
    else if(!strcmp(port_name, "b5"))
        return inputAnPort(5);
    else if(!strcmp(port_name, "b6"))
        return inputAnPort(6);
    else if(!strcmp(port_name, "b7"))
        return inputAnPort(7);
    else if(!strcmp(port_name, "b8"))
        return inputAnPort(8);
    else if(!strcmp(port_name, "b9"))
        return inputAnPort(9);
    else if(!strcmp(port_name, "b10"))
        return inputAnPort(10);
    else if(!strcmp(port_name, "b11"))
        return inputAnPort(11);
    else if(!strcmp(port_name, "b12"))
        return inputAnPort(12);
    else if(!strcmp(port_name, "b13"))
        return inputAnPort(13);
    else if(!strcmp(port_name, "d0"))
        return inputPwmPort(0);
    else if(!strcmp(port_name, "d2"))
        return inputPwmPort(1);
    else if(!strcmp(port_name, "d3"))
        return inputPwmPort(2);
    else if(!strcmp(port_name, "d4"))
        return inputPwmPort(3);
    else if(!strcmp(port_name, "c13"))
        return inputDigitalPort(0);
    else if(!strcmp(port_name, "c14"))
        return inputDigitalPort(1);
    else if(!strcmp(port_name, "f0"))
        return inputDigitalPort(2);
    else if(!strcmp(port_name, "f1"))
        return inputDigitalPort(3);
    else if(!strcmp(port_name, "b14"))
        return inputSpiPort("sck4");
    else if(!strcmp(port_name, "f4"))
        return inputSpiPort("sdi4");
    else if(!strcmp(port_name, "f5"))
        return inputSpiPort("sdo4");
    else if(!strcmp(port_name, "g6"))
        return inputSpiPort("sck2");
    else if(!strcmp(port_name, "g7"))
        return inputSpiPort("sdi2");
    else if(!strcmp(port_name, "g8"))
        return inputSpiPort("sdo2");
    else
        return 0;
}

/*******************************************************************************
  Function:
    BOOL comparePortNameAtIndex(char* port_name)

  Precondition:


  Summary:


  Description:


  Parameters:
    char* port_name

  Return Values:


  Remarks:
    None
*******************************************************************************/
BOOL comparePortNameAtIndex(char* port_name)
{
    if(!strcmp(port_name, "b0"))
        return TRUE;
    else if(!strcmp(port_name, "b1"))
        return TRUE;
    else if(!strcmp(port_name, "b2"))
        return TRUE;
    else if(!strcmp(port_name, "b3"))
        return TRUE;
    else if(!strcmp(port_name, "b4"))
        return TRUE;
    else if(!strcmp(port_name, "b5"))
        return TRUE;
    else if(!strcmp(port_name, "b6"))
        return TRUE;
    else if(!strcmp(port_name, "b7"))
        return TRUE;
    else if(!strcmp(port_name, "b8"))
        return TRUE;
    else if(!strcmp(port_name, "b9"))
        return TRUE;
    else if(!strcmp(port_name, "b10"))
        return TRUE;
    else if(!strcmp(port_name, "b11"))
        return TRUE;
    else if(!strcmp(port_name, "b12"))
        return TRUE;
    else if(!strcmp(port_name, "b13"))
        return TRUE;
    else if(!strcmp(port_name, "d0"))
        return TRUE;
    else if(!strcmp(port_name, "d2"))
        return TRUE;
    else if(!strcmp(port_name, "d3"))
        return TRUE;
    else if(!strcmp(port_name, "d4"))
        return TRUE;
    else if(!strcmp(port_name, "c13"))
        return TRUE;
    else if(!strcmp(port_name, "c14"))
        return TRUE;
    else if(!strcmp(port_name, "f0"))
        return TRUE;
    else if(!strcmp(port_name, "f1"))
        return TRUE;
    else if(!strcmp(port_name, "b14"))
        return TRUE;
    else if(!strcmp(port_name, "f4"))
        return TRUE;
    else if(!strcmp(port_name, "f5"))
        return TRUE;
    else if(!strcmp(port_name, "g6"))
        return TRUE;
    else if(!strcmp(port_name, "g7"))
        return TRUE;
    else if(!strcmp(port_name, "g8"))
        return TRUE;
    else
        return FALSE;
}

/*******************************************************************************
  Function:
    void setAnPortDioType(BYTE id, BYTE io)

  Precondition:


  Summary:


  Description:


  Parameters:
    BYTE id
    BYTE io

  Return Values:
    None

  Remarks:
    None
*******************************************************************************/
void setAnPortDioType(BYTE id, BYTE io)
{
    ioAnPort[id] = io;
    switch(id)
    {
        case 0:
            TRISBbits.TRISB0  = io;
            break;
        case 1:
            TRISBbits.TRISB1  = io;
            break;
        case 2:
            TRISBbits.TRISB2  = io;
            break;
        case 3:
            TRISBbits.TRISB3  = io;
            break;
        case 4:
            TRISBbits.TRISB4  = io;
            break;
        case 5:
            TRISBbits.TRISB5  = io;
            break;
        case 6:
            TRISBbits.TRISB6  = io;
            break;
        case 7:
            TRISBbits.TRISB7  = io;
            break;
        case 8:
            TRISBbits.TRISB8  = io;
            break;
        case 9:
            TRISBbits.TRISB9  = io;
            break;
        case 10:
            TRISBbits.TRISB10 = io;
            break;
        case 11:
            TRISBbits.TRISB11 = io;
            break;
        case 12:
            TRISBbits.TRISB12 = io;
            break;
        case 13:
            TRISBbits.TRISB13 = io;
            break;
    }
}

/*******************************************************************************
  Function:
    BYTE getAnPortDioType(BYTE id)

  Precondition:


  Summary:


  Description:


  Parameters:
    BYTE id

  Return Values:


  Remarks:
    None
*******************************************************************************/
BYTE getAnPortDioType(BYTE id)
{
    return ioAnPort[id];
}

/*******************************************************************************
  Function:
 void outputAnPort(BYTE id, BYTE state)

  Precondition:


  Summary:


  Description:


  Parameters:
    BYTE id
    BYTE state

  Return Values:
    None

  Remarks:
    None
*******************************************************************************/
void outputAnPort(BYTE id, BYTE state)
{
    switch(id)
    {
        case 0:
            LATBbits.LATB0  = state;
            break;
        case 1:
            LATBbits.LATB1  = state;
            break;
        case 2:
            LATBbits.LATB2  = state;
            break;
        case 3:
            LATBbits.LATB3  = state;
            break;
        case 4:
            LATBbits.LATB4  = state;
            break;
        case 5:
            LATBbits.LATB5  = state;
            break;
        case 6:
            LATBbits.LATB6  = state;
            break;
        case 7:
            LATBbits.LATB7  = state;
            break;
        case 8:
            LATBbits.LATB8  = state;
            break;
        case 9:
            LATBbits.LATB9  = state;
            break;
        case 10:
            LATBbits.LATB10 = state;
            break;
        case 11:
            LATBbits.LATB11 = state;
            break;
        case 12:
            LATBbits.LATB12 = state;
            break;
        case 13:
            LATBbits.LATB13 = state;
            break;
    }
}

/*******************************************************************************
  Function:
    BYTE inputAnPort(BYTE id)

  Precondition:


  Summary:


  Description:


  Parameters:
    BYTE id

  Return Values:


  Remarks:
    None
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
    }
    return state;
}

/*******************************************************************************
  Function:
    void setDigitalPortDioType(BYTE id, BYTE io)

  Precondition:


  Summary:


  Description:


  Parameters:
    BYTE id
    BYTE io

  Return Values:
    None

  Remarks:
    None
*******************************************************************************/
void setDigitalPortDioType(BYTE id, BYTE io)
{
    ioDPort[id] = io;
    switch(id)
    {
        case 0:
            TRISCbits.TRISC13 = io;
            break;
        case 1:
            TRISCbits.TRISC14 = io;
            break;
        case 2:
            TRISFbits.TRISF0  = io;
            break;
        case 3:
            TRISFbits.TRISF1  = io;
            break;
    }
}

/*******************************************************************************
  Function:
    BYTE getDigitalPortDioType(BYTE id)

  Precondition:


  Summary:


  Description:


  Parameters:
    BYTE id

  Return Values:


  Remarks:
    None
*******************************************************************************/
BYTE getDigitalPortDioType(BYTE id)
{
    return ioDPort[id];
}

/*******************************************************************************
  Function:
    void outputDigitalPort(BYTE id, BYTE state)

  Precondition:


  Summary:


  Description:


  Parameters:
    BYTE id
    BYTE stat

  Return Values:
    None

  Remarks:
    None
*******************************************************************************/
void outputDigitalPort(BYTE id, BYTE state)
{
    switch(id)
    {
        case 0:
            LATCbits.LATC13 = state;
            break;
        case 1:
            LATCbits.LATC14 = state;
            break;
        case 2:
            LATFbits.LATF0  = state;
            break;
        case 3:
            LATFbits.LATF1  = state;
            break;
    }
}

/*******************************************************************************
  Function:
    BYTE inputDigitalPort(BYTE id)

  Precondition:


  Summary:


  Description:


  Parameters:
    BYTE id

  Return Values:


  Remarks:
    None
*******************************************************************************/
BYTE inputDigitalPort(BYTE id)
{
    BYTE state = LOW;
    switch(id)
    {
        case 0:
            state = PORTCbits.RC13;
            break;
        case 1:
            state = PORTCbits.RC14;
            break;
        case 2:
            state = PORTFbits.RF0;
            break;
        case 3:
            state = PORTFbits.RF1;
            break;
    }
    return state;
}

/*******************************************************************************
  Function:
    void setSpiPortDioType(char* name, BYTE io)

  Precondition:


  Summary:


  Description:


  Parameters:
    char* name
    BYTE io

  Return Values:
    None

  Remarks:
    None
*******************************************************************************/
void setSpiPortDioType(char* name, BYTE io)
{
    if(!strcmp(name, "sck4"))
    {
        ioSpiPort[0] = io;
        TRISBbits.TRISB14 = io;
    }
    else if(!strcmp(name, "sdi4"))
    {
        ioSpiPort[1] = io;
        TRISFbits.TRISF4  = io;
    }
    else if(!strcmp(name, "sdo4"))
    {
        ioSpiPort[2] = io;
        TRISFbits.TRISF5  = io;
    }
    else if(!strcmp(name, "sck2"))
    {
        ioSpiPort[3] = io;
        TRISGbits.TRISG6 = io;
    }
    else if(!strcmp(name, "sdi2"))
    {
        ioSpiPort[4] = io;
        TRISGbits.TRISG7 = io;
    }
    else if(!strcmp(name, "sdo2"))
    {
        ioSpiPort[5] = io;
        TRISGbits.TRISG8 = io;
    }
}

/*******************************************************************************
  Function:
    BYTE getSpiPortDioType(char* name)

  Precondition:


  Summary:


  Description:


  Parameters:
    char* name

  Return Values:


  Remarks:
    None
*******************************************************************************/
BYTE getSpiPortDioType(char* name)
{
    if(!strcmp(name, "sck4"))
        return ioSpiPort[0];
    else if(!strcmp(name, "sdi4"))
        return ioSpiPort[1];
    else if(!strcmp(name, "sdo4"))
        return ioSpiPort[2];
    else if(!strcmp(name, "sck2"))
        return ioSpiPort[3];
    else if(!strcmp(name, "sdi2"))
        return ioSpiPort[4];
    else if(!strcmp(name, "sdo2"))
        return ioSpiPort[5];
}

/*******************************************************************************
  Function:
    void outputSpiPort(char* name, BYTE state)

  Precondition:


  Summary:


  Description:


  Parameters:
    char* name
    BYTE state

  Return Values:
    None

  Remarks:
    None
*******************************************************************************/
void outputSpiPort(char* name, BYTE state)
{
    if(!strcmp(name, "sck4"))
        LATBbits.LATB14 = state;
    else if(!strcmp(name, "sdi4"))
        LATFbits.LATF4  = state;
    else if(!strcmp(name, "sdo4"))
        LATFbits.LATF5  = state;
    else if(!strcmp(name, "sck2"))
        LATGbits.LATG6 = state;
    else if(!strcmp(name, "sdi2"))
        LATGbits.LATG7 = state;
    else if(!strcmp(name, "sdo2"))
        LATGbits.LATG8 = state;
}

/*******************************************************************************
  Function:
    BYTE inputSpiPort(char* name)

  Precondition:


  Summary:


  Description:


  Parameters:
    char* name

  Return Values:


  Remarks:
    None
*******************************************************************************/
BYTE inputSpiPort(char* name)
{
    BYTE state = LOW;
    if(!strcmp(name, "sck4"))
        state = PORTBbits.RB14;
    else if(!strcmp(name, "sdi4"))
        state = PORTFbits.RF4;
    else if(!strcmp(name, "sdo4"))
        state = PORTFbits.RF5;
    else if(!strcmp(name, "sck2"))
        state = PORTGbits.RG6;
    else if(!strcmp(name, "sdi2"))
        state = PORTGbits.RG7;
    else if(!strcmp(name, "sdo2"))
        state = PORTGbits.RG8;
    return state;
}

/*******************************************************************************
  Function:
    void sendSpiOneWord(BYTE spi_id, WORD msb, DWORD usec)

  Precondition:


  Summary:


  Description:


  Parameters:
    BYTE spi_id
    WORD msb
    DWORD usec

  Return Values:
    None

  Remarks:
    None
*******************************************************************************/
void sendSpiOneWord(BYTE spi_id, WORD msb, DWORD usec)
{
    switch(spi_id)
    {
        case SPI_2:
            putcSPI2(msb);
            break;
        case SPI_4:
            putcSPI4(msb);
            break;
    }
    Nop();
    //Delay10us(usec);
}

/*******************************************************************************
  Function:
    void sendSpiTwoWord(BYTE spi_id, WORD msb, WORD lsb, DWORD usec)

  Precondition:


  Summary:


  Description:


  Parameters:
    BYTE spi_id
    WORD msb
    WORD lsb
    DWORD usec

  Return Values:
    None

  Remarks:
    None
*******************************************************************************/
void sendSpiTwoWord(BYTE spi_id, WORD msb, WORD lsb, DWORD usec)
{
    switch(spi_id)
    {
        case SPI_2:
            putcSPI2(lsb);
            putcSPI2(msb);
            break;
        case SPI_4:
            putcSPI4(lsb);
            putcSPI4(msb);
            break;
    }
    Nop();
    //Delay10us(usec);
}

/*******************************************************************************
  Function:
    void sendSpiThreeWord(BYTE spi_id, WORD msb0, WORD lsb0, WORD msb1, DWORD usec)

  Precondition:


  Summary:


  Description:


  Parameters:
    BYTE spi_id
    WORD msb0
    WORD lsb0
    WORD msb1
    DWORD usec

  Return Values:
    None

  Remarks:
    None
*******************************************************************************/
void sendSpiThreeWord(BYTE spi_id, WORD msb0, WORD lsb0, WORD msb1, DWORD usec)
{
    switch(spi_id)
    {
        case SPI_2:
            putcSPI2(msb1);
            putcSPI2(lsb0);
            putcSPI2(msb0);
            break;
        case SPI_4:
            putcSPI4(msb1);
            putcSPI4(lsb0);
            putcSPI4(msb0);
            break;
    }
    Nop();
}

/*******************************************************************************
  Function:
    void sendSpiFourWord(BYTE spi_id, WORD msb0, WORD lsb0, WORD msb1, WORD lsb1, DWORD usec)

  Precondition:


  Summary:


  Description:


  Parameters:
    BYTE spi_id
    WORD msb0
    WORD lsb0
    WORD msb1
    WORD lsb1
    DWORD usec

  Return Values:
    None

  Remarks:
    None
*******************************************************************************/
void sendSpiFourWord(BYTE spi_id, WORD msb0, WORD lsb0, WORD msb1, WORD lsb1, DWORD usec)
{
    switch(spi_id)
    {
        case SPI_2:
            putcSPI2(lsb1);
            putcSPI2(msb1);
            putcSPI2(lsb0);
            putcSPI2(msb0);
            break;
        case SPI_4:
            putcSPI4(lsb1);
            putcSPI4(msb1);
            putcSPI4(lsb0);
            putcSPI4(msb0);
            break;
    }
    Nop();
}

/*******************************************************************************
  Function:
    WORD receiveSpiOneWord(BYTE spi_id, DWORD usec)

  Precondition:


  Summary:


  Description:


  Parameters:
    BYTE spi_id
    DWORD use

  Return Values:


  Remarks:
    None
*******************************************************************************/
WORD receiveSpiOneWord(BYTE spi_id, DWORD usec)
{
    WORD data = 0;

    switch(spi_id)
    {
        case SPI_2:
            data = getcSPI2();
            break;
        case SPI_4:
            data = getcSPI4();
            break;
    }

    return data;
}

/*******************************************************************************
  Function:
    unsigned int getcSPI4(void)

  Precondition:


  Summary:


  Description:


  Parameters:
    None

  Return Values:


  Remarks:
    None
*******************************************************************************/
unsigned int getcSPI4(void)
{
    while(!DataRdySPI4());
    return ReadSPI4();
}

/*******************************************************************************
  Function:
    void idleI2C(BYTE i2c_id)

  Precondition:


  Summary:


  Description:


  Parameters:
    BYTE i2c_id

  Return Values:
    None

  Remarks:
    None
*******************************************************************************/
void idleI2C(BYTE i2c_id)
{
    switch(i2c_id)
    {
        case I2C_3:
            while(I2C3CONbits.SEN || I2C3CONbits.PEN || I2C3CONbits.RCEN || I2C3CONbits.ACKEN || I2C3STATbits.TRSTAT);
            break;
        case I2C_4:
            while(I2C4CONbits.SEN || I2C4CONbits.PEN || I2C4CONbits.RCEN || I2C4CONbits.ACKEN || I2C4STATbits.TRSTAT);
            break;
        case I2C_5:
            while(I2C5CONbits.SEN || I2C5CONbits.PEN || I2C5CONbits.RCEN || I2C5CONbits.ACKEN || I2C5STATbits.TRSTAT);
            break;
    }
}

/*******************************************************************************
  Function:
    BOOL startI2C(BYTE i2c_id)

  Precondition:


  Summary:


  Description:


  Parameters:
    BYTE i2c_id

  Return Values:


  Remarks:
    None
*******************************************************************************/
BOOL startI2C(BYTE i2c_id)
{
    BYTE test = 0;
    BOOL errflag = FALSE;

    switch(i2c_id)
    {
        case I2C_3:
            I2C3CONSET = _I2C3CON_SEN_MASK;
            if(I2C3STATbits.BCL)
                errflag = FALSE;
            else
                errflag = TRUE;
            break;
        case I2C_4:
            I2C4CONSET = _I2C4CON_SEN_MASK;
            if(I2C4STATbits.BCL)
                errflag = FALSE;
            else
                errflag = TRUE;
            break;
        case I2C_5:
            I2C5CONSET = _I2C5CON_SEN_MASK;
            if(I2C5STATbits.BCL)
                errflag = FALSE;
            else
                errflag = TRUE;
            test = 1;
            break;
    }
    return errflag;
}

/*******************************************************************************
  Function:
    void setAddressToI2C(BYTE i2c_id, BYTE data, char chflag)

  Precondition:


  Summary:


  Description:


  Parameters:
    BYTE i2c_id
    BYTE data
    char chflag

  Return Values:
    None

  Remarks:
    None
*******************************************************************************/
void setAddressToI2C(BYTE i2c_id, BYTE data, char chflag)
{
    if(chflag == 'r')
        data |= 0x01;
    else if(chflag == 'w')
        data |= 0x00;
    else
        return;

    switch(i2c_id)
    {
        case I2C_3:
            I2C3TRN = data;
            break;
        case I2C_4:
            I2C4TRN = data;
            break;
        case I2C_5:
            I2C5TRN = data;
            break;
    }
}

/*******************************************************************************
  Function:
    void setDataToI2C(BYTE i2c_id, BYTE data)

  Precondition:


  Summary:


  Description:


  Parameters:
    BYTE i2c_id
    BYTE data

  Return Values:
    None

  Remarks:
    None
*******************************************************************************/
void setDataToI2C(BYTE i2c_id, BYTE data)
{
    switch(i2c_id)
    {
        case I2C_3:
            I2C3TRN = data;
            break;
        case I2C_4:
            I2C4TRN = data;
            break;
        case I2C_5:
            I2C5TRN = data;
            break;
    }
}

/*******************************************************************************
  Function:
    BOOL checkAckI2C(BYTE i2c_id)

  Precondition:


  Summary:


  Description:


  Parameters:
    BYTE i2c_id

  Return Values:


  Remarks:
    None
*******************************************************************************/
BOOL checkAckI2C(BYTE i2c_id)
{
    BOOL ackflag;

    switch(i2c_id)
    {
        case I2C_3:
            if(I2C3STATbits.ACKSTAT)
                ackflag = FALSE;
            else
                ackflag = TRUE;
            break;
        case I2C_4:
            if(I2C4STATbits.ACKSTAT)
                ackflag = FALSE;
            else
                ackflag = TRUE;
            break;
        case I2C_5:
            if(I2C5STATbits.ACKSTAT)
                ackflag = FALSE;
            else
                ackflag = TRUE;
            break;
    }
    return ackflag;
}

/*******************************************************************************
  Function:
    void restartI2C(BYTE i2c_id)

  Precondition:


  Summary:


  Description:


  Parameters:
    BYTE i2c_id

  Return Values:
    None

  Remarks:
    None
*******************************************************************************/
void restartI2C(BYTE i2c_id)
{
    switch(i2c_id)
    {
        case I2C_3:
            I2C3CONSET = _I2C3CON_RSEN_MASK;
            while(I2C3CONbits.RSEN);
            break;
        case I2C_4:
            I2C4CONSET = _I2C4CON_RSEN_MASK;
            while(I2C4CONbits.RSEN);
            break;
        case I2C_5:
            I2C5CONSET = _I2C5CON_RSEN_MASK;
            while(I2C5CONbits.RSEN);
            break;
    }
}

/*******************************************************************************
  Function:
    void stopI2C(BYTE i2c_id)

  Precondition:


  Summary:


  Description:


  Parameters:
    BYTE i2c_id

  Return Values:
    None

  Remarks:
    None
*******************************************************************************/
void stopI2C(BYTE i2c_id)
{
    switch(i2c_id)
    {
        case I2C_3:
            I2C3CONSET = _I2C3CON_PEN_MASK;
            break;
        case I2C_4:
            I2C4CONSET = _I2C4CON_PEN_MASK;
            break;
        case I2C_5:
            I2C5CONSET = _I2C5CON_PEN_MASK;
            break;
    }
}

/*******************************************************************************
  Function:
    BYTE getDataFromI2C(BYTE i2c_id)

  Precondition:


  Summary:


  Description:


  Parameters:
    BYTE i2c_id

  Return Values:


  Remarks:
    None
*******************************************************************************/
BYTE getDataFromI2C(BYTE i2c_id)
{
    BYTE data = 0;
    
    switch(i2c_id)
    {
        case I2C_3:
            I2C3CONbits.RCEN = 1;
            idleI2C(I2C_3);
            I2C3STATbits.I2COV = 0;
            while(!I2C3STATbits.RBF);
            data = I2C3RCV;
            break;
        case I2C_4:
            I2C4CONbits.RCEN = 1;
            idleI2C(I2C_4);
            I2C4STATbits.I2COV = 0;
            while(!I2C4STATbits.RBF);
            data = I2C4RCV;
            break;
        case I2C_5:
            I2C5CONbits.RCEN = 1;

            //idleI2C(I2C_5);
            //I2C5STATbits.I2COV = 0;
            while(!I2C5STATbits.RBF);

#if 1
            I2C5CONbits.ACKDT = 1;
            //idleI2C(I2C_5);
            I2C5CONbits.ACKEN = 1;
            //idleI2C(I2C_5);
            while(I2C5CONbits.ACKEN == 1);
#endif
            data = I2C5RCV;
            break;
    }
    return data;
}

#if defined(USE_RN131)
void sendCommandToRN134(unsigned char* cmd)
{
    while(*cmd != 0)
    {
        //putcUART2(*cmd++);
        while(!U2STAbits.TRMT);
        U2TXREG = *cmd++;
    }
    //putsUART2(cmd);
    DelayMs(1000);
}

void sendMessageToRN134(unsigned char* msg, INT32 len)
{
    INT32 i;
    for(i = 0; i < len; i++)
        putcUART2(*msg++);
}
#endif

#if defined(USE_DAC_PLUS_ADC)
void sendDataToAD5328(BYTE id, WORD msb)
{
    //WORD dummy = 0;
    SpiChnEnable(SPI_CHANNEL2, 0);
    //SpiChnConfigure(SPI_CHANNEL2, SPI_CONFIG_MSTEN | SPI_CONFIG_MODE16 | SPI_CONFIG_CKP_HIGH);
    SpiChnSetBitRate(SPI_CHANNEL2, 80000000, 4000000);
    SpiChnEnable(SPI_CHANNEL2, 1);

    switch(id)
    {
        case 0:
            outputPort("d0", LOW);
            break;
        case 1:
            outputPort("d2", LOW);
            break;
        case 2:
            outputPort("d3", LOW);
            break;
    }

    putcSPI2(msb);
    //dummy = getcSPI2();
    //Delay10us(1);

    switch(id)
    {
        case 0:
            outputPort("d0", HIGH);
            break;
        case 1:
            outputPort("d2", HIGH);
            break;
        case 2:
            outputPort("d3", HIGH);
            break;
    }

    SpiChnEnable(SPI_CHANNEL2, 0);
    SpiChnSetBitRate(SPI_CHANNEL2, 80000000, 1000000);
    SpiChnEnable(SPI_CHANNEL2, 1);
}

void sendDataToAD7490(WORD msb)
{
    outputPort("c13", LOW);

    putcSPI2(msb);

    if(SPI2STATbits.SPIROV)
        SPI2STATbits.SPIROV = 0;

    outputPort("c13", HIGH);
}

WORD receiveDataFromAD7490(WORD msb)
{
    WORD rdata = 0;

    outputPort("c13", LOW);
    putcSPI2(msb);
    rdata = getcSPI2();
    outputPort("c13", HIGH);

    return rdata;
}
#endif

#if defined(USE_ADG1414)
void sendDataToADG1414(WORD msb)
{
    WORD dummy = 0;
    //BYTE data0 = 0x00;
    //BYTE data1 = 0x00;

    SpiChnEnable(SPI_CHANNEL2, 0);
    SpiChnConfigure(SPI_CHANNEL2, SPI_CONFIG_MSTEN | SPI_CONFIG_MODE16 | SPI_CONFIG_CKP_HIGH);
    SpiChnSetBitRate(SPI_CHANNEL2, 80000000, 4000000);
    SpiChnEnable(SPI_CHANNEL2, 1);

    //data0 = (BYTE)(msb & 0x00FF);
    //data1 = (BYTE)((msb & 0xFF00) >> 8);

    outputPort("c14", LOW);

    //putcSPI2(data0);
    //putcSPI2(data1);
    putcSPI2(msb);

    outputPort("c14", HIGH);

    SpiChnEnable(SPI_CHANNEL2, 0);
    SpiChnConfigure(SPI_CHANNEL2, SPI_CONFIG_MSTEN | SPI_CONFIG_MODE16);
    SpiChnSetBitRate(SPI_CHANNEL2, 80000000, 1000000);
    SpiChnEnable(SPI_CHANNEL2, 1);
}
#endif
