yamamo2shun1/PICrouter/tkrworks-libs/Common/lcd.c

/*
 * Copylight (C) 2012, Shunichi Yamamoto, tkrworks.net
 *
 * This file is part of PICrouter.
 *
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
 * lcd.c,v.0.1.2 2013/09/06
 */

#define __LCD_C

//#include <string.h>
//#include "Compiler.h"
//#include "GenericTypeDefs.h"
//#include "HardwareProfile.h"
#include "lcd.h"
//#include "iosetting.h"

BYTE lcdText[CHARS_NUM * LINE_NUM + 1];

static BOOL initLcdFlag = FALSE;
static BYTE bit_mode = 0;
static char pin_rs[4]  = {0};
static char pin_rw[4]  = {0};
static char pin_e[4]   = {0};
static char pin_db0[4] = {0};
static char pin_db1[4] = {0};
static char pin_db2[4] = {0};
static char pin_db3[4] = {0};
static char pin_db4[4] = {0};
static char pin_db5[4] = {0};
static char pin_db6[4] = {0};
static char pin_db7[4] = {0};

/*******************************************************************************
  Function:
    void setLcdInitFlag(BOOL flag)

  Precondition:


  Summary:


  Description:


  Parameters:
    BOOL flag

  Return Values:
    None

  Remarks:
    None
*******************************************************************************/
void setLcdInitFlag(BOOL flag)
{
    initLcdFlag = flag;
}

/*******************************************************************************
  Function:
    BOOL getLcdInitFlag(void)

  Precondition:


  Summary:


  Description:


  Parameters:
    None

  Return Values:


  Remarks:
    None
*******************************************************************************/
BOOL getLcdInitFlag(void)
{
    return initLcdFlag;
}

/*******************************************************************************
  Function:
    void setLcdBitMode(BYTE num)

  Precondition:


  Summary:


  Description:


  Parameters:
    BYTE num

  Return Values:
    None

  Remarks:
    None
*******************************************************************************/
void setLcdBitMode(BYTE num)
{
    bit_mode = num;
}

/*******************************************************************************
  Function:
    BYTE getLcdBitMode(void)

  Precondition:


  Summary:


  Description:


  Parameters:
    None

  Return Values:


  Remarks:
    None
*******************************************************************************/
BYTE getLcdBitMode(void)
{
    return bit_mode;
}

/*******************************************************************************
  Function:
    void setLcdPortRsName(char* name)

  Precondition:


  Summary:


  Description:


  Parameters:
    char* name

  Return Values:
    None

  Remarks:
    None
*******************************************************************************/
void setLcdPortRsName(char* name)
{
    memset(pin_rs, 0, sizeof(pin_rs));
    strcpy(pin_rs, name);
}

/*******************************************************************************
  Function:
    char* getLcdPortRsName()

  Precondition:


  Summary:


  Description:


  Parameters:
    None

  Return Values:


  Remarks:
    None
*******************************************************************************/
char* getLcdPortRsName()
{
    return pin_rs;
}

/*******************************************************************************
  Function:
    void setLcdPortRwName(char* name)

  Precondition:


  Summary:


  Description:
    None

  Parameters:
    char* name

  Return Values:


  Remarks:
    None
*******************************************************************************/
void setLcdPortRwName(char* name)
{
    memset(pin_rw, 0, sizeof(pin_rw));
    strcpy(pin_rw, name);
}

/*******************************************************************************
  Function:
    char* getLcdPortRwName(void)

  Precondition:


  Summary:


  Description:


  Parameters:
    None

  Return Values:


  Remarks:
    None
*******************************************************************************/
char* getLcdPortRwName(void)
{
    return pin_rw;
}

/*******************************************************************************
  Function:
    void setLcdPortEName(char* name)

  Precondition:


  Summary:


  Description:


  Parameters:
    char* name

  Return Values:
    None

  Remarks:
    None
*******************************************************************************/
void setLcdPortEName(char* name)
{
    memset(pin_e, 0, sizeof(pin_e));
    strcpy(pin_e, name);
}

/*******************************************************************************
  Function:
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
            setPortIOType(pin_db3, IO_IN);
        }
        setPortIOType(pin_db4, IO_IN);
        setPortIOType(pin_db5, IO_IN);
        setPortIOType(pin_db6, IO_IN);
        setPortIOType(pin_db7, IO_IN);

        setPortIOType(pin_rs, IO_IN);
        setPortIOType(pin_rw, IO_IN);
}

/*******************************************************************************
  Function:
    void initLcd(BYTE bit_mode_num, char* rs_name, char* rw_name, char* e_name, char* db0_name, char* db1_name, char* db2_name, char* db3_name, char* db4_name, char* db5_name, char* db6_name, char* db7_name)

  Precondition:


  Summary:


  Description:


  Parameters:
    BYTE bit_mode_num
    char* rs_name
    char* rw_name
    char* e_name
    char* db0_name
    char* db1_name
    char* db2_name
    char* db3_name
    char* db4_name
    char* db5_name
    char* db6_name
    char* db7_name

  Return Values:
    None

  Remarks:
    None
*******************************************************************************/
void initLcd(BYTE bit_mode_num, char* rs_name, char* rw_name, char* e_name, char* db0_name, char* db1_name, char* db2_name, char* db3_name, char* db4_name, char* db5_name, char* db6_name, char* db7_name)
{
	BYTE i;

        if(initLcdFlag)
            return;
        
        initLcdFlag = TRUE;

	memset(lcdText, ' ', sizeof(lcdText) - 1);
	lcdText[sizeof(lcdText) - 1] = 0;

        setLcdBitMode(bit_mode_num);
        setLcdPortRsName(rs_name);
        setLcdPortRwName(rw_name);
        setLcdPortEName(e_name);
        if(bit_mode_num == 8)
        {
            setLcdPortDb0Name(db0_name);
            setLcdPortDb1Name(db1_name);
            setLcdPortDb2Name(db2_name);
            setLcdPortDb3Name(db3_name);
        }
        setLcdPortDb4Name(db4_name);
        setLcdPortDb5Name(db5_name);
        setLcdPortDb6Name(db6_name);
        setLcdPortDb7Name(db7_name);

        outputPort(pin_e, LOW);
        outputPort(pin_rw, LOW);

        if(bit_mode == 8)
        {
            setPortIOType(pin_db0, IO_OUT);
            setPortIOType(pin_db1, IO_OUT);
            setPortIOType(pin_db2, IO_OUT);
            setPortIOType(pin_db3, IO_OUT);
        }
        setPortIOType(pin_db4, IO_OUT);
        setPortIOType(pin_db5, IO_OUT);
        setPortIOType(pin_db6, IO_OUT);
        setPortIOType(pin_db7, IO_OUT);

        setPortIOType(pin_rs, IO_OUT);
        setPortIOType(pin_rw, IO_OUT);
        setPortIOType(pin_e, IO_OUT);

	DelayMs(40);

        writeLcd(0, 0x30);
        DelayMs(5);
        writeLcd(0, 0x30);
        Delay10us(20);
        writeLcd(0, 0x30);
        Delay10us(20);

        writeLcd(0, 0x20);
        Delay10us(5);

        // Display off
        writeLcd(0, 0x08);
        Delay10us(5);

        // Display on, Cursor off
        writeLcd(0, 0x0C); //writeLcd(0, 0x0D);
        Delay10us(5);

        // Entry Mode Set
        writeLcd(0, 0x06);
        Delay10us(5);

        // Return home
        writeLcd(0, 0x02);
        Delay10us(5);

        //writeLcd(0, 0x01);
        //Delay10us(2);
}

/*******************************************************************************
  Function:
    void updateLcd(void)

  Precondition:


  Summary:


  Description:


  Parameters:
    None

  Return Values:
    None

  Remarks:
    None
*******************************************************************************/
void updateLcd(void)
{
    BYTE i, j;

    // Go home
    writeLcd(0, 0x02);
    DelayMs(2);

    // Output first line
    for(i = 0; i < CHARS_NUM; i++)
    {
        // Erase the rest of the line if a null char is
        // encountered (good for printing strings directly)
        if(lcdText[i] == 0u)
        {
            for(j = i; j < CHARS_NUM; j++)
                lcdText[j] = ' ';
       }
        writeLcd(1, lcdText[i]);
        Delay10us(5);
    }
	
    // Set the address to the second line
    writeLcd(0, 0xC0);
    Delay10us(5);

    // Output second line
    for(i = CHARS_NUM; i < 2 * CHARS_NUM; i++)
    {
        // Erase the rest of the line if a null char is
        // encountered (good for printing strings directly)
        if(lcdText[i] == 0u)
        {
            for(j = i; j < 2 * CHARS_NUM; j++)
                lcdText[j] = ' ';
        }
        writeLcd(1, lcdText[i]);
        Delay10us(5);
    }

    // Set the address to the third line
    writeLcd(0, 0x94);
    Delay10us(5);

    // Output third line
    for(i = 2 * CHARS_NUM; i < 3 * CHARS_NUM; i++)
    {
        // Erase the rest of the line if a null char is
        // encountered (good for printing strings directly)
        if(lcdText[i] == 0u)
        {
            for(j = i; j < 3 * CHARS_NUM; j++)
                lcdText[j] = ' ';
        }
        writeLcd(1, lcdText[i]);
        Delay10us(5);
    }

    // Set the address to the fourth line
    writeLcd(0, 0xD4);
    Delay10us(5);

    // Output fourth line
    for(i = 3 * CHARS_NUM; i < 4 * CHARS_NUM; i++)
    {
        // Erase the rest of the line if a null char is
        // encountered (good for printing strings directly)
        if(lcdText[i] == 0u)
        {
            for(j = i; j < 4 * CHARS_NUM; j++)
                lcdText[j] = ' ';
        }
        writeLcd(1, lcdText[i]);
        Delay10us(5);
    }
}

/*******************************************************************************
  Function:
    void eraseLcd(void)

  Precondition:


  Summary:


  Description:


  Parameters:
    None

  Return Values:
    None

  Remarks:
    None
*******************************************************************************/
void eraseLcd(void)
{
    // Clear display
    writeLcd(0, 0x01);
    DelayMs(2);

    // Clear local copy
    memset(lcdText, ' ', CHARS_NUM * LINE_NUM);
}

/*******************************************************************************
  Function:
    void writeLineLcd(WORD number, char* line)

  Precondition:


  Summary:


  Description:


  Parameters:
    WORD number
    char* lin

  Return Values:
    None

  Remarks:
    None
*******************************************************************************/
void writeLineLcd(WORD number, char* line)
{
    BYTE i = 0;
    BYTE j = number * CHARS_NUM;

    if(strlen(line) == 20)
    {
        do
        {
            lcdText[j++] = line[i++];
        } while ((lcdText[j - 1] != 0) && (i < strlen(line)));
    }
    else
    {
        do
        {
            lcdText[j++] = line[i++];
        } while ((lcdText[j - 1] != 0) && (j < CHARS_NUM * LINE_NUM - 1));
    }
    
    updateLcd();
}
