yamamo2shun1/PICrouter/tkrworks-libs/TCPIP Stack/ZeroconfMulticastDNS.c

/*********************************************************************
 *
 *  Zero Configuration (Zeroconf) Multicast DNS and 
 *  Service Discovery Module for Microchip TCP/IP Stack
 *
 *********************************************************************
 * FileName:        ZeroconfMulticastDNS.h
 * Dependencies:    IP
 * Processor:       PIC24F, PIC24H, dsPIC30F, dsPIC33F, PIC32
 * Compiler:        Microchip C32 v1.05 or higher
 *					Microchip C30 v3.12 or higher
 * Company:         Microchip Technology, Inc.
 *
 * Software License Agreement
 *
 * Copyright (C) 2009-2010 Microchip Technology Inc.  All rights
 * reserved.
 *
 * Microchip licenses to you the right to use, modify, copy, and
 * distribute:
 * (i)  the Software when embedded on a Microchip microcontroller or
 *      digital signal controller product ("Device") which is
 *      integrated into Licensee's product; or
 * (ii) ONLY the Software driver source files ENC28J60.c, ENC28J60.h,
 *		ENCX24J600.c and ENCX24J600.h ported to a non-Microchip device
 *		used in conjunction with a Microchip ethernet controller for
 *		the sole purpose of interfacing with the ethernet controller.
 *
 * You should refer to the license agreement accompanying this
 * Software for additional information regarding your rights and
 * obligations.
 *
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
 *
 * Author               Date        Comment
 *~~~~~~~~~~~~~~~~~~~~~~~~~~~~~~~~~~~~~~~~~~~~~~~~~~~~~~~~~~~~~~~~~~~~
 * Pradeep Reddy        31 Mar 2009 Initial creation
 * Pradeep Reddy        23 Apr 2009 DNS-SD implementation
 * Pradeep Reddy        27 Apr 2009 Fixes and enhancements
 * Pradeep Reddy        11 May 2009 Code documentation
 * Pradeep Reddy        12 May 2009 Cleanup
 * King Shaw            14 Sep 2009 Added message-compression code
 * King Shaw            23 Sep 2009 Rewrite message-compression code to 
 *                                  decompress in-place.
 * King Shaw            10 Oct 2009 Rewrite responder code to pass conformance 
 *                                  tests with small footprint.
 * Brad Rex             05 Apr 2010 Updated for MRF24W
 ********************************************************************/
#define __Zeroconf_Multicast_DNS_C

#include "TCPIP Stack/TCPIP.h"
#define TICK DWORD

//MDNS_STATIC should be static in production code
//For code size tuning, defined to be (blank) - so C30 can give us the size of each function.
//#define MDNS_STATIC static
#define MDNS_STATIC static

#if defined(STACK_USE_ZEROCONF_MDNS_SD)
#include "TCPIP Stack/ZeroconfMulticastDNS.h"

extern void DisplayIPValue(IP_ADDR IPVal);

#define MDNS_PORT            5353
#define MAX_HOST_NAME_SIZE   32		//31+'\0'  Max Host name size
#define MAX_LABEL_SIZE       64		//63+'\0'  Maximum size allowed for a label. RFC 1035 (2.3.4) == 63

#define MAX_SRV_TYPE_SIZE    32		//31+'\0'  eg. "_http._tcp.local". Max could be 255, but is an overkill.

#if defined(__PIC32MX__)
#define MAX_RR_NAME_SIZE     256	//255+'\0' Max Resource Recd Name size. RFC 1035 (2.3.4) == 255
#define MAX_SRV_NAME_SIZE    64		//63+'\0'  eg. "My Web server". Max could be 255, but is an overkill.
#define MAX_TXT_DATA_SIZE	   128	//127+'\0' eg. "path=/index.htm"
#else
#define MAX_RR_NAME_SIZE     64     //256	//255+'\0' Max Resource Recd Name size. RFC 1035 (2.3.4) == 255
#define MAX_SRV_NAME_SIZE    32 //64		//63+'\0'  eg. "My Web server". Max could be 255, but is an overkill.
#define MAX_TXT_DATA_SIZE	   64 //128	//127+'\0' eg. "path=/index.htm"
#endif



#define RESOURCE_RECORD_TTL_VAL     3600 // Time-To-Live for a Resource-Record in seconds.

#define MAX_RR_NUM  4				// for A, PTR, SRV, and TXT  Max No.of Resource-Records/Service

/* Constants from mdns.txt (IETF Draft)*/
#define MDNS_PROBE_WAIT             750 // msecs  (initial random delay)
#define MDNS_PROBE_INTERVAL         250 // msecs (maximum delay till repeated probe)
#define MDNS_PROBE_NUM                6 //      (number of probe packets)
#define MDNS_MAX_PROBE_CONFLICT_NUM  30 // max num of conflicts before we insist and move on to announce ...
#define MDNS_ANNOUNCE_NUM             3 //      (number of announcement packets)
#define MDNS_ANNOUNCE_INTERVAL      250 // msecs (time between announcement packets)
#define MDNS_ANNOUNCE_WAIT          250 // msecs (delay before announcing)

// SOFTAP_ZEROCONF_SUPPORT
enum {
	MDNS_RESPONDER_INIT = 0,
	MDNS_RESPONDER_LISTEN,		
} mDNS_responder_state= MDNS_RESPONDER_INIT;  

/* Resource-Record Types from RFC-1035 */
typedef enum {
    QTYPE_A = 1,
    QTYPE_NS = 2,
    QTYPE_CNAME = 5,
    QTYPE_PTR = 12,
    QTYPE_TXT = 16,
    QTYPE_SRV = 33,
    QTYPE_ANY = 255,
}MDNS_QTYPE;

/* Indexes in Resource-record list */
#define QTYPE_A_INDEX   0
#define QTYPE_PTR_INDEX 1
#define QTYPE_SRV_INDEX 2
#define QTYPE_TXT_INDEX 3

/* MDNS Message Fomrat, which is common
 * for Queries and Resource-Records. Taken
 * from RFC 1035 
 */
/* MDNS Message Header Flags */
typedef union _MDNS_MSG_HEADER_FLAGS {

    struct {
		BYTE        rcode:4;
		BYTE        z:3; 
        BYTE        ra:1;       
		BYTE        rd:1;
		BYTE        tc:1;
		BYTE        aa:1;
		BYTE        opcode:4;
        BYTE        qr:1;                        
    }bits;
    WORD Val;
	BYTE v[2];     
} MDNS_MSG_HEADER_FLAGS;

/* MDNS Message-Header Format */
typedef struct _MDNS_MSG_HEADER
{
	WORD_VAL query_id;
	MDNS_MSG_HEADER_FLAGS flags;
	WORD_VAL nQuestions;
	WORD_VAL nAnswers;
	WORD_VAL nAuthoritativeRecords;
	WORD_VAL nAdditionalRecords;
} MDNS_MSG_HEADER;

/* DNS-Query Format, which is prepended by 
 * DNS-MESSAGE Header defined above */
struct question
{
    unsigned char *name;
    unsigned short int type, class;
};

/* DNS-Resource Record Format, which is 
 * prepended by DNS-MESSAGE Header 
 * defined above. This definition includes
 * all resource-record data formats, to have
 * small-memory foot print */

struct _mDNSProcessCtx_sd;// mdnsd_struct
struct _mDNSProcessCtx_common;

typedef struct _mDNSResourceRecord
{
	BYTE		*name;
    WORD_VAL	type;
    WORD_VAL	class;
    DWORD_VAL	ttl;
    WORD_VAL	rdlength;    

	union {
		IP_ADDR ip;		// for A record

		struct { 
			WORD_VAL priority;
			WORD_VAL weight;
			WORD_VAL port;
		} srv;			// for SRV record
	};

	// DO NOT merge this into the union.
	BYTE *rdata;		// for PTR, SRV and TXT records. 

    /* House-Keeping Stuff */

	// pointer to the header Ctx of the process that "owns" this resource record.
	struct _mDNSProcessCtx_common *pOwnerCtx;	

    BYTE valid; /* indicates whether rr is valid */
	BOOL bNameAndTypeMatched;
	BOOL bResponseRequested;
	BOOL bResponseSuppressed;
} mDNSResourceRecord;

/* DNS-SD Specific Data-Structures */

typedef enum _MDNS_STATE
{
	MDNS_STATE_HOME = 0,
 	MDNS_STATE_INTF_NOT_CONNECTED,
 	MDNS_STATE_IPADDR_NOT_CONFIGURED,	
	MDNS_STATE_NOT_READY,
	MDNS_STATE_INIT,
	MDNS_STATE_PROBE,
	MDNS_STATE_ANNOUNCE,
	MDNS_STATE_DEFEND,
} MDNS_STATE;

typedef enum _MDNS_RR_GROUP
{
	MDNS_RR_GROUP_QD,
	MDNS_RR_GROUP_AN,
	MDNS_RR_GROUP_NS,
	MDNS_RR_GROUP_AR
} MDNS_RR_GROUP;

typedef struct __attribute__((__packed__))  _mDNSResponderCtx
{
	mDNSResourceRecord		rr_list[MAX_RR_NUM];	// Our resource records.

	BOOL				bLastMsgIsIncomplete;	// Last DNS msg was truncated
	WORD_VAL            query_id;				// mDNS Query transaction ID
	IP_ADDR				prev_ipaddr;			// To keep track of changes in IP-addr
} mDNSResponderCtx;

typedef enum _MDNS_CTX_TYPE
{
	MDNS_CTX_TYPE_HOST = 0,
	MDNS_CTX_TYPE_SD
} MDNS_CTX_TYPE;

typedef struct _mDNSProcessCtx_common
{
	MDNS_CTX_TYPE	type;		// Is owner mDNS ("HOST") or mDNS-SD ("SD")?
	MDNS_STATE		state;		// PROBE, ANNOUNCE, DEFEND, ...

	BYTE nProbeCount;
	BYTE nProbeConflictCount;
    BYTE nClaimCount;
    BOOL bProbeConflictSeen;
    BOOL bLateConflictSeen;

	BOOL bConflictSeenInLastProbe;
	BYTE nInstanceId;

	TICK event_time;	// Internal Timer, to keep track of events
	BYTE time_recorded; // Flag to indicate event_time is loaded
	TICK random_delay;

} mDNSProcessCtx_common;

typedef struct __attribute__((__packed__))  _mDNSProcessCtx_host
{
	mDNSProcessCtx_common common;

	mDNSResponderCtx *pResponderCtx;

	// other host name related info

	BYTE szUserChosenHostName[MAX_HOST_NAME_SIZE];	// user chosen host name
	BYTE szHostName[MAX_HOST_NAME_SIZE];					// mDNS chosen Host-Name

} mDNSProcessCtx_host;

typedef struct __attribute__((__packed__))  _mDNSProcessCtx_sd
{
	mDNSProcessCtx_common common;

	mDNSResponderCtx *pResponderCtx;

	// info specific to SD
    BYTE srv_name[MAX_SRV_NAME_SIZE];
    BYTE srv_type[MAX_SRV_TYPE_SIZE];
    BYTE sd_qualified_name[MAX_RR_NAME_SIZE];
    BYTE used; /* Spinlock to protect Race-cond. */
    
    BYTE sd_auto_rename: 1,        /* Flag to show auto-Rename is enabled */
         sd_service_advertised: 1, /* Flag to show whether service is advertised */
		 service_registered: 1;    /* Flag to indicate that user has registered this service */

    WORD sd_port; /* Port number in Local-sys where Service is being offered */
    BYTE sd_txt_rec[MAX_TXT_DATA_SIZE];
    BYTE sd_txt_rec_len;
    
    void (*sd_call_back)(char *, MDNSD_ERR_CODE , void *);
    void *sd_context;

} mDNSProcessCtx_sd;

static mDNSProcessCtx_host		gHostCtx;
static mDNSProcessCtx_sd		gSDCtx;
static mDNSResponderCtx			gResponderCtx;

/* DNS-SD State-Machine */

const BYTE *CONST_STR_local = (BYTE *) "local";

/* Multicast-DNS States defintion */

/************** Global Declarations ***************/
/* Remote Node info, which is Multicast-Node
 * whose IP-address is 224.0.0.251 & MAC-Address
 * is 01:00:5E:00:00:FB. Multicast-IP address for
 * mDNS is specified by mdns.txt (IETF). IP is
 * translated into Multicast-MAC address according 
 * rules specified in Std.
 */
static NODE_INFO mDNSRemote; 
UDP_SOCKET mDNS_socket = INVALID_UDP_SOCKET;  // Multicast-Socket Opened up for 
                         // mDNS Server/Client (Responder/Qurier)


/* Global declaration to support Message-Compression
 * defined in RFC-1035, Section 4.1.4 */

/* Forward declarations */
MDNS_STATIC void mDNSResponder(void);
MDNS_STATIC WORD mDNSDeCompress(WORD wPos, BYTE *pcString, BOOL bFollowPtr, BYTE cElement, BYTE cDepth);
MDNS_STATIC size_t mDNSSDFormatServiceInstance(BYTE *string, size_t strSize );
static WORD g_mDNS_offset;


// Redirect all UDPPUT_LOCAL() calls to here.
// This seems to make all those 'call + nop' (2 instructions) into 'rcall' (1 instruction)

MDNS_STATIC void 
UDPPUT_LOCAL(BYTE c)
{
	UDPPut(c);
}

/***************************************************************
  Function:
	void DisplayHostName(BYTE *HostName)

  Summary:
	Writes an Host-Name to the LCD display and the UART 
    as available 
    
  Description:
	This function takes a string and then displays it on LCD's
    2nd half.    

  Parameters:
	HostName - the Hos-name to be displayed. 

  Returns:
  	None
  ***************************************************************/
MDNS_STATIC void DisplayHostName(BYTE *HostName)
{
    BYTE SingleChar;
	BYTE i;
	BYTE len;
#ifdef USE_LCD
    BYTE LCDPos=0;
#endif

	#if defined(STACK_USE_UART)
		putrsUART((ROM char*)"\r\nZeroConf: Host = ");
		putrsUART((ROM char*)HostName);
		putrsUART((ROM char*)"\r\n");
	#endif

	len = strlen((char *)HostName);

    for(i = 0; (i < len) && (i < 16u); i++)
	{
        SingleChar = *HostName++;
        if(SingleChar == '\0')
				break;		

		#ifdef USE_LCD
            LCDText[LCDPos++] = SingleChar;			
        #endif
		
	}

	#ifdef USE_LCD
		if(LCDPos < 32u)
			LCDText[LCDPos] = 0;
		LCDUpdate();
	#endif

}

/************* Local String Functions ******************/



/***************************************************************
  Function:
	static BYTE strcmp_local_ignore_case(BYTE *string_1, BYTE *string_2)

  Summary:
	Compares two strings by ignoring the case.

  Parameters:
	string_1 & string_2 - Two strings

  Returns:
    Zero: If two strings are equal.
    Non-Zero: If both strings are not equal or on error case  	
  **************************************************************/
MDNS_STATIC BYTE strcmp_local_ignore_case(BYTE *str_1, BYTE *str_2)
{
    if(str_1 == NULL || str_2 == NULL)
    {
        WARN_MDNS_PRINT("strmcmp_local_ignore_case: String is NULL \r\n");
        return -1;
    }
	
    while(*str_1 && *str_2){
        if(*str_1 == *str_2 || (*str_1-32) == *str_2 ||
			*str_1 == (*str_2-32))
		{
			str_1++;
			str_2++;
            continue;
		}
		else 
			return 1;

    }
    if(*str_1 == '\0' && *str_2 == '\0')
        return 0;
    else
        return 1;
    
}


MDNS_STATIC void 
mDNSResetCounters(mDNSProcessCtx_common *pHeader, BOOL bResetProbeConflictCount)
{
	if (bResetProbeConflictCount)
	{

        pHeader->nProbeConflictCount = 0;
	}
	
	pHeader->nProbeCount = 0;
    pHeader->nClaimCount = 0;
    pHeader->bLateConflictSeen = FALSE;  
	pHeader->bProbeConflictSeen = FALSE;	
}

/***************************************************************
  Function:
	static void mDNSRename(BYTE *str, BYTE max_len)

  Summary:
	Renames a string with a numerical-extension.
	
  Description:
	This function is to rename host-name/Resource-Record Name,
    when a name-conflict is detected on local-network.
    For-Ex: "myhost" is chosen name and a conflict is detected
    this function renames as "myhost-2". Also ensures that string
    is properly formatted.

  Precondition:
	None

  Parameters:
	String - the string to be Renamed with Numerical-Extenstion.
    max_len - Maximum Length allowed for String

  Returns:
  	None
  **************************************************************/

// strLabel:  the user registered name. 
//            E.g., "Web Server", for service name (srv_name), or 
//                 "My Host", for host name (taken from MY_DEFAULT_HOST_NAME)
// nLabelId:  instance number, to avoid conflict in the name space.
// strBase:   the base name for the appropriate name space.
//            E.g., "_http._tcp.local" for service name, or
//                 "local" for host name.
// strTarget: where the newly constructed fully-qualified-name will be stored.
// nMaxLen:   max length for the newly constructed label, which is the first portion of the
//            fully-qualified-name
//
// ("Web Server", 3, "_http._tcp.local", strTarget, 63) => 
//     stores "Web Server-3._http._tcp.local" to *strTarget.
// ("MyHost", 2, "local", strTarget, 63) =>
//     stores "MyHost-2.local" to *strTarget
//

MDNS_STATIC void mDNSRename(BYTE *strLabel, BYTE nLabelId, BYTE *strBase, BYTE *strTarget, BYTE nMaxLen)
{
    size_t  targetLen;
	BYTE n = nLabelId;
#define mDNSRename_ID_LEN 6
	BYTE str_n[mDNSRename_ID_LEN]; //enough for "-255." + '\0'.
	BYTE i = mDNSRename_ID_LEN - 1 ;

	str_n[i--] = 0;
	str_n[i--] = '.';

	// construct str_n from n
	while (i != 0)
	{
		str_n[i--] = '0'+ n%10;
		if (n < 10) break;
		n = n/10;
	}
	str_n[i] = '-';

    targetLen = strncpy_m((char *)strTarget, nMaxLen, 3, strLabel, &(str_n[i]), strBase);

#ifdef MDNS_WARN
	if ( targetLen == nMaxLen )
	{
		MDNS_WARN("mDNSRename: label too long - truncated\r\n");
	}
#endif

}

/***************************************************************
  Function:
	static void mDNSPutString(BYTE* String)

  Summary:
	Writes a string to the Multicast-DNS socket.
	
  Description:
	This function writes a string to the Multicast-DNS socket, 
    ensuring that it is properly formatted.

  Precondition:
	UDP socket is obtained and ready for writing.

  Parameters:
	String - the string to write to the UDP socket.

  Returns:
  	None
  **************************************************************/

MDNS_STATIC void mDNSPutString(BYTE* string)
{
	BYTE *right_ptr,*label_ptr;
    BYTE label[MAX_LABEL_SIZE];
	BYTE i;
	BYTE len;

	right_ptr = string;
    
	while(1)
	{
        label_ptr = label;
        len = 0;
        while(*right_ptr)
        {
            i = *right_ptr;
            
            if(i == '.' || i == '/' ||
               i == ',' || i == '>' || i == '\\')
            {
			    /* Formatted Serv-Instance will have '\.' 
                * instead of just '.' */
                if(i == '\\')
                {
                    right_ptr++;                    
                }
                 
                else
                    break;
            }
            *label_ptr++ = *right_ptr;
            len++;
            right_ptr++;
        }
        i = *right_ptr++;

		// Put the length and data
		// Also, skip over the '.' in the input string
        UDPPUT_LOCAL(len);
        UDPPutArray(label, len);
		string =  right_ptr;

		if(i == 0x00u || i == '/' || i == ',' || i == '>')
			break;
	}
	
	// Put the string null terminator character
	UDPPUT_LOCAL(0x00);
}

/***************************************************************
  Function:
	static BOOL mDNSSendQuery(BYTE* name, BYTE record_type)

  Summary:
	Sends out a Multicast-DNS-Query to Multicast-Address 
    through mDNS_socket.
	
  Description:
	This function is used in Probing-phase to check the
    uniqueness of chosen Host-Name/ Resoruce-Record-Name.
    Selected Name and Type of Query are put into 
    Multicast UDP socket.

  Precondition:
	UDP socket (mDNS_socket) is obtained and ready for writing.

  Parameters:
	name - Chosen Host-Name/Resource-Record-Name, checking 
           for uniqueness.
    type - Type of Query 

  Returns:
  	TRUE - On Success
    FALSE - On Failure (If UDP-Socket is invalid)
  **************************************************************/
//MDNS_STATIC BOOL mDNSSendQuery(BYTE* name, BYTE record_type, BYTE cFlush, BYTE probe_type)

MDNS_STATIC BOOL mDNSProbe(mDNSProcessCtx_common *pCtx)
{
	MDNS_MSG_HEADER mDNS_header;

    // Abort operation if no UDP sockets are available
	// If this ever happens, incrementing MAX_UDP_SOCKETS in 
	// StackTsk.h may help (at the expense of more global memory 
	// resources).

	if(mDNS_socket == INVALID_UDP_SOCKET)
    {
        WARN_MDNS_PRINT("mDNSSendQuery: Opening UDP Socket Failed \r\n");
		return FALSE;
    }
	
	// Make certain the socket can be written to
	while(!UDPIsPutReady(mDNS_socket));

    // Put DNS query here
	gResponderCtx.query_id.Val++;

	/*
    UDPPUT_LOCAL(gResponderCtx.query_id.v[1]);// User chosen transaction ID
    UDPPUT_LOCAL(gResponderCtx.query_id.v[0]);

    UDPPUT_LOCAL(0x00);		// Standard query with recursion
	UDPPUT_LOCAL(0x00);	
	
	UDPPUT_LOCAL(0x00);		// 1 entry in the question section
	UDPPUT_LOCAL(0x01);
	
	UDPPUT_LOCAL(0x00);		// 0 entry in the answer section
	UDPPUT_LOCAL(0x00);
	
	UDPPUT_LOCAL(0x00);		// 1 entry in name server section
	UDPPUT_LOCAL(0x01);		

	UDPPUT_LOCAL(0x00);		// 0 entry in additional records section
	UDPPUT_LOCAL(0x00);
	*/

	mDNS_header.query_id.Val = swaps(gResponderCtx.query_id.Val);	// User chosen transaction ID
	mDNS_header.flags.Val = 0;										// Standard query with recursion
	mDNS_header.nQuestions.Val = swaps(((WORD)1u));					// 1 entry in the question section
	mDNS_header.nAnswers.Val = 0;									// 0 entry in the answer section
	mDNS_header.nAuthoritativeRecords.Val = swaps(((WORD)1u));		// 1 entry in name server section
	mDNS_header.nAdditionalRecords.Val = 0;							// 0 entry in additional records section

	// Put out the mDNS message header
	UDPPutArray((BYTE *) &mDNS_header, sizeof(MDNS_MSG_HEADER));

	// Start of the QD section 

	switch (pCtx->type)
	{
	case MDNS_CTX_TYPE_HOST:

		mDNSPutString(gResponderCtx.rr_list[QTYPE_A_INDEX].name);
		break;

	case MDNS_CTX_TYPE_SD:

		mDNSPutString(gResponderCtx.rr_list[QTYPE_SRV_INDEX].name);
		break;
	}

	UDPPUT_LOCAL(0x00);			// Type: Always QTYPE_ANY
	UDPPUT_LOCAL(QTYPE_ANY);

	UDPPUT_LOCAL(0x80);			// Class: Cache-Flush
	UDPPUT_LOCAL(0x01);			//        IN (Internet)

	// Start of the NS section 

	switch (pCtx->type)
	{
	case MDNS_CTX_TYPE_HOST:
		mDNSPutString(gResponderCtx.rr_list[QTYPE_A_INDEX].name);
		break;

	case MDNS_CTX_TYPE_SD:
		mDNSPutString(gResponderCtx.rr_list[QTYPE_SRV_INDEX].name);
		break;
	}
	
	UDPPUT_LOCAL(0x00);		// Type: A or SRV 

	switch (pCtx->type)
	{
	case MDNS_CTX_TYPE_HOST:
		UDPPUT_LOCAL(QTYPE_A);
		break;

	case MDNS_CTX_TYPE_SD:
		UDPPUT_LOCAL(QTYPE_SRV);
		break;
	}

		

	UDPPUT_LOCAL(0x00);		// Class: Cache-Flush bit MUST NOT be set
	UDPPUT_LOCAL(0x01);		//        IN (Internet)

	UDPPUT_LOCAL(0x00);		// 0x00000078 Time To Live, 2 minutes
	UDPPUT_LOCAL(0x00);
	UDPPUT_LOCAL(0x00);
	UDPPUT_LOCAL(0x78);

	switch (pCtx->type)
	{
	case MDNS_CTX_TYPE_HOST:
		{
			UDPPUT_LOCAL(gResponderCtx.rr_list[QTYPE_A_INDEX].rdlength.v[1]);
			UDPPUT_LOCAL(gResponderCtx.rr_list[QTYPE_A_INDEX].rdlength.v[0]);

			UDPPUT_LOCAL(gResponderCtx.rr_list[QTYPE_A_INDEX].ip.v[0]);
			UDPPUT_LOCAL(gResponderCtx.rr_list[QTYPE_A_INDEX].ip.v[1]);
			UDPPUT_LOCAL(gResponderCtx.rr_list[QTYPE_A_INDEX].ip.v[2]);
			UDPPUT_LOCAL(gResponderCtx.rr_list[QTYPE_A_INDEX].ip.v[3]);

			break;
		}

	case MDNS_CTX_TYPE_SD:
		{
			UDPPUT_LOCAL(gResponderCtx.rr_list[QTYPE_SRV_INDEX].rdlength.v[1]);
			UDPPUT_LOCAL(gResponderCtx.rr_list[QTYPE_SRV_INDEX].rdlength.v[0]);

			UDPPUT_LOCAL(gResponderCtx.rr_list[QTYPE_SRV_INDEX].srv.priority.v[1]);
			UDPPUT_LOCAL(gResponderCtx.rr_list[QTYPE_SRV_INDEX].srv.priority.v[0]);
			UDPPUT_LOCAL(gResponderCtx.rr_list[QTYPE_SRV_INDEX].srv.weight.v[1]);
			UDPPUT_LOCAL(gResponderCtx.rr_list[QTYPE_SRV_INDEX].srv.weight.v[0]);
			UDPPUT_LOCAL(gResponderCtx.rr_list[QTYPE_SRV_INDEX].srv.port.v[1]);
			UDPPUT_LOCAL(gResponderCtx.rr_list[QTYPE_SRV_INDEX].srv.port.v[0]);

			mDNSPutString(gResponderCtx.rr_list[QTYPE_SRV_INDEX].rdata);

			break;
		}
	}

	UDPFlush();

    return TRUE; 	
}

/***************************************************************
  Function:
	static BOOL mDNSSendRR(struct mDNSResourceRecord *record, 
                   BYTE record_type, DWORD ttl_val,WORD query_id)

  Summary:
	Sends out a Multicast-DNS-Answer (Resource-Record) to 
    Multicast-Address through mDNS_socket (UDP Socket).
	
  Description:
	This function is used in Announce-phase & Defend-Phase.

    In announce-phase the Host-Name or Resource-Record (Service) 
    will be announced in local-network, so that neighbors can
    detect new-service or update their caches with new host-name
    to IP-Address mapping.

    In Defend-Phase, when mDNSResponder receives a query for
    Host-name or Resounce-record for which this holds authority.
    
  Precondition:
	UDP socket (mDNS_socket) is obtained and ready for writing.

  Parameters:
	record - Resource-Record filled up with required info
    type   - Type of Res-Rec
    ttl_val - Time-To-Live value for Res-Record
    query_id - Query-ID for which this mDNS-answer (Res-Rec) 
               corresponds to

  Returns:
  	TRUE - On Success
    FALSE - On Failure (If UDP-Socket is invalid)
  **************************************************************/

MDNS_STATIC BOOL 
mDNSSendRR(mDNSResourceRecord *pRecord,
		   WORD query_id,
		   BYTE cFlush,
		   WORD nAnswersInMsg,
		   BOOL bIsFirstRR, 
		   BOOL bIsLastRR)
{
    MDNS_MSG_HEADER mDNS_header;
    DWORD_VAL ttl;
    BYTE rec_length;
	BYTE record_type;

	record_type = pRecord->type.Val;

	DEBUG0_MDNS_MESG(zeroconf_dbg_msg, "tx RR: (%d)\r\n", record_type);
	DEBUG0_MDNS_PRINT(zeroconf_dbg_msg);

    if(mDNS_socket == INVALID_UDP_SOCKET)
    {
        WARN_MDNS_PRINT("mDNSSendRR: Opening UDP Socket Failed \r\n");
		return FALSE;
    }

    while(!UDPIsPutReady(mDNS_socket));

	if (bIsFirstRR)
	{
		memset(&mDNS_header, 0, sizeof(MDNS_MSG_HEADER));

		mDNS_header.query_id.Val = swaps(query_id);

		mDNS_header.flags.bits.qr = 1; // this is a Response,
		mDNS_header.flags.bits.aa = 1; // and we are authoritative
		mDNS_header.flags.Val = swaps(mDNS_header.flags.Val);
		
		mDNS_header.nAnswers.Val = swaps(nAnswersInMsg);

		// Put out the mDNS message header
		UDPPutArray((BYTE *) &mDNS_header, sizeof(MDNS_MSG_HEADER));
	}

	ttl.Val = pRecord->ttl.Val;

//rex#if 0
//rex	if ( name != NULL) 
//rex	{
//rex		mDNSPutString(name);
//rex	}
//rex	else
//rex#endif
//rex	{
		mDNSPutString(pRecord->name);
//rex	}

	UDPPUT_LOCAL(0x00); UDPPUT_LOCAL(record_type);		// Resource Record Type

    /* MSB of Upper-byte in Class filed acts as 
     * Cache-Flush bit to notify all Neighbors to 
     * flush their caches and fill with this new 
     * information */
	if (UDPSocketInfo[mDNS_socket].remotePort == MDNS_PORT)
	{
		UDPPUT_LOCAL(cFlush); UDPPUT_LOCAL(0x01);		// Class 
	}
	else
	{
		// Legacy/Unicast DNS response should not set the Cache-Flush bit.
		UDPPUT_LOCAL(0x00); UDPPUT_LOCAL(0x01);			// Class 
	}

    UDPPUT_LOCAL(ttl.v[3]);		// Time To Live
    UDPPUT_LOCAL(ttl.v[2]);
    UDPPUT_LOCAL(ttl.v[1]);
    UDPPUT_LOCAL(ttl.v[0]);

	switch (record_type)
	{
	case QTYPE_A:
    
        UDPPUT_LOCAL(0x00);	// 0x0004 Data length
        UDPPUT_LOCAL(0x04);	
        UDPPUT_LOCAL(pRecord->ip.v[0]);	// Put out IP address
        UDPPUT_LOCAL(pRecord->ip.v[1]);	// AppConfig.MyIPAddr.v[1]
        UDPPUT_LOCAL(pRecord->ip.v[2]);
        UDPPUT_LOCAL(pRecord->ip.v[3]);
    
		break;

	case QTYPE_PTR:

        /* 2 bytes extra. One for Prefix Length for first-label.
         * Other one for NULL terminator */
        pRecord->rdlength.Val = strlen((char *)pRecord->rdata) + 2 ;

        UDPPUT_LOCAL(pRecord->rdlength.v[1]);
        UDPPUT_LOCAL(pRecord->rdlength.v[0]); // Res-Data Length

        mDNSPutString(((mDNSProcessCtx_sd *) (pRecord->pOwnerCtx))->sd_qualified_name);

		break;
    
	case QTYPE_SRV:

        /* 2 bytes extra. One for Prefix Length for first-label.
         * Other one for NULL terminator */

        pRecord->rdlength.Val = strlen((char *)pRecord->rdata) + 2;
        pRecord->rdlength.Val += 6;					// for priority, weight, and port

        UDPPUT_LOCAL(pRecord->rdlength.v[1]);
        UDPPUT_LOCAL(pRecord->rdlength.v[0]);		// Res-Data Length

        UDPPUT_LOCAL(pRecord->srv.priority.v[1]);	// Put Priority
        UDPPUT_LOCAL(pRecord->srv.priority.v[0]);
        UDPPUT_LOCAL(pRecord->srv.weight.v[1]);
        UDPPUT_LOCAL(pRecord->srv.weight.v[0]);
        UDPPUT_LOCAL(pRecord->srv.port.v[1]);
        UDPPUT_LOCAL(pRecord->srv.port.v[0]);        

        mDNSPutString(pRecord->rdata);

		break;

	case QTYPE_TXT:

        rec_length = strlen((char *)pRecord->rdata);
        pRecord->rdlength.Val = rec_length + 1;

        UDPPUT_LOCAL(pRecord->rdlength.v[1]);
        UDPPUT_LOCAL(pRecord->rdlength.v[0]); // Res-Data Length

        UDPPUT_LOCAL(pRecord->rdlength.Val-1); // As of now only single TXT string supported!!

        UDPPutArray(pRecord->rdata,rec_length);

		break;

	default:

        WARN_MDNS_PRINT("RR Type not supported \n");
	}

	if (bIsLastRR)
	{
	    UDPFlush();
	}

    return TRUE;
}

/***************************************************************
  Function:
	size_t mDNSSDFormatServiceInstance(BYTE *string, size_t strSize )

  Summary:
	Formats the Service-Instance name according to DNS-SD standard 
    specification.
	
  Description:
	This function is used to format the Service-Instance name, if
    it contains 'dots' and 'backslashes'

    As the service-instance name will be merged with service-type &
    to distinguish the 'dots' seperating the service-type words and
    'dots' within service-instance name, the 'dots' within service-
    instance name will be replaced with '\.' in place of '.' Even the 
    '\' are replaced with '\\'.

    When the resource-record containing service-instance name is 
    pushed out, the formatted dots '\.' are sentout as '.' and the
    'dots' sperating the service-type & service-instances are replaced
    with length bytes, as specified in RFC 1035.
        
  Precondition:
	None

  Parameters:
	String - Service-Instance name to be formatted
    strSize - available size for the formatted string, not to be exceeded
    
  Returns:
  	size of the formatted string
  **************************************************************/
MDNS_STATIC size_t mDNSSDFormatServiceInstance(BYTE *string, size_t strSize )
{
	BYTE *temp;
	BYTE output[MAX_LABEL_SIZE];
	BYTE i;
	BYTE *right_ptr,*str_token;
	BYTE len;

	temp = output;
	right_ptr = string;
	str_token = string;
	while(1) 
	{
		do
		{
			i = *right_ptr++;
		} while((i != 0x00u) && (i != '\\') && (i != '.') );

				
		/* Prefix '\' for every occurance of '.' & '\' */
		len = (BYTE)(right_ptr-str_token-1);
		
		memcpy(temp,str_token,len);
		temp += len;
		str_token +=  len;
		if(i == '.' || i == '\\')
		{
			*temp = '\\';
			temp++;
			*temp++ = i;
			str_token += 1;			
			
		}
		else if(i == 0x00u || i == '/' || i == ',' || i == '>')
			break;
	
	}
	*temp++ = '\0';
	return strncpy_m((char *)string, strSize, 1, output);
}		

/***************************************************************
  Function:
	void mDNSSDFillResRecords(mdnsd_struct *sd)

  Summary:
	Fills the resource-records with the information received from
    sd structure-instance, in which the information is filled from
    user input. 
	
  Description:
	This function is used to fill the resource-records according to 
    format specified in RFC 1035.

    In this context Service-Instance + Service-Type is called fully
    qualified name. For ex: Dummy HTTP Web-Server._http._tcp.local
    where Dummy HTTP Web-Server is Service-instance name
     and  _http._tcp.local is Service-Type 

    Each service-instance that needs to be advertised contains three
    resource-reocrds. 
    1) PTR Resource-Record: This is a shared record, with service-type
                           as rr-name and fully-qualified name as 
                           rr-data.
    2) SRV Resource-Record: This is a unique record, with fully-
                            qualified name as rr-name and Host-name,
                            port-num as rr-data.
    3) TXT Resource-Record: This is a unique record, with fully-
                            qualified name as rr-name and additional
                            information as rr-data like default-page
                            name (For ex: "/index.htm")            
    
  Precondition:
	None

  Parameters:
	sd - Service-Discovery structure instance for which Resource-
         records to be filled. 
    
  Returns:
  	None
  **************************************************************/
void mDNSSDFillResRecords(mDNSProcessCtx_sd *sd)
{
    size_t srv_name_len,srv_type_len, qual_len;
    mDNSResourceRecord *rr_list = &(gResponderCtx.rr_list[QTYPE_PTR_INDEX]);

    srv_name_len = strlen((char *)sd->srv_name);
    srv_type_len = strlen((char *)sd->srv_type);

	memset(&(gResponderCtx.rr_list[QTYPE_PTR_INDEX]),0,(sizeof(mDNSResourceRecord)));
	memset(&(gResponderCtx.rr_list[QTYPE_SRV_INDEX]),0,(sizeof(mDNSResourceRecord)));
	memset(&(gResponderCtx.rr_list[QTYPE_TXT_INDEX]),0,(sizeof(mDNSResourceRecord)));

    /* Formatting Service-Instance name.
     * And preparing a fully qualified 
     * Service-instance name. */
    strncpy((char *)sd->sd_qualified_name, (char *)sd->srv_name, sizeof(sd->sd_qualified_name));
    qual_len= mDNSSDFormatServiceInstance(sd->sd_qualified_name, sizeof(sd->sd_qualified_name));

    // SOFTAP_ZEROCONF_SUPPORT
    // Overwritten with zeros inside the gSDCtx and the mDNS will start advertizing on port 0 instead of the normal port
    //strncpy_m((char *)sd->sd_qualified_name + qual_len, sizeof(sd->sd_qualified_name), 2, ".", sd->srv_type); 
	strncpy_m((char *)sd->sd_qualified_name + qual_len, sizeof(sd->sd_qualified_name) - qual_len, 2, ".", sd->srv_type);

    DEBUG_MDNS_MESG(zeroconf_dbg_msg,"Fully Qualified Name: %s \r\n",sd->sd_qualified_name);
    DEBUG_MDNS_PRINT(zeroconf_dbg_msg);

    /* Fill-up PTR Record */
    rr_list->type.Val = QTYPE_PTR;
	rr_list->name = (BYTE *) (sd->srv_type);

    /* Res Record Name is 
     * Service_Instance_name._srv-type._proto.domain */
	rr_list->rdata = (BYTE *) (sd->sd_qualified_name);

    strncpy_m((char *)rr_list->rdata + srv_name_len, sizeof(sd->sd_qualified_name) - srv_name_len, 2, ".", sd->srv_type);
    
    /* 3 bytes extra. One for dot added between
     * Serv-Name and Serv-Type. One for length byte.
     * added for first-label in fully qualified name
     * Other one for NULL terminator */
    rr_list->rdlength.Val = srv_name_len+ srv_type_len + 3; 
    rr_list->ttl.Val = RESOURCE_RECORD_TTL_VAL;
    rr_list->pOwnerCtx = (mDNSProcessCtx_common *) sd; /* Save back ptr */
    rr_list->valid = 1; /* Mark as valid */
    
    rr_list = &gResponderCtx.rr_list[QTYPE_SRV_INDEX]; /* Move onto next entry */

    /* Fill-up SRV Record */
	rr_list->name = (BYTE *) (sd->sd_qualified_name);
    rr_list->type.Val = QTYPE_SRV;
	rr_list->ttl.Val = RESOURCE_RECORD_TTL_VAL;

	//rdlength is calculated/assigned last
    rr_list->srv.priority.Val = 0;
    rr_list->srv.weight.Val = 0;
    rr_list->srv.port.Val = sd->sd_port;

    /* Res Record Name is 
     * Service_Instance_name._srv-type._proto.domain */
	rr_list->rdata = (BYTE *) gHostCtx.szHostName;

    /* 2 bytes extra. One for Prefix Length for first-label.
     * Other one for NULL terminator */
	// then, add 6-byte extra: for priority, weight, and port

    rr_list->rdlength.Val = strlen((char *)rr_list->rdata)+2+6;

    rr_list->pOwnerCtx = (mDNSProcessCtx_common *) sd; /* Save back ptr */
    rr_list->valid = 1; /* Mark as valid */

    rr_list = &gResponderCtx.rr_list[QTYPE_TXT_INDEX]; /* Move onto next entry */

    /* Fill-up TXT Record with NULL data*/
    rr_list->type.Val = QTYPE_TXT;
	rr_list->name = (BYTE *) (sd->sd_qualified_name);

    /* Res Record data is what defined by the user */
	rr_list->rdata = (BYTE *) (sd->sd_txt_rec);
	
    /* Extra byte for Length-Byte of TXT string */
    rr_list->rdlength.Val = gSDCtx.sd_txt_rec_len+1;
    rr_list->ttl.Val = RESOURCE_RECORD_TTL_VAL; 
    rr_list->pOwnerCtx = (mDNSProcessCtx_common *) sd; /* Save back ptr */
    rr_list->valid = 1; /* Mark as valid */  
}
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
