yamamo2shun1/PICrouter/(commit log)

2012-08-04 Fixed version number of osc.h/.c
    [osc.c]
2012-08-14 Fixed the bug of sendOscMessage() function.
    If an osc command length is over 8 words, it has been a wrong format(too many '0x00' between command strings and arguments type strings).
    [osc.c, picrouter.c, picrouter.h]
2012-08-24 Fixed osc.h/.c
    Fixed the 'if' condition to branch some process when osc messages are received.
    [osc.c]
2012-08-24 Released PICrouter schematic and board v0.2
    [PICrouter.brd, PICrouter.sch]
2012-08-24 Released PICrouter schematic and board v0.3.
    [PICrouter.brd, PICrouter.sch]
2012-08-24 Released PICrouter schematic and board v0.4.
    [PICrouter.brd, PICrouter.sch]
2012-08-24 Released PICrouter schematic and board v0.5.
    [PICrouter.brd]
2012-08-24 Released PICrouter schematic and board v0.6.
    [PICrouter.brd, PICrouter.sch]
2012-08-24 Released PICrouter schematic and board v0.7.
    [PICrouter.brd, PICrouter.sch]
2012-08-24 Released PICrouter schematic and board v0.71.
    [PICrouter.brd, PICrouter.sch]
2012-08-24 Released PICrouter schematic and board v0.8.
    [PICrouter.brd, PICrouter.sch]
2012-08-24 Released PICrouter schematic and board v0.9.
    [PICrouter.brd, PICrouter.sch]
2012-08-24 Released PICrouter schematic and board v0.91.
    [PICrouter.brd, PICrouter.sch]
2012-08-24 Released PICrouter schematic and board v0.92.
    [PICrouter.brd, PICrouter.sch]
2012-08-24 Released PICrouter schematic and board v0.93.
    [PICrouter.brd, PICrouter.sch]
2012-08-24 Released PICrouter schematic and board v0.94.
    [PICrouter.brd, PICrouter.sch]
2012-08-24 Released PICrouter schematic and board v0.95
    Added logo data and pdf files.
2012-08-24 Fixed the sequence to switch to bootloader mode.
2012-08-25 Updated osc.h/.c
    Added osc messages for PWM.
    Fixed getIntArgumentAtIndex().
    [osc.c]
2012-08-25 Released PICrouter_OaUH v0.61.
    Added the OSC messages for PWM.
    /std/pwm/freq/set
    /std/pwm/freq/get
2012-08-28 Released PICrouter_OaUH v0.62.
    Supported the following OSC messages for PWM control.
    /std/pwm/duty/set
    /std/pwm/duty/get
    /std/pwm/state/set
    /std/pwm/state/get
2012-09-14 Released PIC32UBL_Max v0.9.
    added Standalone .app.
    [max.java.config.txt]
2012-09-24 Supported tkrworks LED_ENC board.
2012-10-06 不要なファイルを削除
2012-10-06 Added encoder.h/.c
2012-10-06 Added defines for LED_PAD_64.
2012-10-06 Added encoder.h/.c and Updated XC32 compiler to v1.11.
2012-10-06 Released PICrouter-OaUH v0.80.
    Supported LED_PAD_64
    Improved the individual intensity control for LED_ENC.
2012-12-25 PICrouter sch/brd v1.0 is released.
    [PICrouter.brd, PICrouter.sch]
2012-12-30 Implemented the soft reset function.
    [osc.c]
2012-12-30 PICrouter-OaUH v0.90 is released.
    Supported mutual USB_MIDI communication with a USB MIDI device.
    Added some OSC messages.
2012-12-30 PrB-MINI v0.60 is released.
    Supported a mutual USB_MIDI communication with a MIDI device connected to host port.
2013-01-18 Added new OSC messages and fixed some functions.
    [osc.c]
2013-01-18 Fixed the PWM processing.
2013-01-25 Fixed bug of "compareOSCAddress".
    [osc.c]
2013-01-25 Added the OSC message "[prefix]/lattice/led/all".
2013-02-04 Fixed some function for LED_PAD_16/64 and LED_ENC_ABS_32.
    [analog.c, button.c, encoder.c]
2013-02-05 Added encoder.h/.c and iosetting.h/.c
2013-02-05 Fixed the PWM variables initialization.
2013-02-06 Added sample max patch for PICrouter_OaUH.
2013-02-07 Changed USB process from interrupt to polling.
2013-02-07 Fixed setOSCPrefix() and setOSCHostName().
    [osc.c]
2013-02-08 PICrouter_OaUD v0.8 is released.
    Supported A/D and PWM ports configuration from USB_HID.
2013-02-15 Fixed the PWM port number definitions.
2013-03-05 Modified the ADC port number definition.
2013-03-06 Added the function to get current IO setting.
2013-03-06 Fixed to hold the IO setting state to array.
    [iosetting.c, iosetting.h]
2013-03-17 PICrouter v1.10 is released.
    Supported USB Dual Role.
    Added new OSC message "/sys/usb/mode/switch".
    Changed the project name from PICrotuer_OaUD.X to PICrouter.
2013-03-17 v0.98 release
    Added new OSC message "/std/spi/enable" .
    Added to get arguments length.
2013-03-17 PICrouter firmware v1.2.1 is released.
    Supported new OSC message "/std/spi/enable"
    Improved some OSC functions.
2013-03-18 Fixed and improved an A/D port processing with OSC.
    [picrouter.c, picrouter.h]
2013-03-19 Fixed array number from USE_ADC_NUM to AN_NUM.
    [analog.c]
2013-03-19 Fixed some functions name.
    [osc.c]
2013-03-19 PICrouter firmware v1.3.0 is released.
    Fixed to return error OSC messages.
    Supported the function to get port I/O setting.
    [picrouter.c, picrouter.h]
2013-03-19 PICrouter firmware v1.4.0 is released.
    Supported DHCP server.
    Supported auto switching of DHCP server and client.
2013-03-24 osc.h/.c v0.9.13 is released.
    Changed default send IP address to the multicast address "224.0.0.1".
    Supported the type tags "T", "F", "N" and "I".
    Fixed the bug of the process to convert a float value.
    [osc.c]
2013-03-25 Changed the OSC message address for PWM.
2013-03-25 Fixed the array's name.
    [picrouter.c]
2013-03-25 PICrouter firmware v1.4.2 release
    Fixed some bugs.
    [picrouter.c, picrouter.h]
2013-03-26 v0.9.15 release
    Added two OSC messages for SPI.
    Fixed a bug in getOSCPacket().
    [osc.c]
2013-03-26 v0.7 release
    Moved 3 functions for SPI from picrouter.c
    Added 2 functions to control a digital port.
2013-03-26 Fixed an increment value.
    [osc.c]
2013-03-26 Fixed the arguments order and Added the functions for SPI4.
    [iosetting.c, iosetting.h]
2013-03-26 Moved the definitions for SPI.
2013-03-26 PICrouter firmware v1.4.3 release
    Supported the SPI configuration and to get or set data.
    Fixed some bugs of OSC processing.
    [picrouter.c, picrouter.h]
2013-03-26 Added demo patch for SPI.
2013-03-26 Added Japanese tutorial4「OSCを使ったSPIの制御」.
2013-03-27 Fixed the received arc message.
    [analog.c]
2013-03-27 Fixed address string of some received OSC message.
    [osc.c]
2013-03-27 PICrouter firmware v1.4.4 release
    Fixed address string of some received OSC messages.
    [picrouter.c, picrouter.h]
2013-03-27 Fixed the argument type of /sys/usb/mode and /sys/soft/reset.
    [picrouter.c]
2013-03-28 PICrouter firmware v1.4.5 release
    Improved the overall performance of OSC sending and receiving.
    Added new OSC message to get the current firmware version.
2013-03-29 Added demo patch for PWM port control.
2013-03-29 Added the demo patch for SPI.
2013-03-30 PICrouter firmware v1.4.6 release.
    Fixed the bug of "/sys/host/name/get".
    [picrouter.c, picrouter.h]
2013-03-30 Fixed the memory leak in getStringArgumentAtIndex().
    [osc.c]
2013-03-30 PICrouter firmware v1.4.7 release.
    Improved the OSC functions.
    Fixed the memory leak.
    [picrouter.c, picrouter.h]
2013-04-02 Fixed the calculation bug of the total data size in the OSC message included string.
    [osc.c]
2013-04-02 PICrouter firmware v1.4.8 release
    Impremented the ring buffer and the state machine for receiving process is improved.
    Improved the overall OSC send/receive processing.
    Modified the error messages.
    [picrouter.c, picrouter.h]
2013-04-07 Support some OSC messages to control the PWM from touchOSC.
2013-04-17 Changed the timer1's period(0xFFFF -> 0x0FFF).
2013-04-21 Modified timer1's period from 0x0FFF to 0xFFFF.
2013-04-23 Modified the timer1's period.
2013-04-23 encoder.h/.c v0.60 release
    Supported the LED_ENC_ABS_32 module.
    Changed the all global variables to static variables.
    Added the set/get functions to access static variables.
2013-04-23 osc.h.c v1.0.1 release
    Added new OSC messages to control the LED_ENC_ABS_32.
    Improved the visibility of the source code.
    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
2013-04-23 pic router.h/.c v1.5.1 release
    Changed how to access to the global variables in the library.
    Modified the sendOSCTask() function for the timer5 interrupt.
    Improved the OSC sending and receiving performance.
    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
2013-04-24 Modified the interrupt level from 2 to 7.
2013-04-24 Fixed how to connect the LED_ENC_ABS_32.
    [encoder.c]
2013-04-24 Fixed the ring buffer process.
    [osc.c]
2013-04-24 Fixed to inhibit the the timer5(the OSC sending process) while receiving OSC packets.
    [picrouter.c, picrouter.h]
2013-04-24 Commented out the timer functions.
2013-04-26 Fixed some bugs receiving some OSC messages.
    /std/kit/rotary/led/bits/set
    /std/kit/rotary/led/step/set
    /std/kit/rotary/led/intensity/set
    /std/kit/rotary/led/intensity/get
    /std/kit/rotary/led/intensity/all/set
    [picrouter.c, picrouter.h]
2013-05-01 encoder.h/.c v0.6.2 release
    Supported the LED_ENC_32.
2013-05-01 osc.h/.c v1.0.4 release
    Modified some OSC message's address names.
    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
2013-05-01 PICrouter firmware v1.5.3 release
    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
    [picrouter.c, picrouter.h]
2013-05-04 encoter.h/.c v0.6.3 release
    Deleted the timer interrupt function.
    (Moved to the pic router.c)
2013-05-04 Supported the LED_PAD_16 module.
2013-05-04 Added the OSC messages to control the LED_PAD_16.
2013-05-05 PICrouter firmware v1.5.4 release.
    Supported to control the LED_PAD_16.
    Reduced the merry usage.
    Improved how to control the intensity of the LED_ENC_32 and the LED_ENC_ABS_32.
2013-05-15 Fixed some bugs of the LEDs intensity control.
    [encoder.c, picrouter.c, picrouter.h]
2013-05-20 Fixed a bug of an OSC message receiving.
    [osc.c]
2013-05-20 Fixed a bug of the mDNS's auto rename service.
    [ZeroconfMulticastDNS.c]
2013-05-25 PICrouter firmware v1.5.8 release
    Supported to control a character LCD module with the OSC.
    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
    [picrouter.c, picrouter.h]
2013-06-14 Added new OSC messages for I2C.
2013-06-14 PICrouter firmware v1.5.9 release
    Added new OSC messages for I2C.
    * The current version only supports the Microchip serial eeprom 24LC256.
2013-06-16 Added some functions for I2C communication.
2013-06-16 PICrouter firmware v1.5.10 release.
    Supported to control I2C with OSC.
    * The latest version is only supported a master send/receive.
2013-06-16 Fixed a bug to send data from Master I2C.
    [iosetting.c, iosetting.h]
2013-06-16 Fixed a bug to send data from the master I2C.
    [picrouter.c]
2013-06-18 Fixed the bug of the OSC message "/sys/host/name/set".
    [picrouter.c]
2013-06-18 Changed the timer5 interval.
2013-06-19 Improved the processing when the rotary encoder is stopped.
2013-07-10 button.h/.c v0.7 release
    Supported the RGB_PAD_16(RGB LEDs intensity control).
    Added function's comment's.
2013-07-10 PICrouter firmware v1.7.0 release.
    Supported the OSC messages to control the RGB_PAD_16.
    Supported the OSC messages to adjust an analog value's resolution(8bit or 10bit).
    Added function's comments.
    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
    [picrouter.c, picrouter.h]
2013-08-29 Updated the mxj libraries.
    [max.java.config.txt]
2013-08-29 Deleted Unnecessary files.
    [max.java.config.txt]
2013-09-05 Added the OSC messages "/sys/discover/devices" and "/sys/discovered/device" to discover a PICrouter which connected to a local network.
2013-09-05 PICrouter firmware v1.10.0 Release. Supported a function to discover a PICrouter which connected to a local network. Improved the RGB_PAD_16/8's LED control performance. Disabled the Zeroconf Link Lo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
2013-09-06 PICrouter firmware v1.10.1 Release. Improved the OSC message to discover a PICrouter. Fixed some bugs.
    [picrouter.c, picrouter.h]
2013-11-18 PICrouter firmware v1.11.0 release Supported to use an external SRAM(Microchip 23K256) with the OSC processing. Changed the timer of PWM from timer23 to timer2.
2014-02-17 PICrouter for mruby ver.0.2.1 release. Changed mruby version from github head to stable v1.0.0. fixed the bug of the host name initialization.
    [picrouter.c, picrouter.h]
2014-02-22 Modified the I2C's control way.
2014-02-22 Modified the timer5 interrupt interval.
2014-02-22 PICrouter v0.2.3 release.
    Moved the USB callback functions to the usb_callback.h/.c.
    Added some functions for mruby.
    Separated the OSC received process to the following parts.
    1. Standard Messages
    2. MIDI Messages
    3. CDC Messages
    4. System Messages
    Appended the toggle process to the OSC message "/std/onboard/led".
2014-02-24 PICrouter v1.12.0 release.
    Deleted the USB callback functions and global variables in picrouter.c.
    Added header and source file(usb_callback.h/.c) for the USB callback functions.
    Fixed the initialization of the host name.
    [picrouter.c, picrouter.h]
2014-03-03 Modified the macro's name for turning on and off the onboard LEDs and getting onboard switch's state.
2014-04-15 Added the new function "sendPad4()" for the PItCh controller.
2014-04-15 Modified the timer5's interval.
2014-04-15 PICrouter v1.12.2 is released. Fixed the bug of the host USB_MIDI sending and receiving process.
    [picrouter.c, picrouter.h]
2014-04-25 PICrouter firmware v1.13.0 release. Supported the WiFly RN-131C module. Changed the priority of Time4 and Timer5.
2014-04-26 Fixed the bug that the process to interpret a received OSC message is stopped.
    [osc.c]
2014-08-05 Supported the DAC+ADC Shield for PICrouter. Supported the UART Wi-Fi module RN134(131).
2014-08-05 PICrouter firmware v1.15.0 is released.
    Supported the UART Wi-Fi module RN134(131).
    Supported the RGB_PAD_8L
    Supported the DAC+ADC Shield for PICrouter.
2014-08-05 Commented out the timer5 initialization and the USB CDC process.
